NeekoNoNeko/Engineering_Competition/3D/42步进电机连接部件/微信图片_20241001151234.jpg

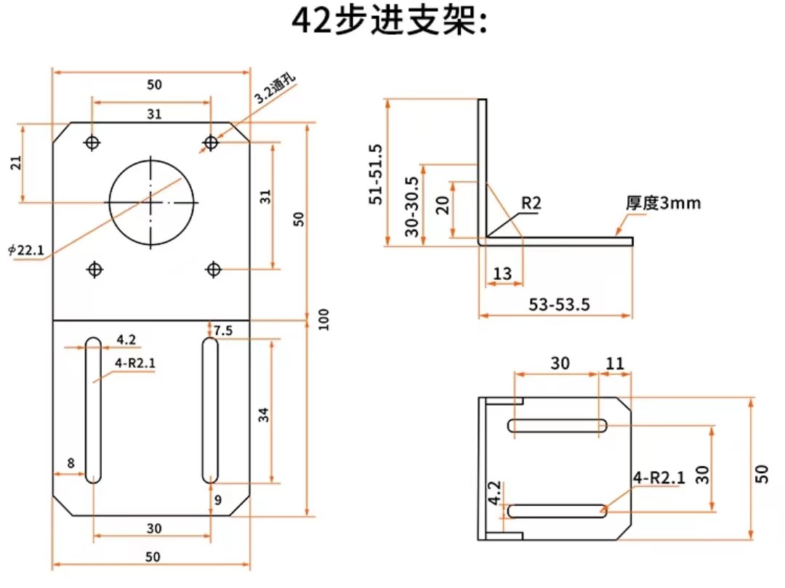
3D/42步进电机连接部件/微信图片_20241001151234.jpg
