NeekoNoNeko/Engineering_Competition/3D/SolidWorks/备份/42.jpg

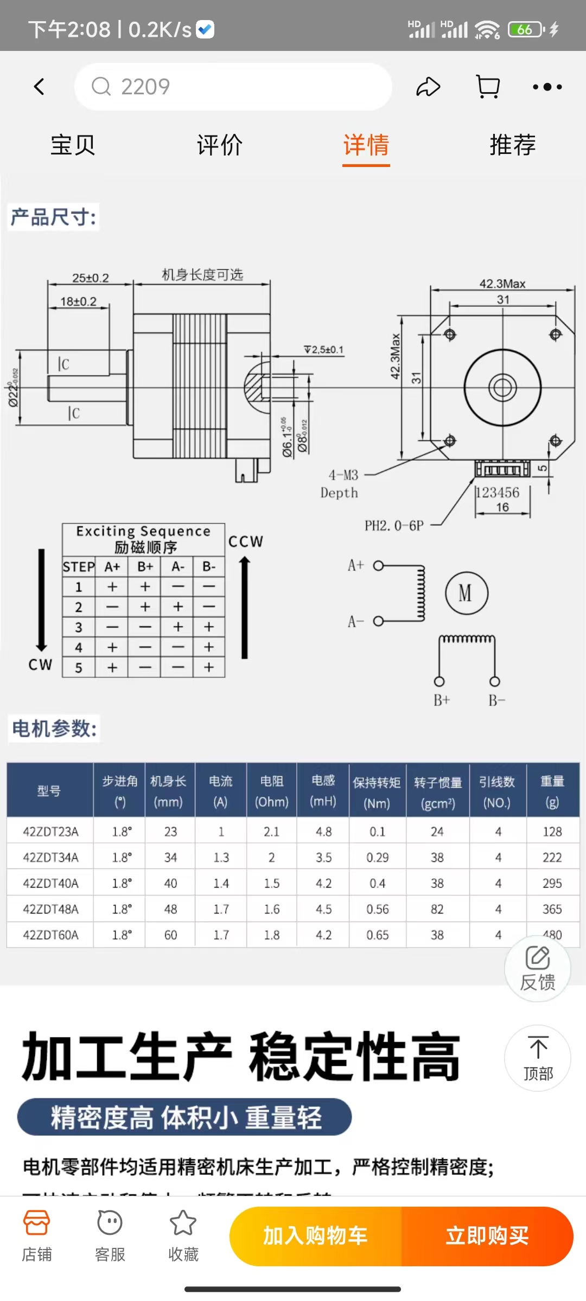
3D/SolidWorks/备份/42.jpg
