NeekoNoNeko/Engineering_Competition/3D/SolidWorks/备份/93cb4cf8e45870571cec4679b83ad59.jpg

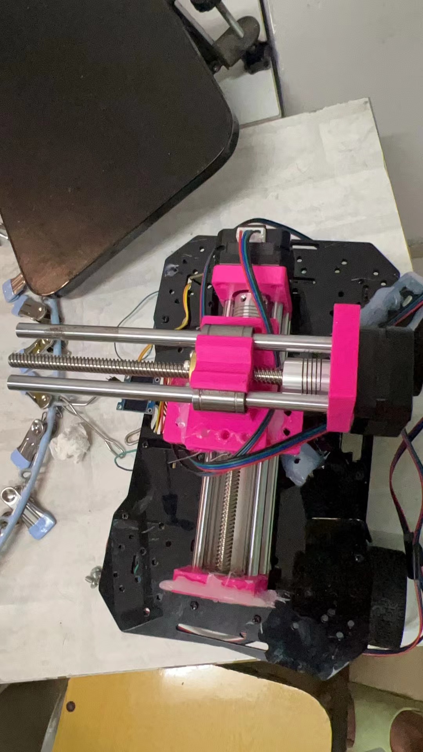
3D/SolidWorks/备份/93cb4cf8e45870571cec4679b83ad59.jpg
