NeekoNoNeko/Engineering_Competition/3D/SolidWorks/备份/KFL08丝杆座.jpg

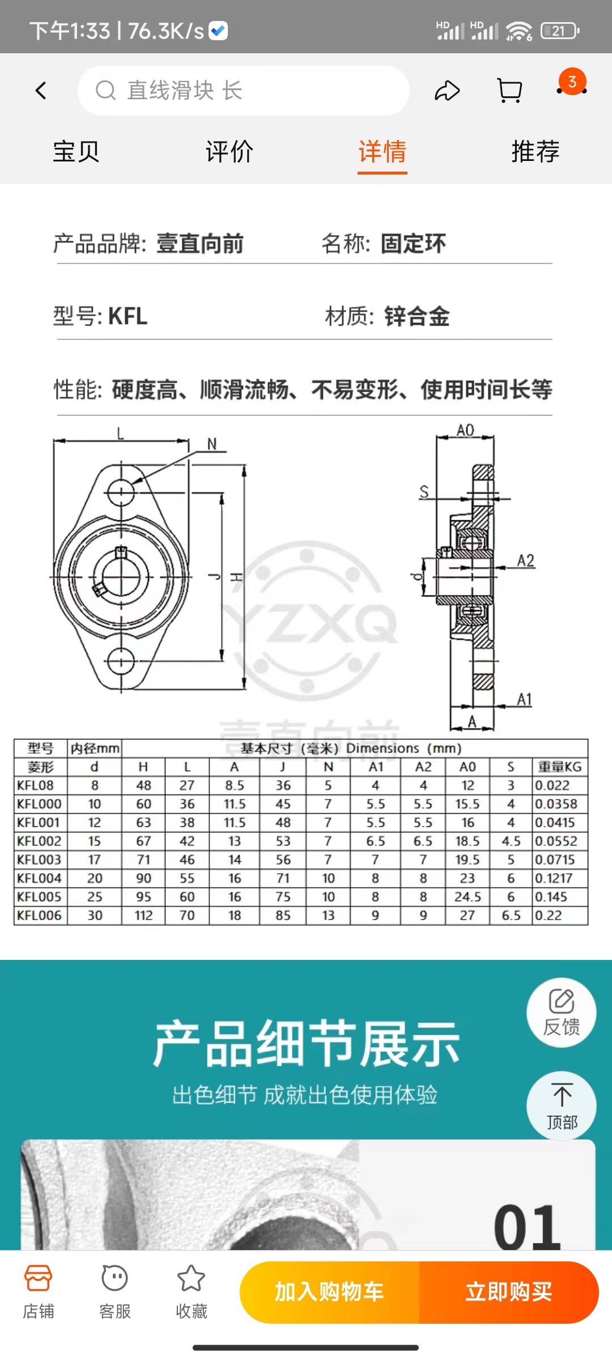
3D/SolidWorks/备份/KFL08丝杆座.jpg
