NeekoNoNeko/Engineering_Competition/3D/SolidWorks/备份/openmv/apriltag/tag36h11_9.png

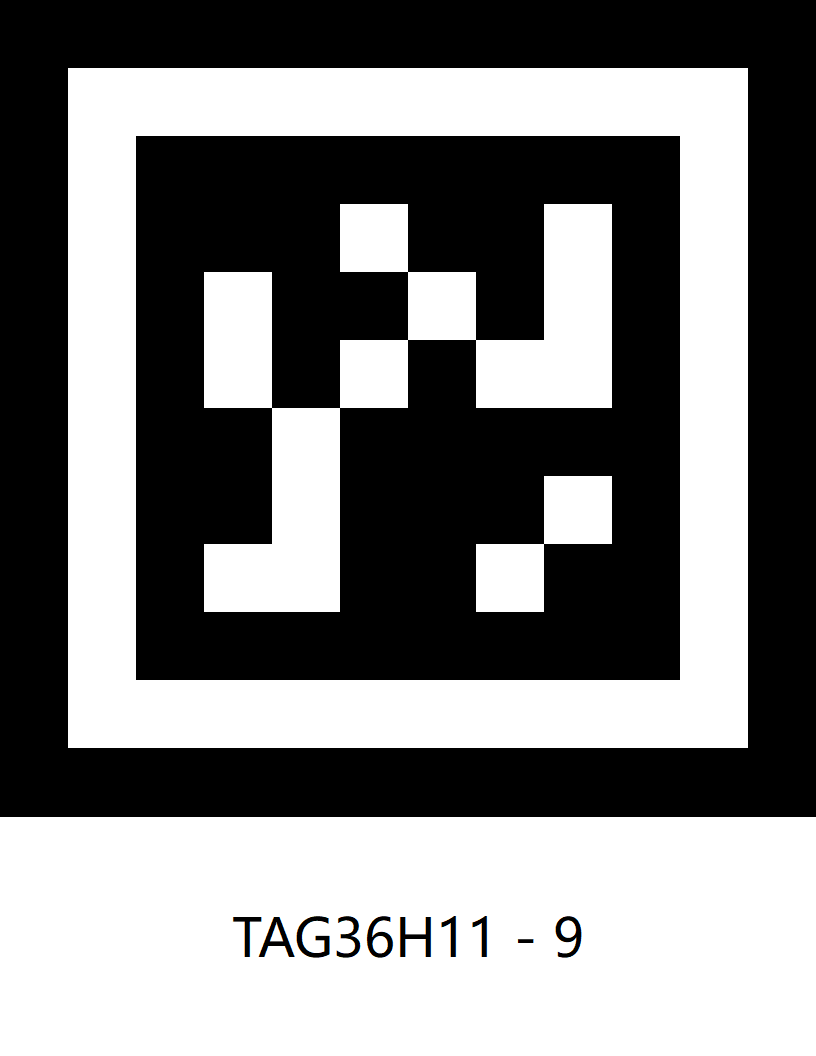
3D/SolidWorks/备份/openmv/apriltag/tag36h11_9.png
