NeekoNoNeko/Engineering_Competition/3D/SolidWorks/备份/SK8光轴座.png

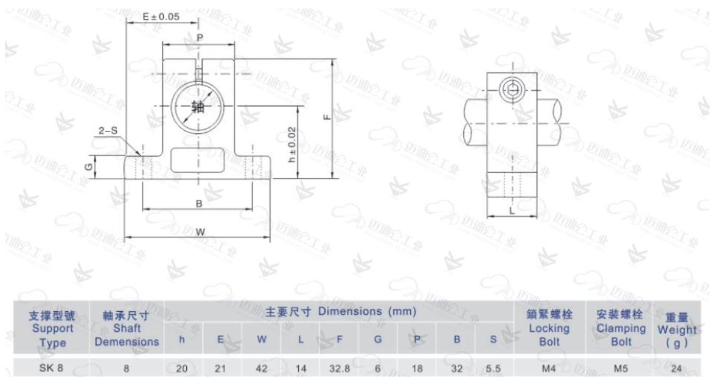
3D/SolidWorks/备份/SK8光轴座.png
