NeekoNoNeko/Engineering_Competition/3D/SolidWorks/备份/try.bmp

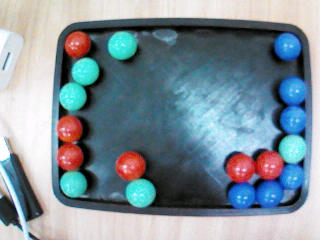
3D/SolidWorks/备份/try.bmp
