NeekoNoNeko/Engineering_Competition/3D/SolidWorks/备份/伺服电机MG996R舵机/temp/reference datasheet/Main reference.jpg

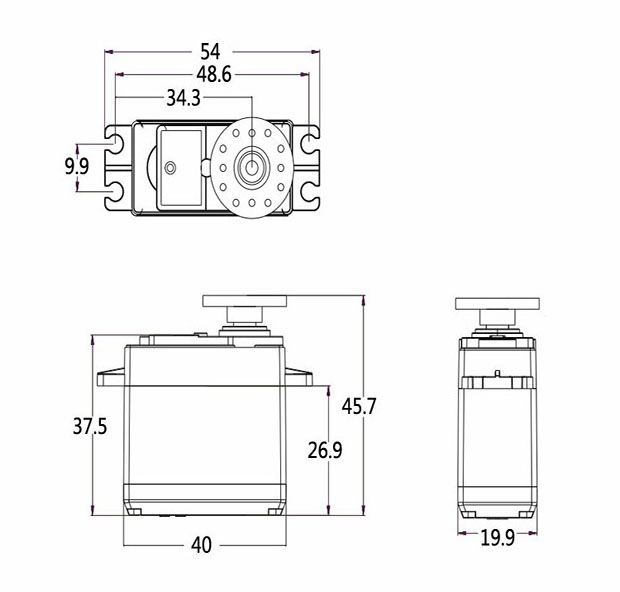
3D/SolidWorks/备份/伺服电机MG996R舵机/temp/reference datasheet/Main reference.jpg
