NeekoNoNeko/Engineering_Competition/3D/SolidWorks/备份/伺服电机MG996R舵机/temp/reference datasheet/others.png

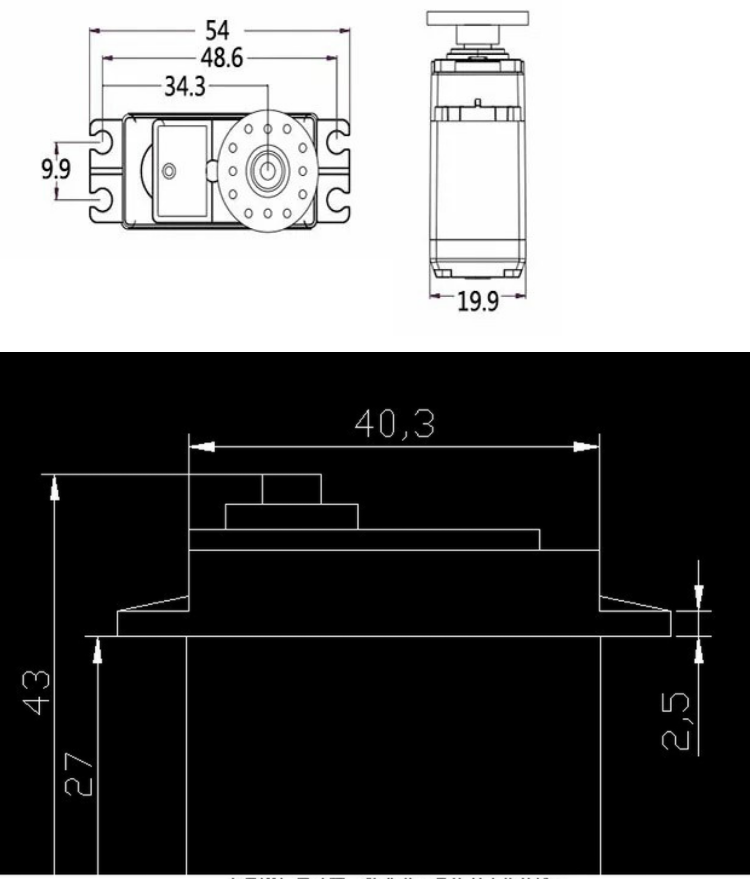
3D/SolidWorks/备份/伺服电机MG996R舵机/temp/reference datasheet/others.png
