NeekoNoNeko/Engineering_Competition/3D/SolidWorks/备份/矢量概念机械臂爪标准伺服/temp/3.JPG

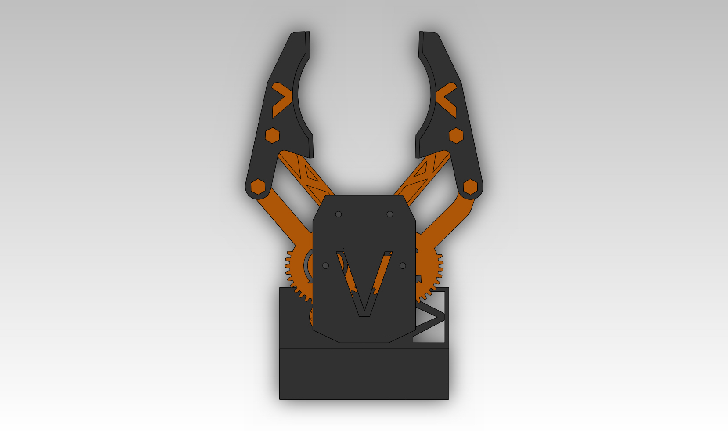
3D/SolidWorks/备份/矢量概念机械臂爪标准伺服/temp/3.JPG
