NeekoNoNeko/Engineering_Competition/file/机器结构图纸/266a45ca8b23765033c3c1784f71e38.png

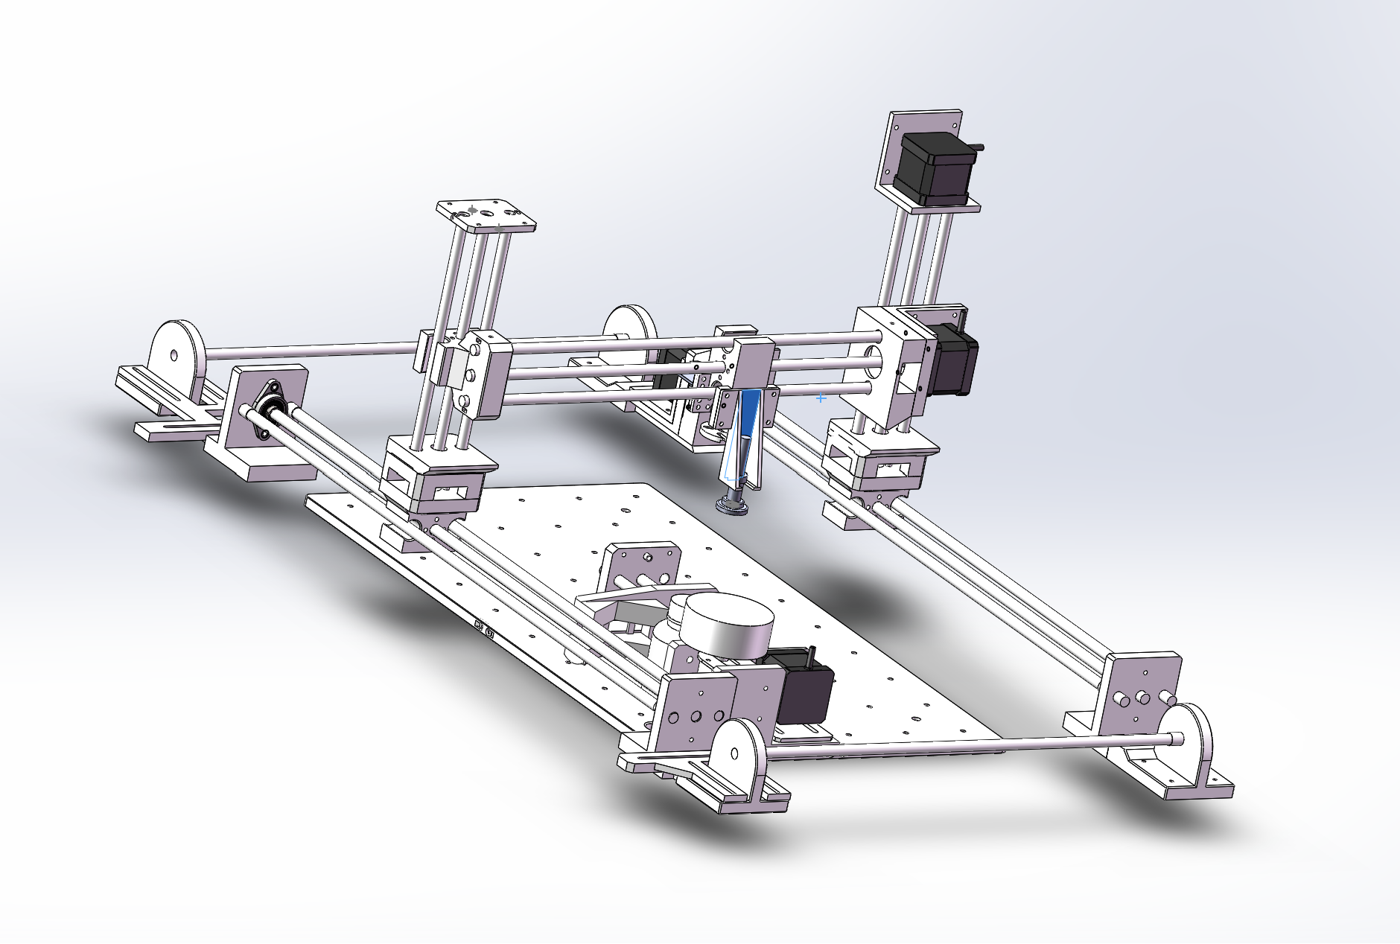
file/机器结构图纸/266a45ca8b23765033c3c1784f71e38.png
