NeekoNoNeko/Engineering_Competition/file/机器结构图纸/OpenMV支架.png

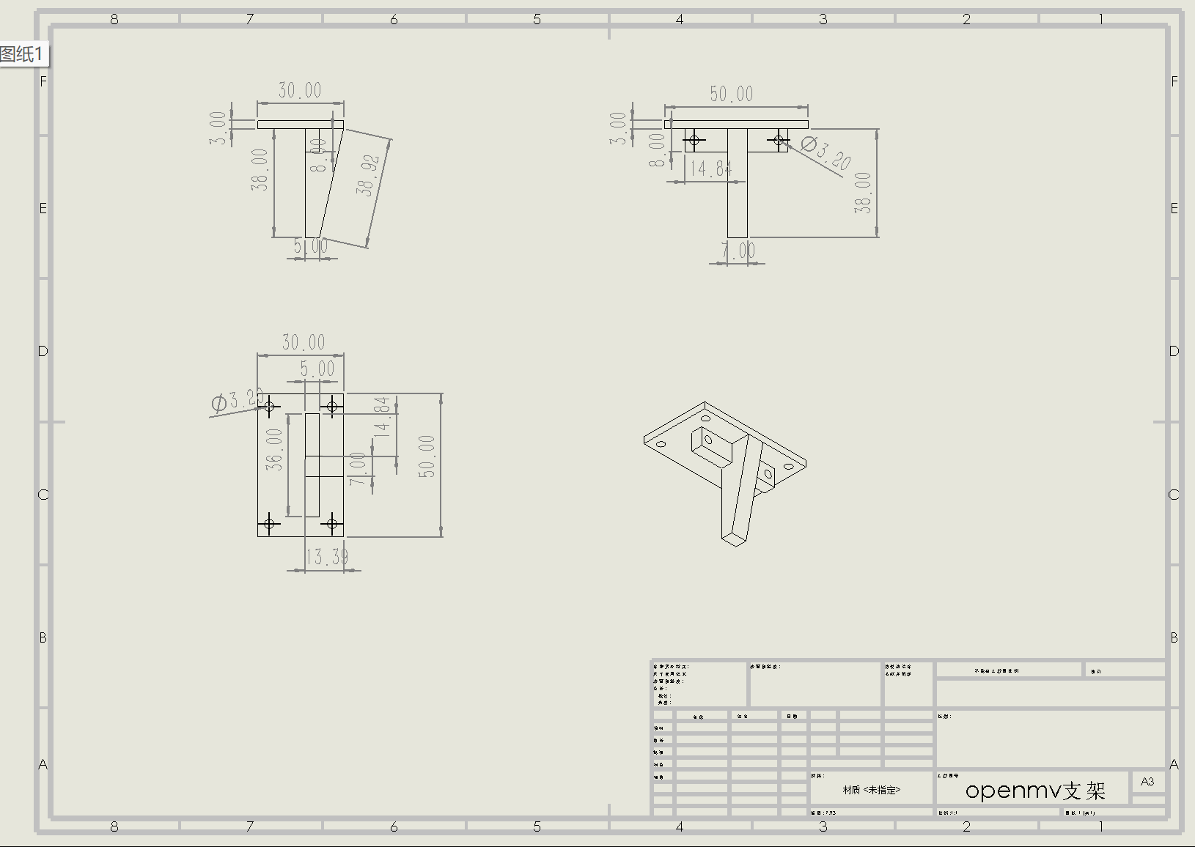
file/机器结构图纸/OpenMV支架.png
