NeekoNoNeko/Engineering_Competition/3D/总装测试/物料表.xlsx

物料名称 | 编号 | 单价 | 数量 | 总计 | 位置
压铸角码套装 |  | 1.14 | 16 | 18.24
M5套装(L10) |  |  | 28 |  | 丝杆支架
 |  |  | 8 |  | XY轴电机支架
 |  |  | 12 |  | 防撞台
 |  |  | 8 |  | 光轴连接器
 |  |  | 4
平垫圈M3 | EPDA-S1W-K-3 |  | 8 |  | 法兰型导向轴支座 | 垫片多买(垫高度)
 |  |  | 12 |  | (电机支架)
内六角圆柱头螺钉M3-L20 | EDLA-S1-M3-L20 |  | 8
法兰型导向轴支座T形 | BEUP-K-D8 |  | 4
十字槽盘头螺钉M3-L6 | EDLU-S1-M-M3-L6 |  | 12 |  | 电机支架
十字槽沉头螺钉M3-L18 | EDLW-S1-M3-L18 |  | 12
十字槽沉头螺钉M3-L6 | EDLW-S1-M3-L6 |  | 8 |  | 滑台螺丝
十字槽沉头螺钉M3-L8 | EDLW-S1-M3-L8 |  | 6 |  | 滑台连型材螺丝
T型螺母M3 | TPAA-N-6-M3 |  | 20 |  | 滑台连型材螺母
内六角圆柱头螺钉M3-L16 | EDLA-S1-M3-L16 |  | 16 |  | 垫块螺丝
内六角圆柱头螺钉M5-L8 | EDLA-S1-M5-L8 |  | 12 |  | 侧面螺丝
内六角圆柱头螺钉M3-L10 | EDLA-S1-M3-L10 |  | 4 |  | 侧面螺丝
内六角圆柱头螺钉M3-L12 | EDLW-S1-M3-L12 |  | 8 |  | 丝杆螺母螺钉
内六角圆柱头螺钉M5-L12 | EDLA-S1-M5-L12 |  | 16 |  | 侧面支撑
 |  |  | 8 |  | 丝杆组合套+T型滑台连型材
平垫圈M5 |  |  | 16 |  | 侧面支撑
 |  |  | 8 |  | 丝杆组合套+T型滑台连型材
T型螺母M5 |  |  | 16 |  | 侧面支撑
十字槽沉头螺钉M3L-20 | EDLW-S1-M3-L20
内六角圆柱头螺钉M3-L8 | EDLA-S1-M3-L8 |  | 8 |  | Z轴滑台
十字槽盘头螺钉M3-L45 |  |  | 8 |  | Z轴滑台
内六角圆柱头螺钉M3-L6 | EDLA-S1-M3-L6 |  | 4 |  | Y轴滑台
