NeekoNoNeko/Engineering_Competition/3D/SolidWorks/备份/KFL08/KFL08.SLDASM

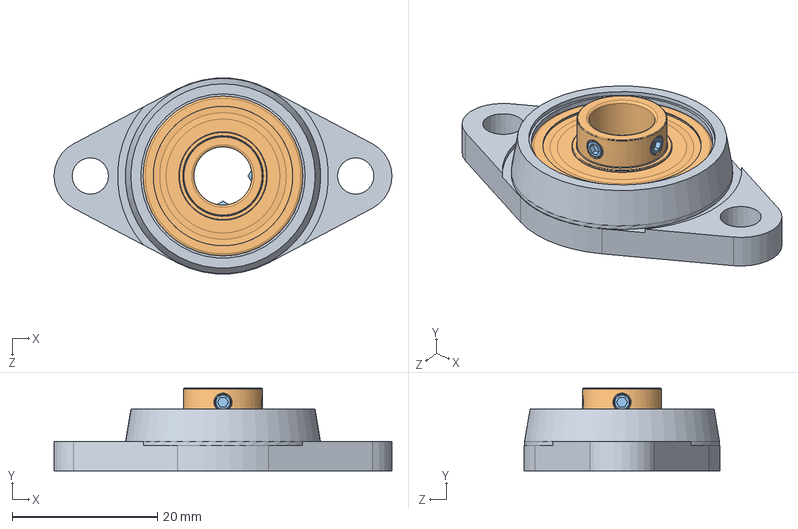
[picture p48: CAD file, 2024-10-24]
3D/SolidWorks/备份/KFL08/KFL08.SLDASM
46.5 x 11.4 x 26.9 mm
FLANGE^KFL08
BEARING^KFL08
socket set screw cone point_am x 2
