NeekoNoNeko/Engineering_Competition/3D/SolidWorks/备份/链接滑台装配体.SLDASM

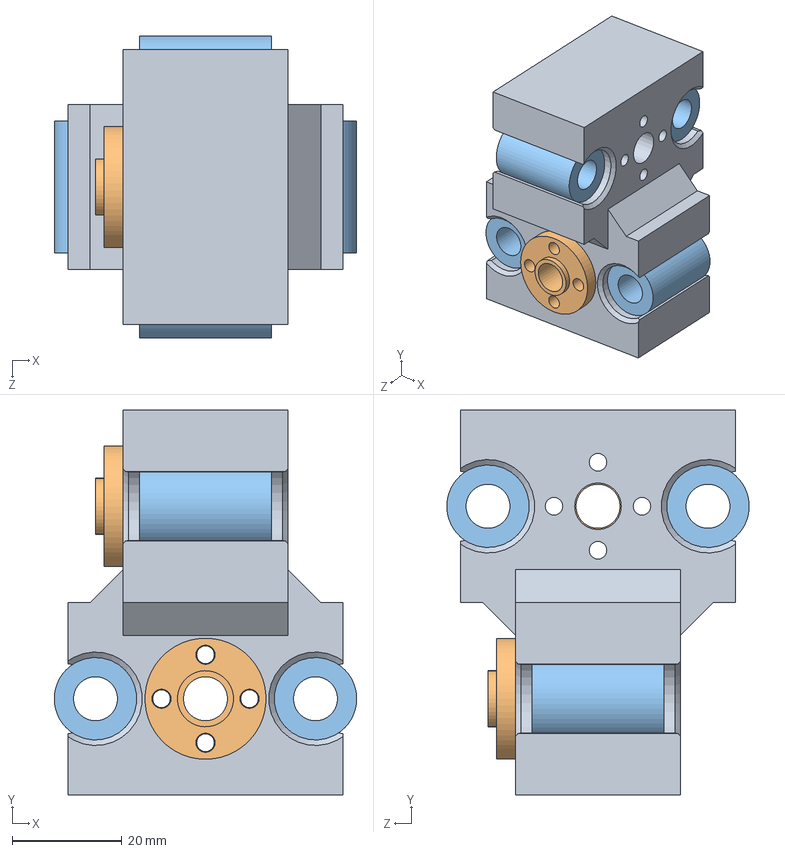
[picture p49: CAD file, 2024-10-24]
3D/SolidWorks/备份/链接滑台装配体.SLDASM
55.0 x 70.0 x 55.0 mm
链接滑台
丝杆螺母 x 2
直线轴承2.0 x 4
