NeekoNoNeko/Engineering_Competition/3D/SolidWorks/备份/底盘.SLDASM

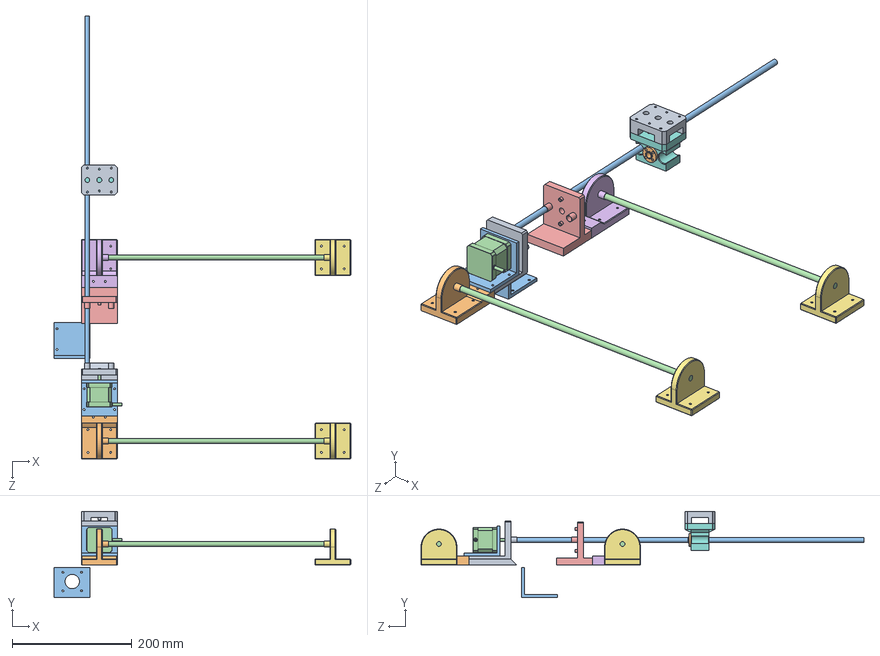
[picture p50: CAD file, 2024-10-24]
3D/SolidWorks/备份/底盘.SLDASM
495.3 x 143.8 x 740.0 mm
近电机端3.0
远电机端3.0右
光轴600
光轴400mm x 2
远电机端4.0
远电机端3.0左
远电机端3.0中 x 2
滑台4.0
远电机端小车.032.0
丝杆螺母
电机支架4.0 x 2
42系列两相混合式步进电机[42HS04A]
