NeekoNoNeko/Engineering_Competition/3D/SolidWorks/备份/钢制KK模组直线滑台TKK100[TKK100-1080]/钢制KK模组直线滑台TKK100[TKK100-1080].sldasm

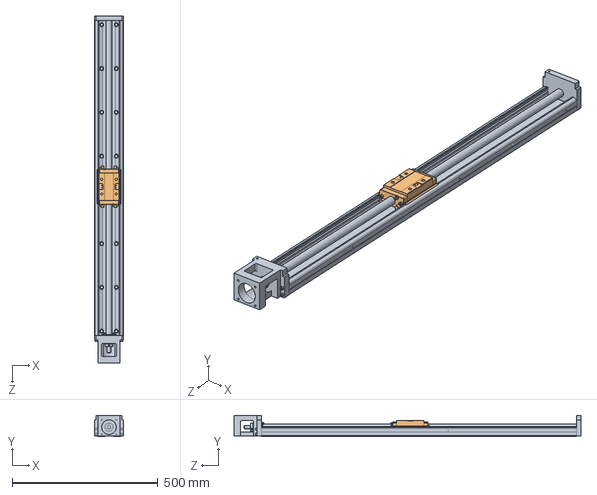
[picture p51: CAD file, 2024-10-24]
3D/SolidWorks/备份/钢制KK模组直线滑台TKK100[TKK100-1080]/钢制KK模组直线滑台TKK100[TKK100-1080].sldasm
100.0 x 72.0 x 1189.0 mm
钢制KK模组直线滑台TKK100[TKK100-1080]_1
钢制KK模组直线滑台TKK100[TKK100-1080]_2
