NeekoNoNeko/Engineering_Competition/3D/SolidWorks/备份/梯形丝杠╱梯形丝杆螺母[TN8X10X2NR╱200×200Cu]/梯形丝杠╱梯形丝杆螺母[TN8X10X2NR╱200×200Cu].sldasm

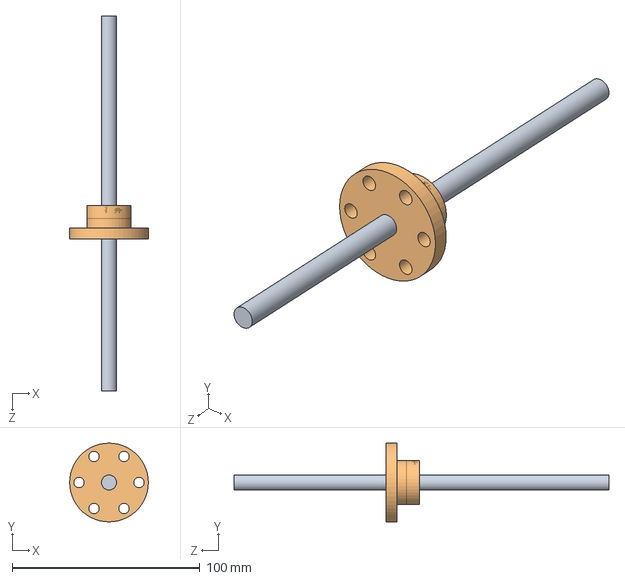
[picture p52: CAD file, 2024-10-24]
3D/SolidWorks/备份/梯形丝杠╱梯形丝杆螺母[TN8X10X2NR╱200×200Cu]/梯形丝杠╱梯形丝杆螺母[TN8X10X2NR╱200×200Cu].sldasm
42.0 x 42.0 x 200.0 mm
梯形丝杠╱梯形丝杆螺母[TN8X10X2NR╱200×200Cu]_丝杠
梯形丝杠╱梯形丝杆螺母[TN8X10X2NR╱200×200Cu]_螺母
