NeekoNoNeko/Engineering_Competition/3D/SolidWorks/备份/滑台装配体.SLDASM

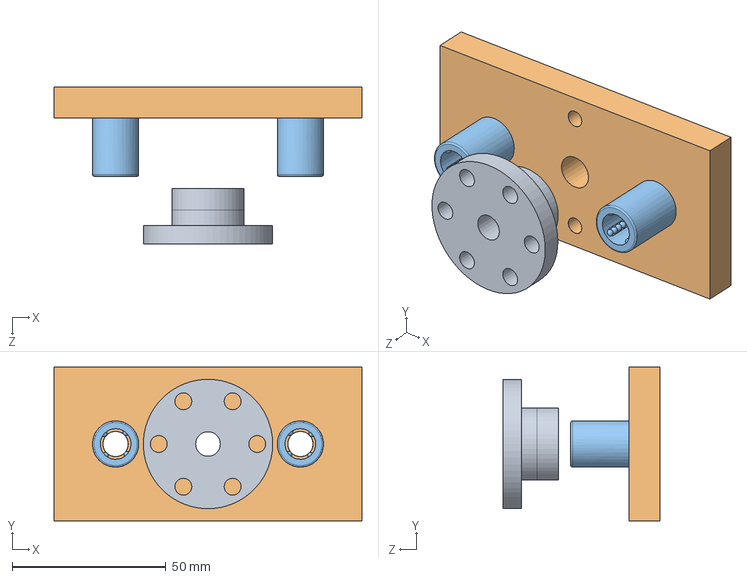
[picture p53: CAD file, 2024-10-24]
3D/SolidWorks/备份/滑台装配体.SLDASM
100.0 x 50.0 x 51.0 mm
螺母
直线轴承LMF-K-H系列[LMF8UU] x 2
