NeekoNoNeko/Engineering_Competition/3D/SolidWorks/XY连接装配体短.SLDASM

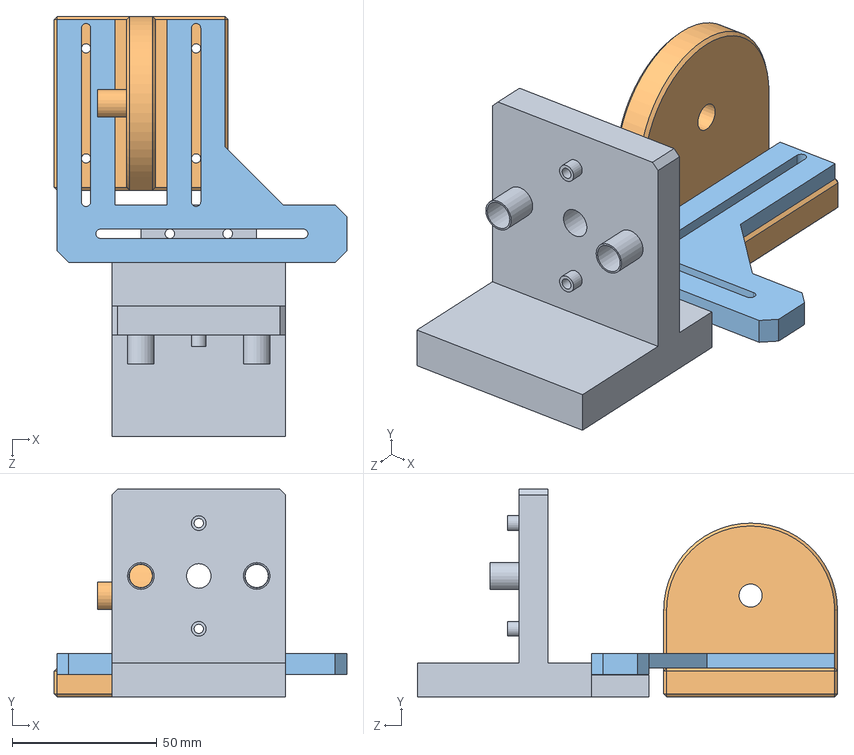
[picture p54: CAD file, 2024-10-24]
3D/SolidWorks/XY连接装配体短.SLDASM
101.0 x 71.8 x 145.0 mm
远电机端4.0
远电机端3.0中
XY连接短
