NeekoNoNeko/Engineering_Competition/3D/SolidWorks/备份/远电机右转向.SLDASM

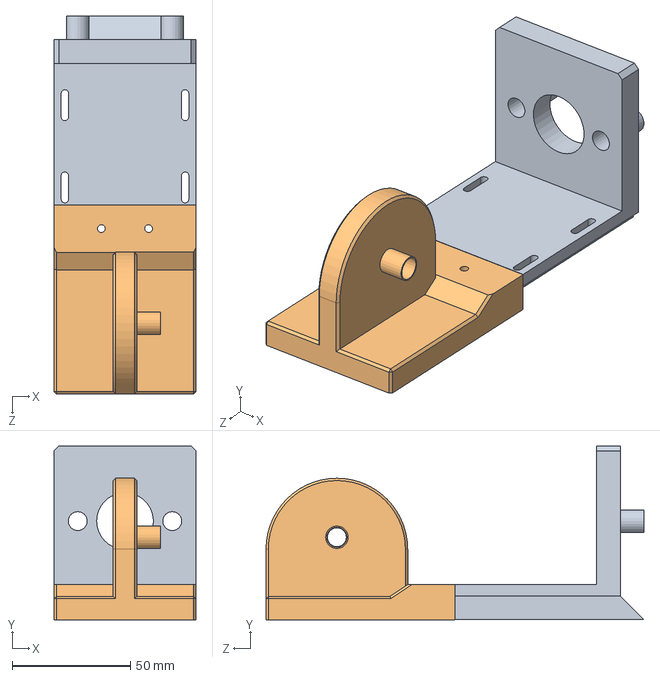
[picture p56: CAD file, 2024-10-24]
3D/SolidWorks/备份/远电机右转向.SLDASM
60.0 x 73.6 x 160.0 mm
近电机端3.0
远电机端3.0
