NeekoNoNeko/Engineering_Competition/3D/SolidWorks/备份/高横杆装配体.SLDASM

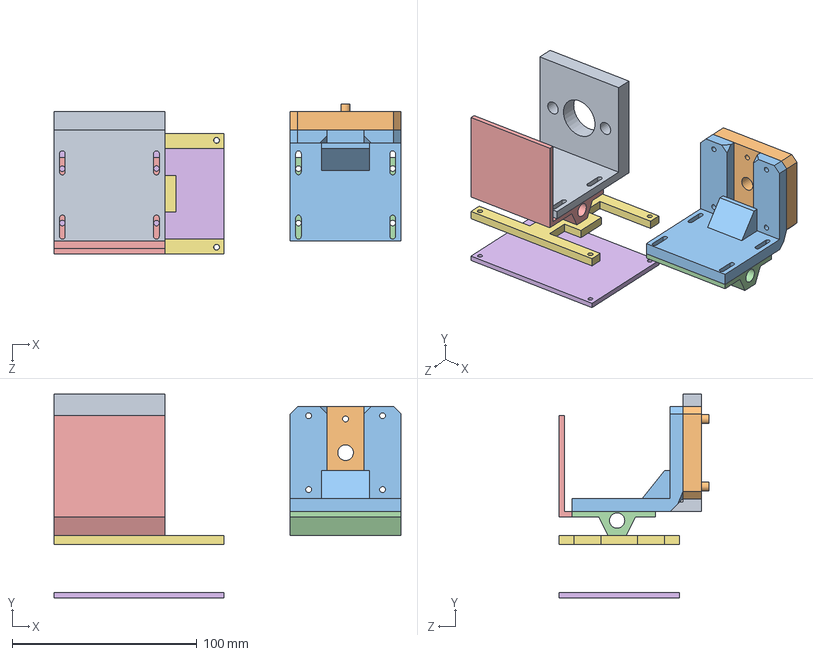
[picture p57: CAD file, 2024-10-24]
3D/SolidWorks/备份/高横杆装配体.SLDASM
187.9 x 110.4 x 81.0 mm
近电机端2.0
远电机端.3.0
高连接横梁右远电机端
高连接横梁右2
高连接横梁左2
主控板
主控板支撑
