NeekoNoNeko/Engineering_Competition/3D/SolidWorks/备份/X轴滑台装配体1.SLDASM

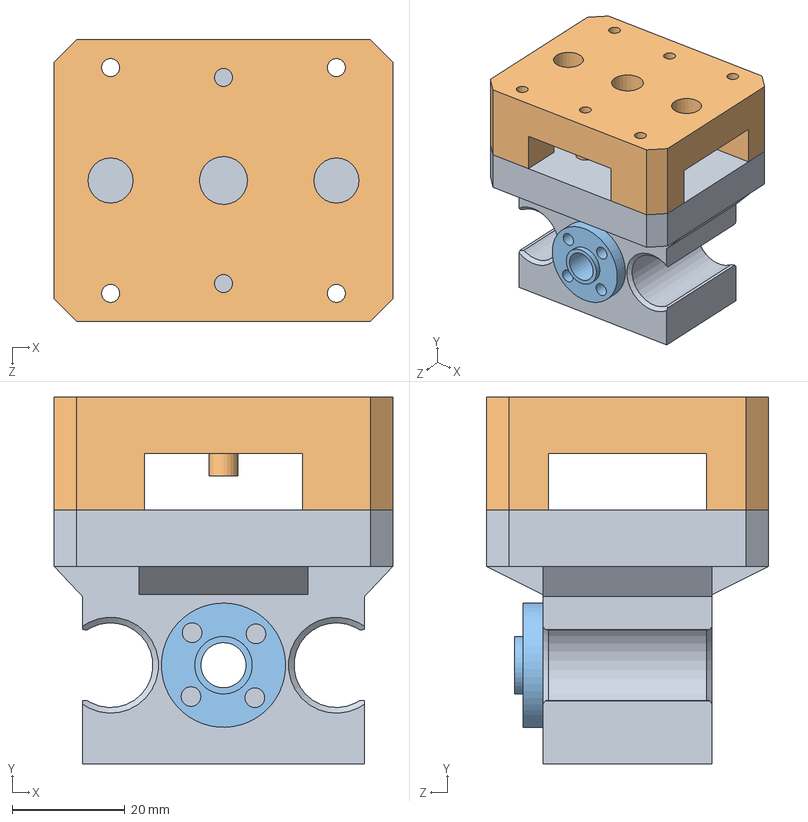
[picture p58: CAD file, 2024-10-24]
3D/SolidWorks/备份/X轴滑台装配体1.SLDASM
60.0 x 65.0 x 50.0 mm
滑台4.0
远电机端小车.032.0
丝杆螺母
