NeekoNoNeko/Engineering_Competition/3D/SolidWorks/备份/连接装配体plusmax.SLDASM

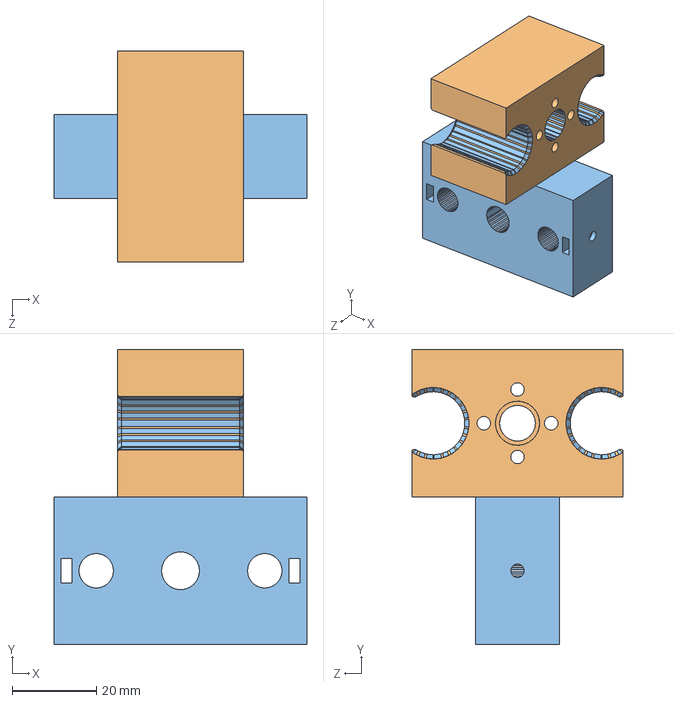
[picture p59: CAD file, 2024-10-24]
3D/SolidWorks/备份/连接装配体plusmax.SLDASM
60.0 x 70.0 x 50.0 mm
