NeekoNoNeko/Engineering_Competition/3D/SolidWorks/备份/仅Y轴.SLDASM

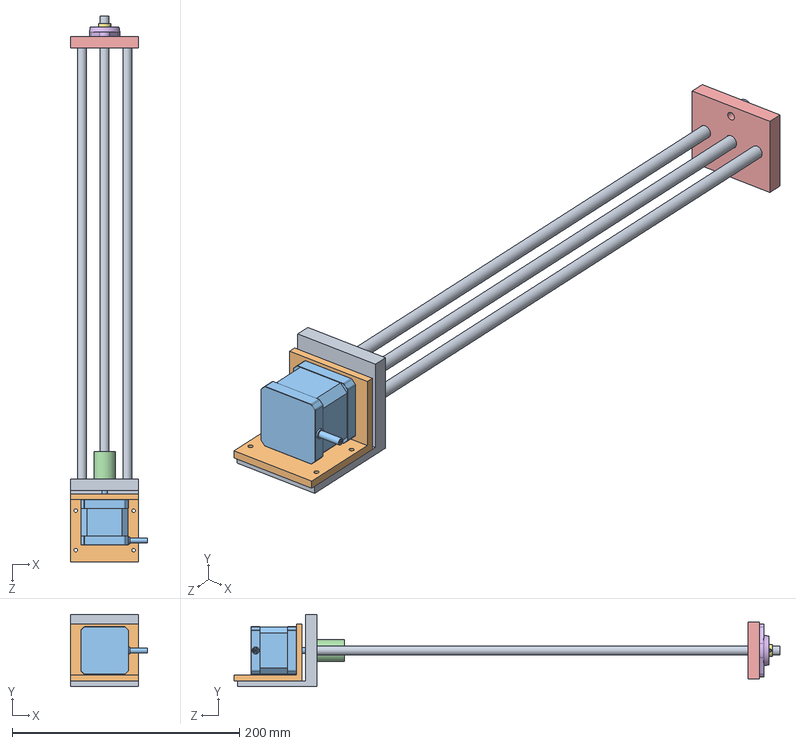
[picture p60: CAD file, 2024-10-24]
3D/SolidWorks/备份/仅Y轴.SLDASM
67.6 x 63.5 x 481.0 mm
近电机端2.0
电机支架4.0
42系列两相混合式步进电机[42HS04A]
弹性联轴器
远电机端2.0
FLANGE^KFL08
BEARING^KFL08
socket set screw cone point_am x 2
光轴400mm x 3
