NeekoNoNeko/Engineering_Competition/3D/SolidWorks/备份/夹子装配体.SLDASM

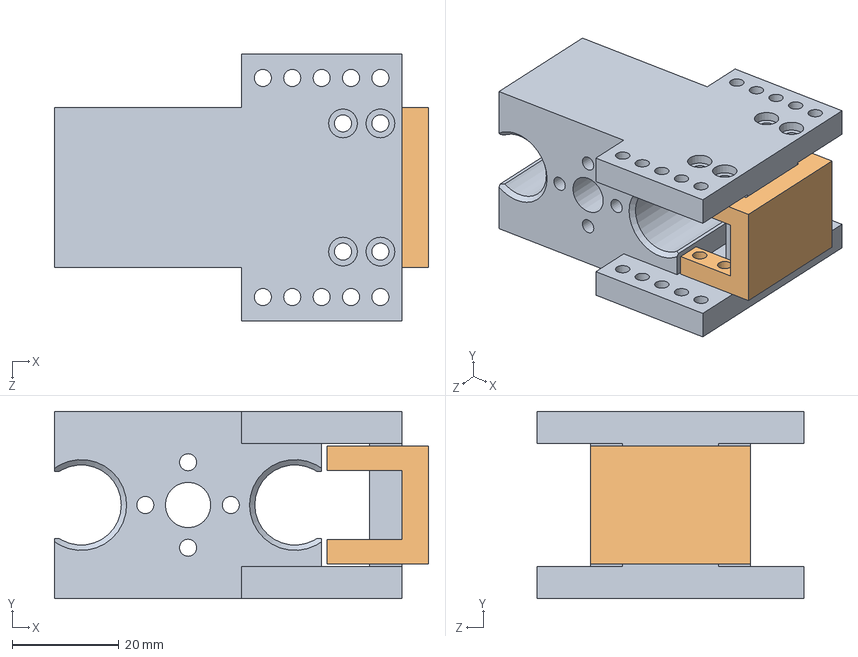
[picture p61: CAD file, 2024-10-24]
3D/SolidWorks/备份/夹子装配体.SLDASM
70.0 x 35.0 x 50.0 mm
滑台支架
夹子
