NeekoNoNeko/Engineering_Competition/3D/SolidWorks/备份/电机支架装配体2.0.SLDASM

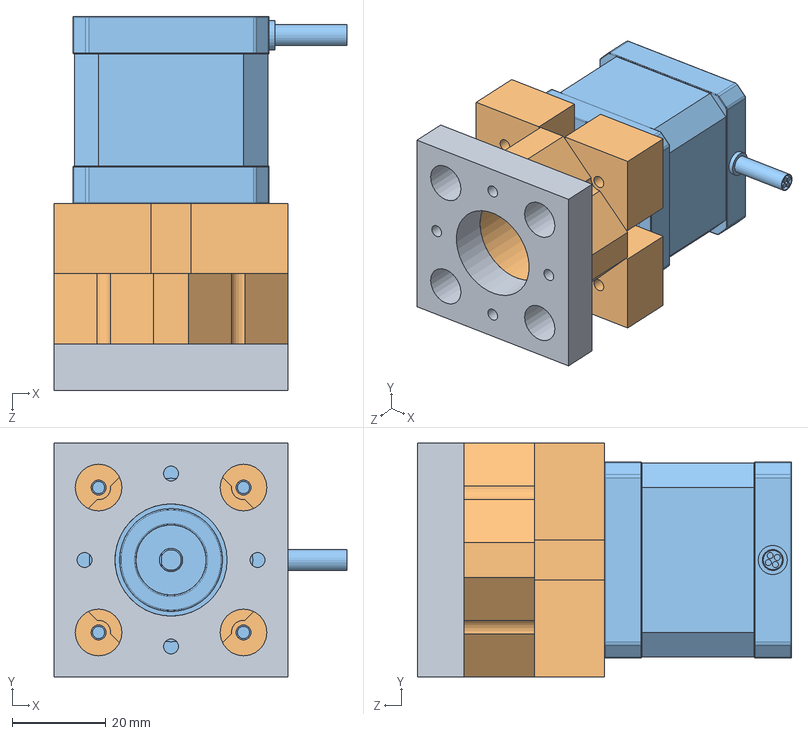
[picture p62: CAD file, 2024-10-24]
3D/SolidWorks/备份/电机支架装配体2.0.SLDASM
62.6 x 50.0 x 80.0 mm
近电机端
电机支架3.0
