NeekoNoNeko/Engineering_Competition/3D/SolidWorks/直流减速电机支架装配体.SLDASM

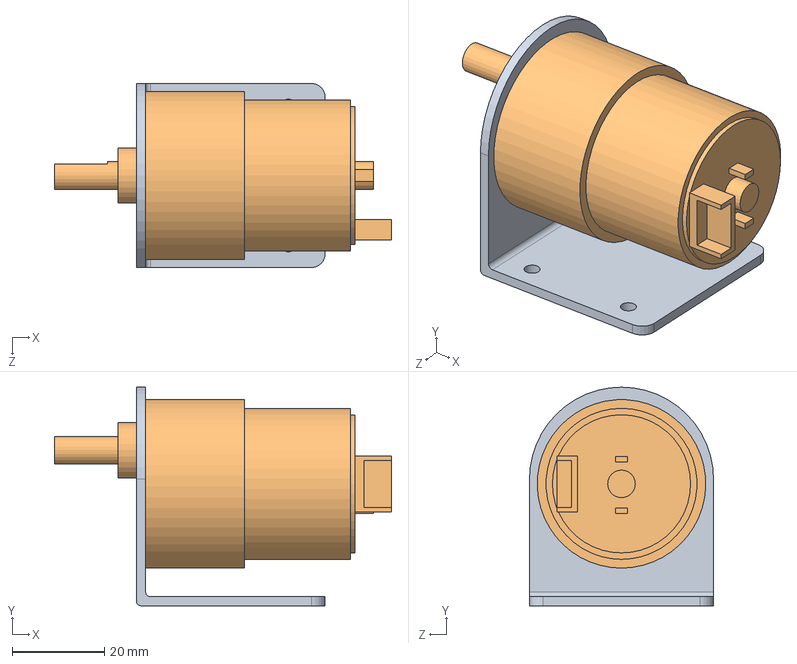
[picture p63: CAD file, 2024-10-24]
3D/SolidWorks/直流减速电机支架装配体.SLDASM
73.2 x 47.5 x 40.0 mm
直流减速电机支架
MG513直流减速电机
