NeekoNoNeko/Engineering_Competition/3D/SolidWorks/挡板.SLDASM

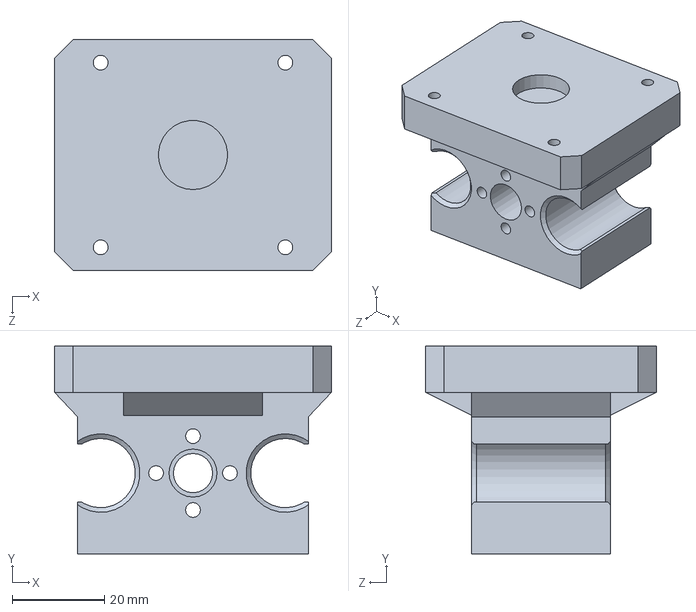
[picture p64: CAD file, 2024-10-24]
3D/SolidWorks/挡板.SLDASM
60.0 x 45.0 x 50.0 mm
