NeekoNoNeko/Engineering_Competition/3D/SolidWorks/备份/滑台装配体3.0.SLDASM

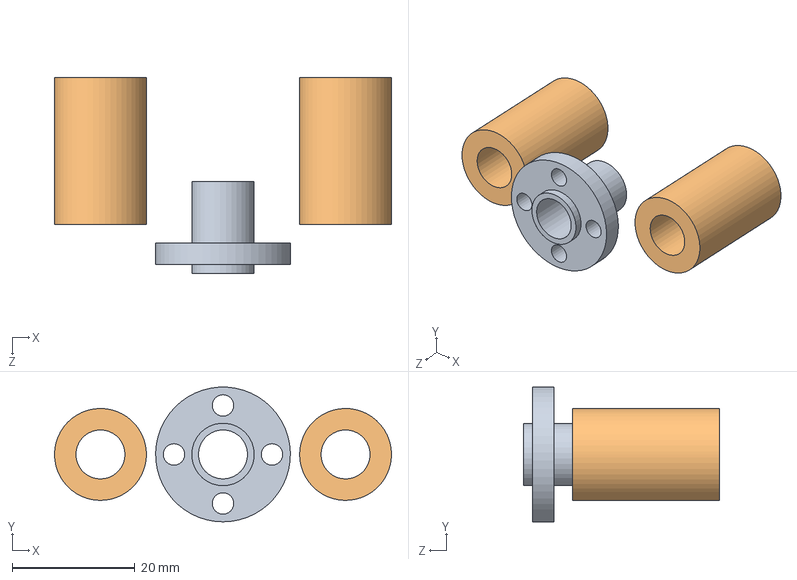
[picture p65: CAD file, 2024-10-24]
3D/SolidWorks/备份/滑台装配体3.0.SLDASM
55.0 x 22.0 x 32.0 mm
丝杆螺母
直线轴承2.0 x 2
