NeekoNoNeko/Engineering_Competition/3D/SolidWorks/连接装配体.SLDASM

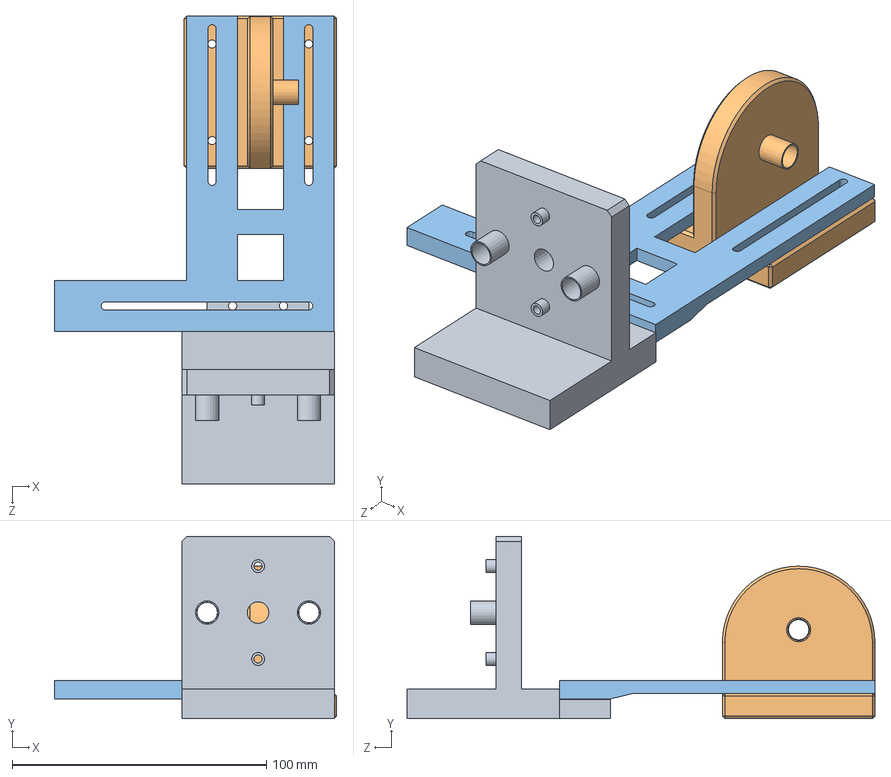
[picture p66: CAD file, 2024-10-24]
3D/SolidWorks/连接装配体.SLDASM
111.0 x 71.8 x 184.0 mm
远电机端4.0
远电机端3.0中
XY连接
