NeekoNoNeko/Engineering_Competition/3D/SolidWorks/备份/远电机端小车装配体.SLDASM

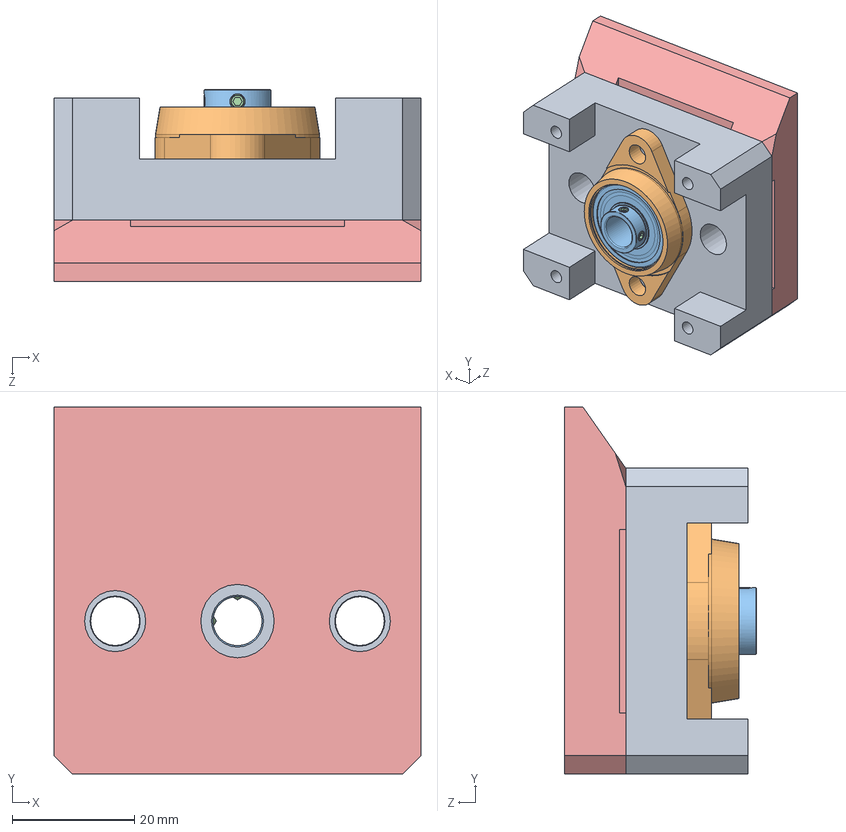
[picture p67: CAD file, 2024-10-24]
3D/SolidWorks/备份/远电机端小车装配体.SLDASM
60.0 x 60.0 x 31.4 mm
远电机端小车2.0
FLANGE^KFL08
BEARING^KFL08
socket set screw cone point_am x 2
Z轴挡板
