NeekoNoNeko/Engineering_Competition/3D/SolidWorks/备份/远电机端装配体.SLDASM

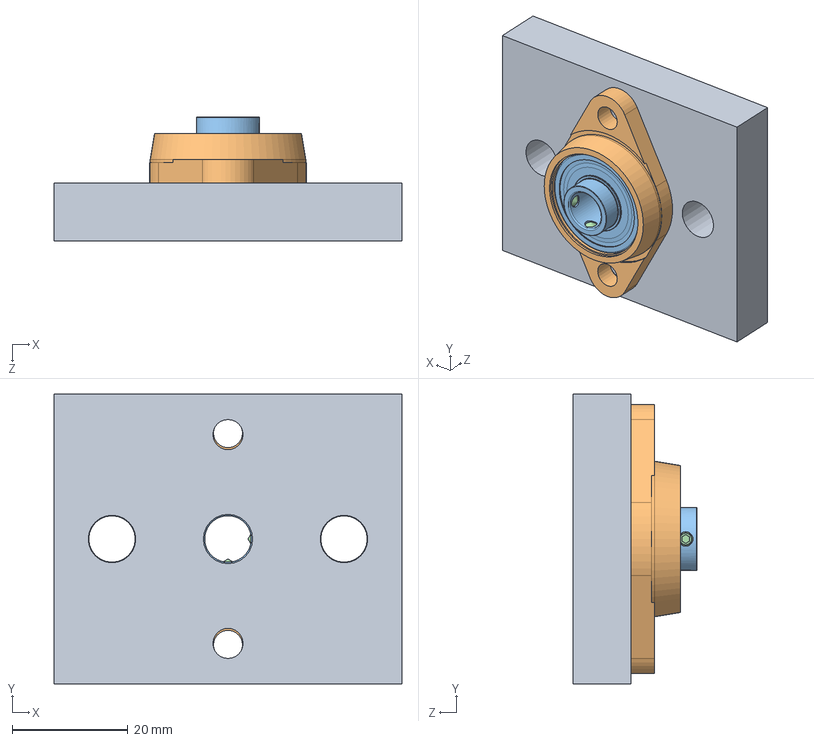
[picture p68: CAD file, 2024-10-24]
3D/SolidWorks/备份/远电机端装配体.SLDASM
60.0 x 50.0 x 21.4 mm
远电机端2.0
FLANGE^KFL08
BEARING^KFL08
socket set screw cone point_am x 2
