NeekoNoNeko/Engineering_Competition/3D/SolidWorks/备份/远电机装配体左.SLDASM

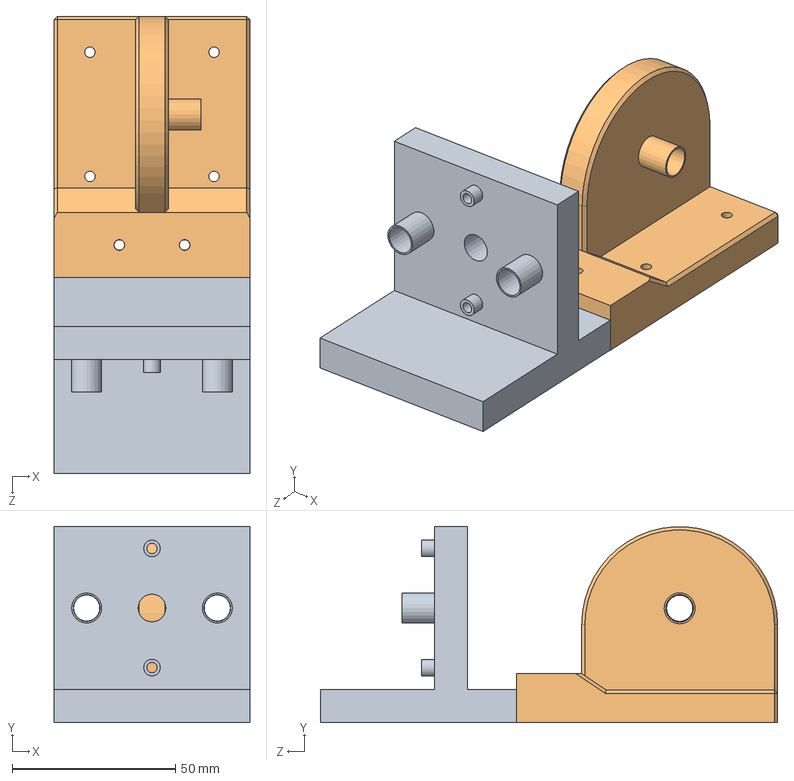
[picture p70: CAD file, 2024-10-24]
3D/SolidWorks/备份/远电机装配体左.SLDASM
60.0 x 60.1 x 140.0 mm
远电机端4.0
远电机端3.0左
