NeekoNoNeko/Engineering_Competition/3D/SolidWorks/备份/电机支架装配体3.0.SLDASM

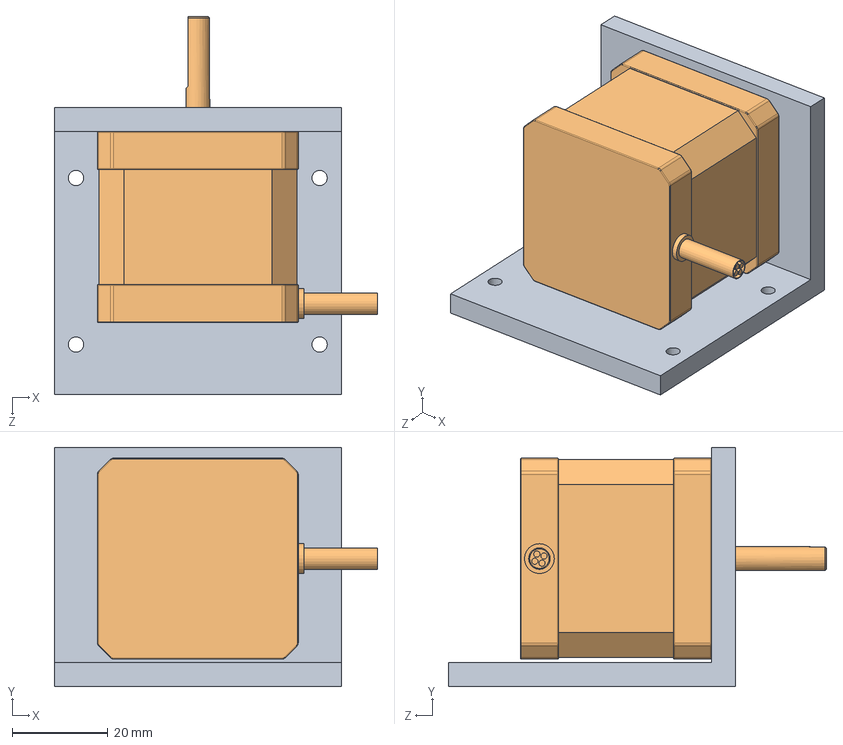
[picture p71: CAD file, 2024-10-24]
3D/SolidWorks/备份/电机支架装配体3.0.SLDASM
67.6 x 50.0 x 79.0 mm
电机支架4.0
42系列两相混合式步进电机[42HS04A]
