NeekoNoNeko/Engineering_Competition/3D/SolidWorks/备份/Z轴.SLDASM

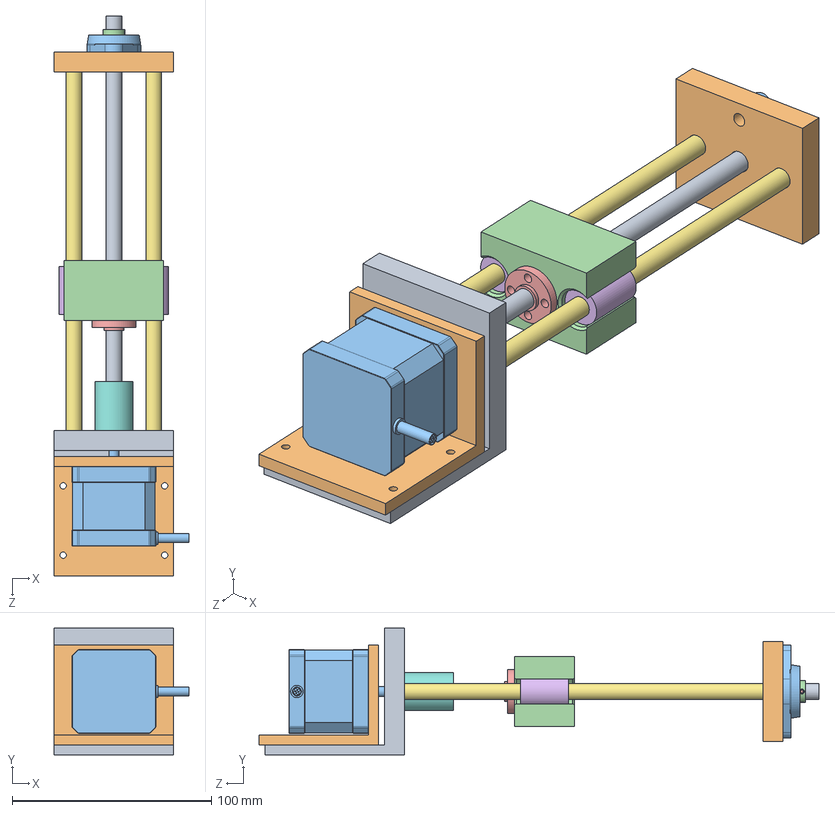
[picture p72: CAD file, 2024-10-24]
3D/SolidWorks/备份/Z轴.SLDASM
67.6 x 63.5 x 281.0 mm
近电机端2.0
电机支架4.0
42系列两相混合式步进电机[42HS04A]
滑台3.0
丝杆螺母
直线轴承2.0 x 2
200mm光轴 x 2
弹性联轴器
丝杠
远电机端2.0
FLANGE^KFL08
BEARING^KFL08
socket set screw cone point_am x 2
