NeekoNoNeko/Engineering_Competition/3D/SolidWorks/备份/电机支架装配体.SLDASM

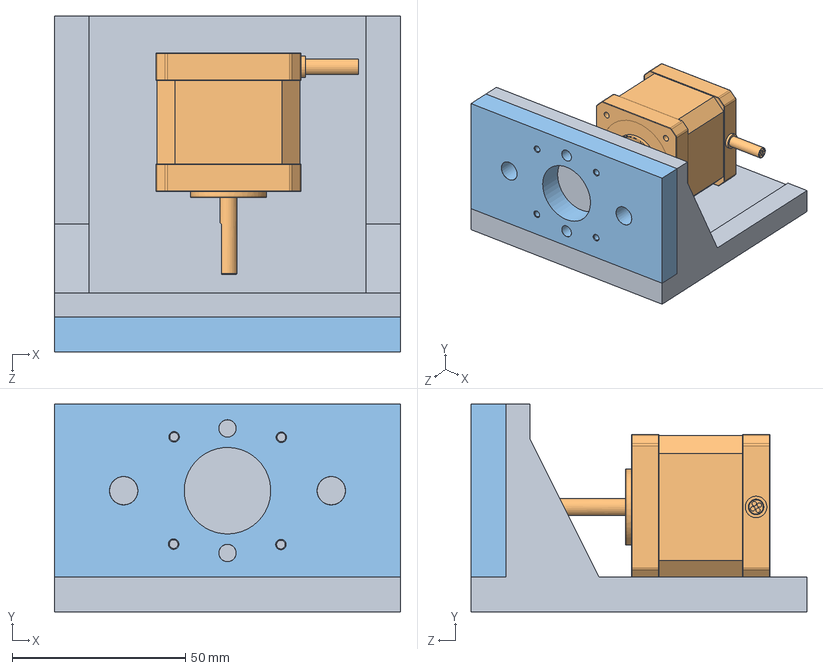
[picture p73: CAD file, 2024-10-24]
3D/SolidWorks/备份/电机支架装配体.SLDASM
100.0 x 60.0 x 97.0 mm
电机支架
42系列两相混合式步进电机[42HS04A]
远电机端
