NeekoNoNeko/Engineering_Competition/3D/SolidWorks/备份/电机装配体1.SLDASM

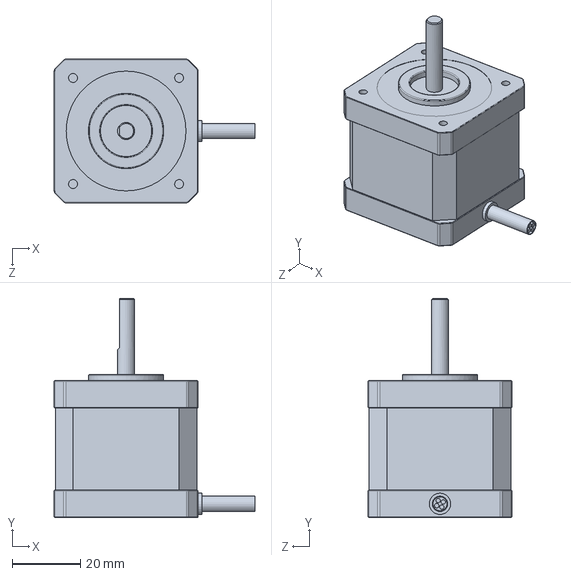
[picture p74: CAD file, 2024-10-24]
3D/SolidWorks/备份/电机装配体1.SLDASM
58.6 x 64.0 x 42.0 mm
