NeekoNoNeko/Engineering_Competition/3D/SolidWorks/备份/滑台装配体2.0.SLDASM

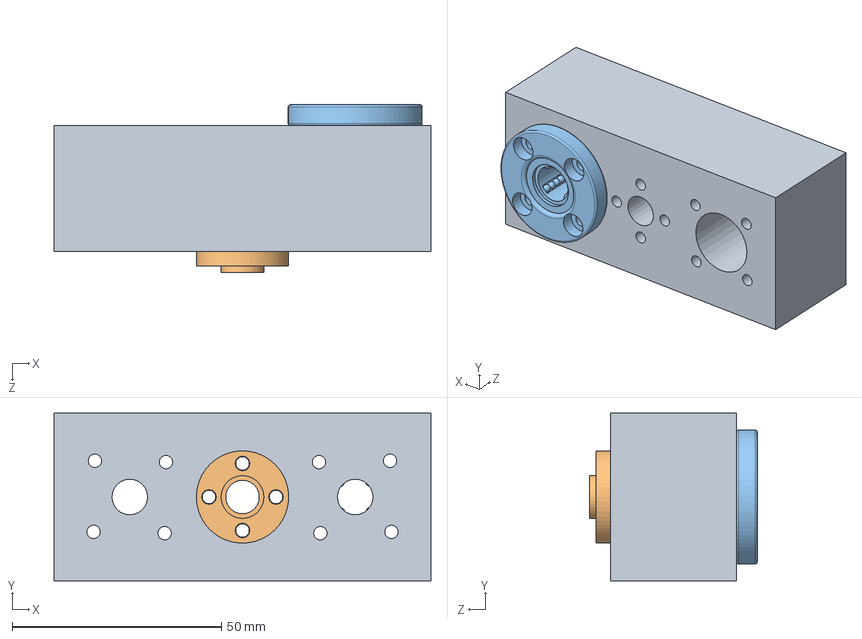
[picture p75: CAD file, 2024-10-24]
3D/SolidWorks/备份/滑台装配体2.0.SLDASM
90.0 x 40.0 x 40.0 mm
滑台2.0
丝杆螺母
