NeekoNoNeko/Engineering_Competition/3D/SolidWorks/备份/支架滑台装配体.SLDASM

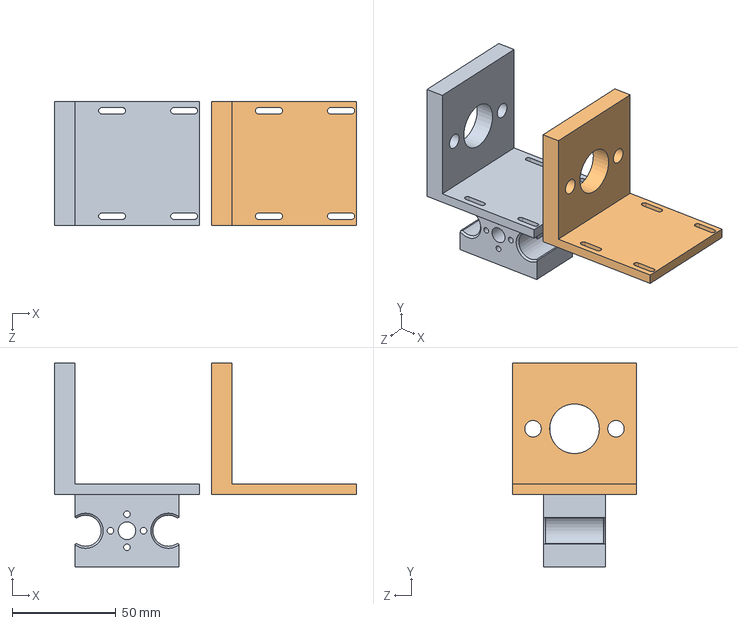
[picture p76: CAD file, 2024-10-24]
3D/SolidWorks/备份/支架滑台装配体.SLDASM
145.8 x 98.5 x 60.0 mm
支架滑台
近电机端2.0
