NeekoNoNeko/Engineering_Competition/3D/SolidWorks/备份/底座.SLDASM

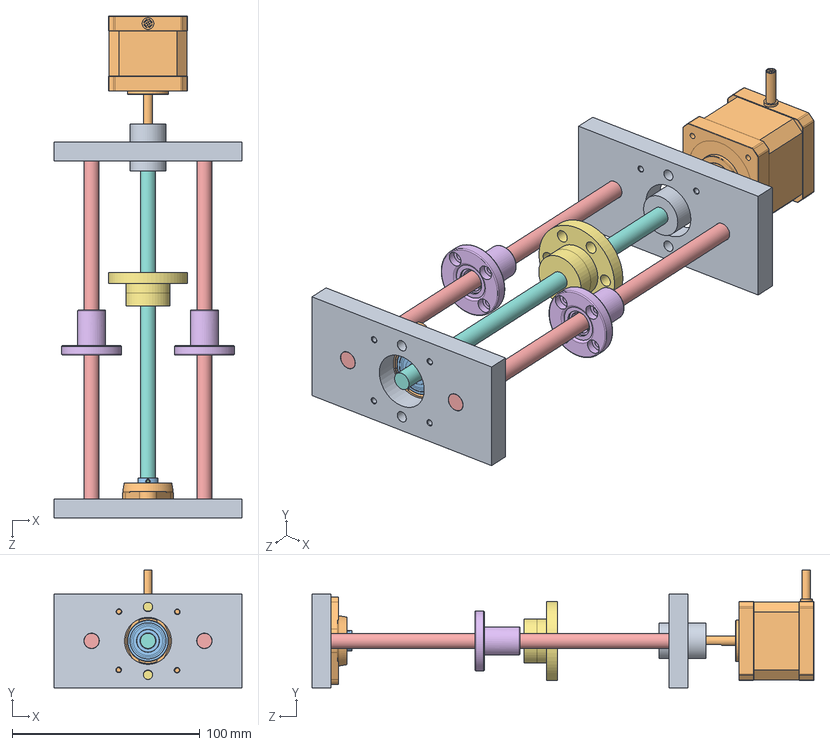
[picture p78: CAD file, 2024-10-24]
3D/SolidWorks/备份/底座.SLDASM
100.0 x 62.6 x 267.0 mm
远电机端 x 2
FLANGE^KFL08
socket set screw cone point_am x 2
200mm光轴 x 2
直线轴承LMF-K-H系列[LMF8UU] x 2
螺母
丝杠
弹性联轴器
42系列两相混合式步进电机[42HS04A]
