NeekoNoNeko/Engineering_Competition/3D/SolidWorks/备份/气泵.SLDASM

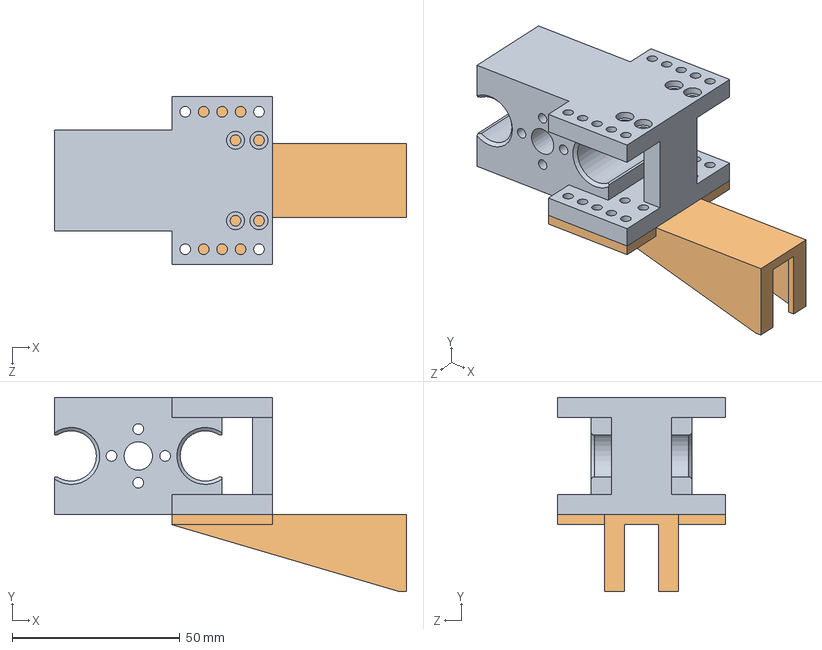
[picture p79: CAD file, 2024-10-24]
3D/SolidWorks/备份/气泵.SLDASM
105.0 x 58.0 x 50.0 mm
滑台支架
气泵零件
