NeekoNoNeko/Engineering_Competition/3D/SolidWorks/备份/XYZ轴装配体.SLDASM

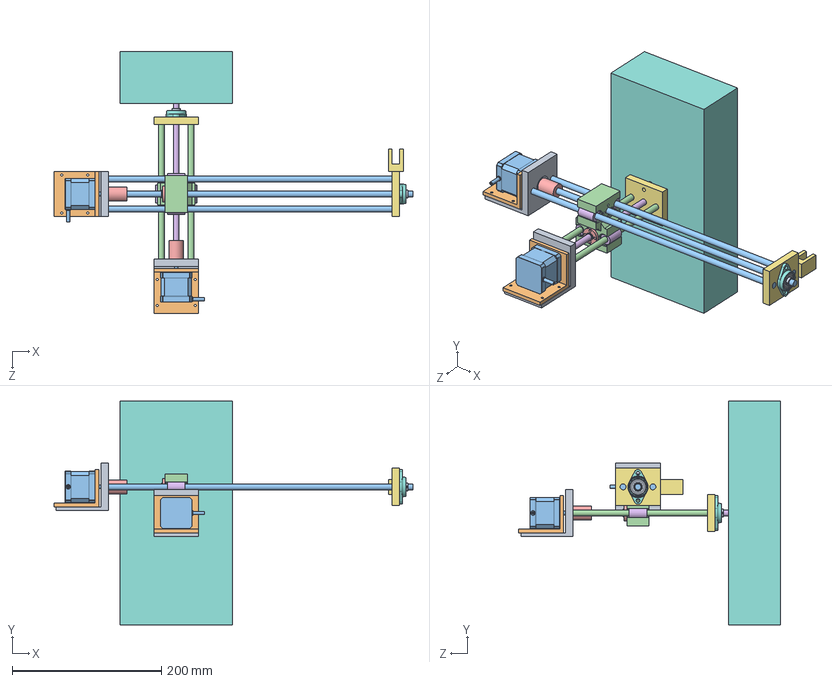
[picture p80: CAD file, 2024-10-24]
3D/SolidWorks/备份/XYZ轴装配体.SLDASM
481.0 x 300.0 x 350.5 mm
近电机端2.0 x 2
电机支架4.0 x 2
42系列两相混合式步进电机[42HS04A] x 2
200mm光轴 x 2
弹性联轴器 x 2
丝杠
远电机端2.0 x 2
FLANGE^KFL08 x 2
BEARING^KFL08 x 2
socket set screw cone point_am x 4
光轴400mm x 3
链接滑台
丝杆螺母 x 2
直线轴承2.0 x 4
夹具
小车
