NeekoNoNeko/Engineering_Competition/3D/SolidWorks/备份/连接装配体2.0.0.0.SLDASM

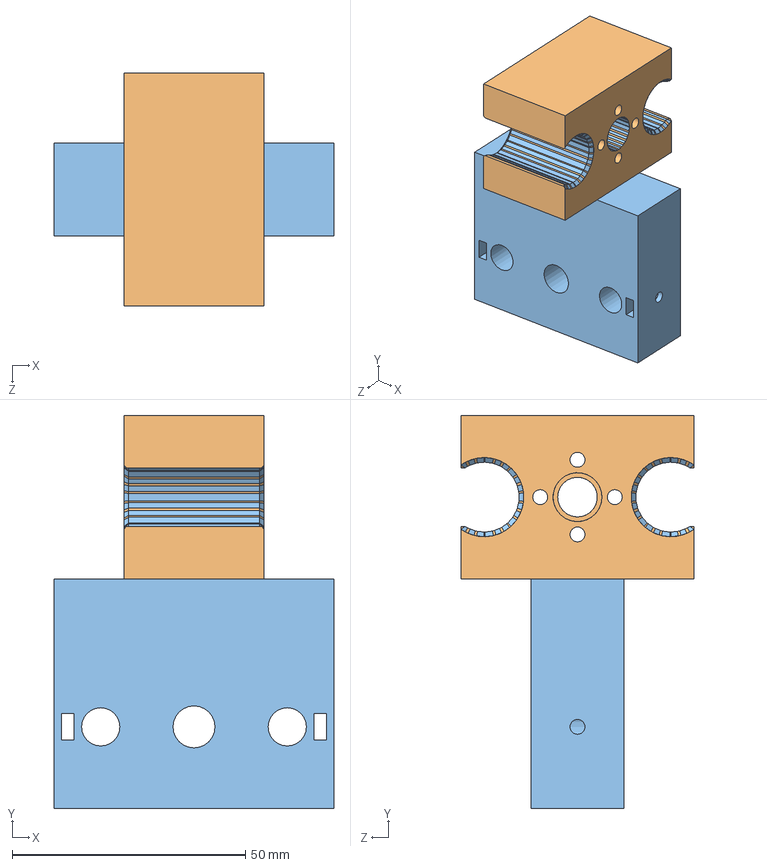
[picture p81: CAD file, 2024-10-24]
3D/SolidWorks/备份/连接装配体2.0.0.0.SLDASM
60.0 x 84.2 x 50.0 mm
