NeekoNoNeko/Engineering_Competition/3D/SolidWorks/备份/装配体2.SLDASM

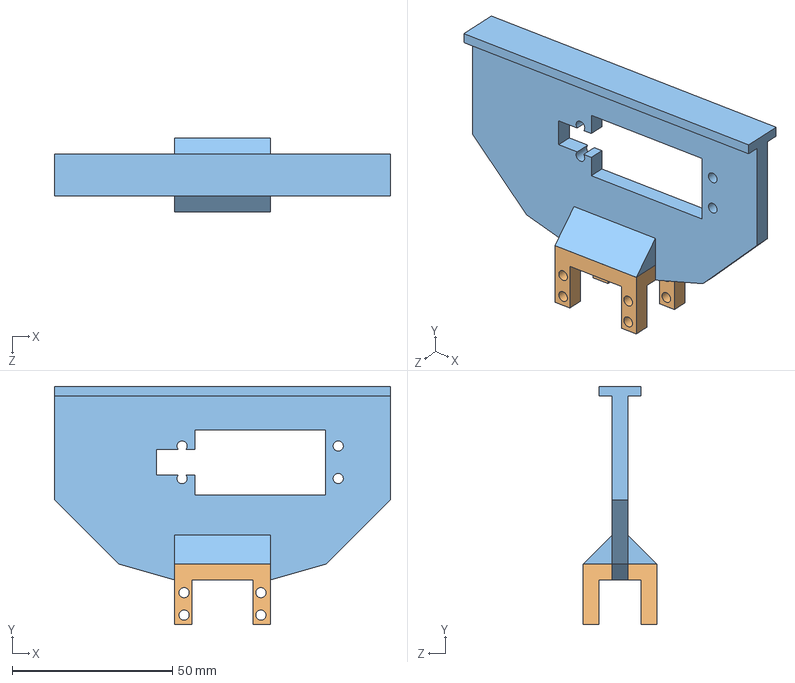
[picture p82: CAD file, 2024-10-24]
3D/SolidWorks/备份/装配体2.SLDASM
105.0 x 74.5 x 23.0 mm
