NeekoNoNeko/Engineering_Competition/3D/SolidWorks/备份/操作盘装配体.SLDASM

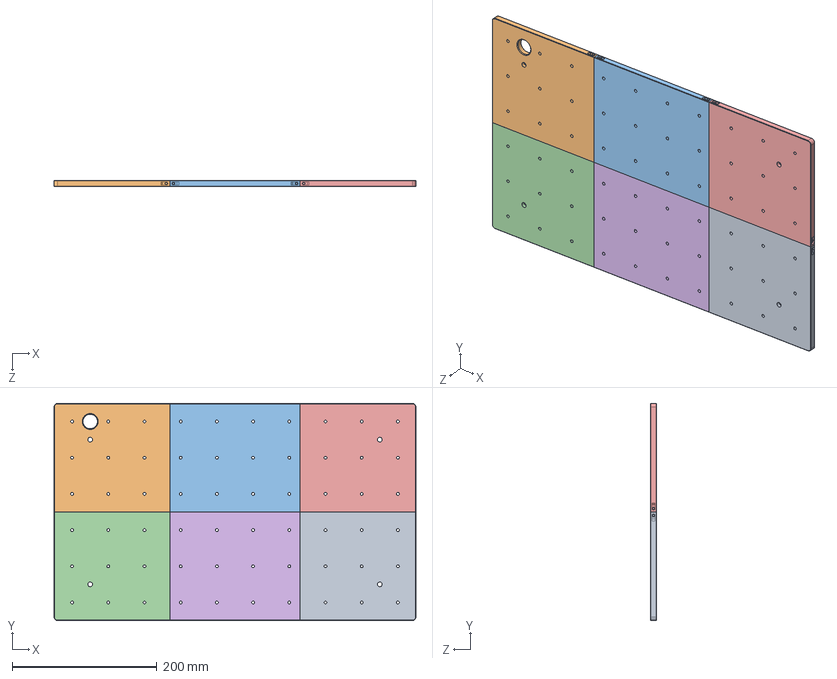
[picture p83: CAD file, 2024-10-24]
3D/SolidWorks/备份/操作盘装配体.SLDASM
500.0 x 300.0 x 8.00 mm
