NeekoNoNeko/Engineering_Competition/3D/SolidWorks/备份/X轴挡板装配体.SLDASM

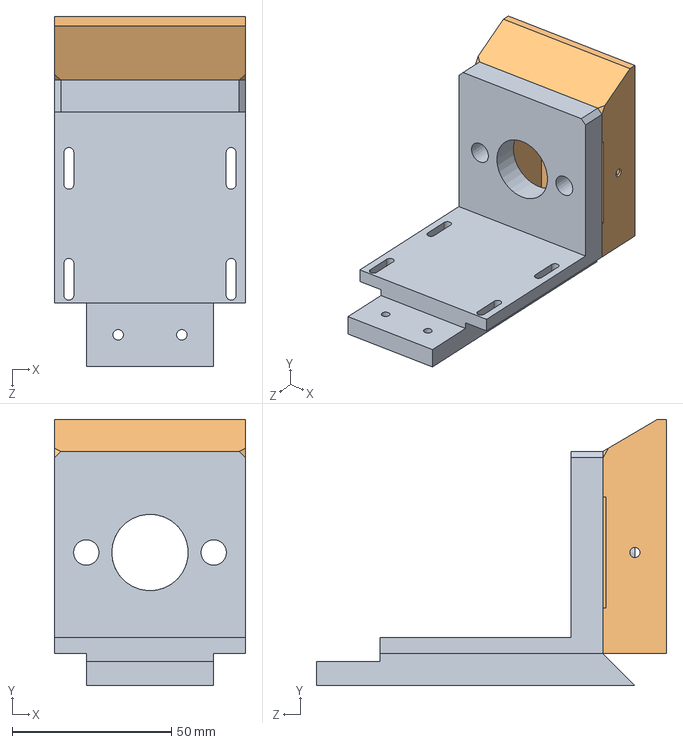
[picture p84: CAD file, 2024-10-24]
3D/SolidWorks/备份/X轴挡板装配体.SLDASM
60.0 x 83.5 x 110.0 mm
近电机端3.0
X轴挡板
