NeekoNoNeko/Engineering_Competition/3D/SolidWorks/备份/Y轴挡板.SLDASM

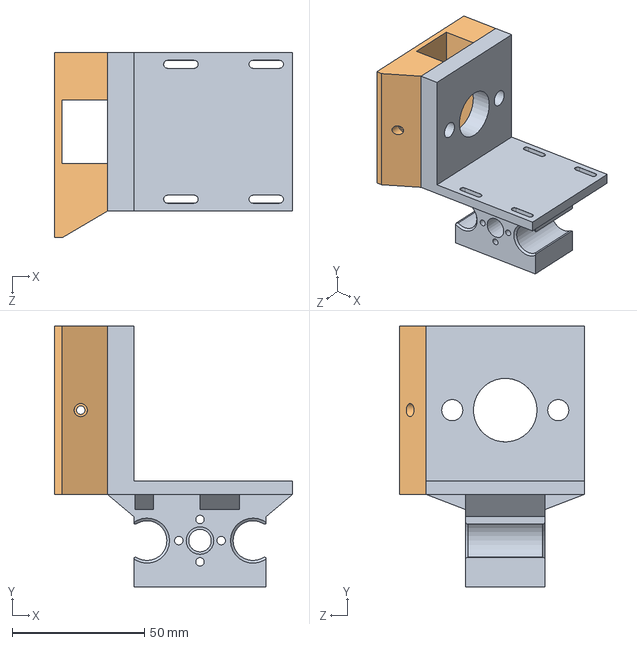
[picture p85: CAD file, 2024-10-24]
3D/SolidWorks/备份/Y轴挡板.SLDASM
90.0 x 98.5 x 70.0 mm
支架滑台2.0
Y轴挡板1.0
