NeekoNoNeko/Engineering_Competition/3D/42步进电机连接部件/20系列T型螺母M4.SLDPRT

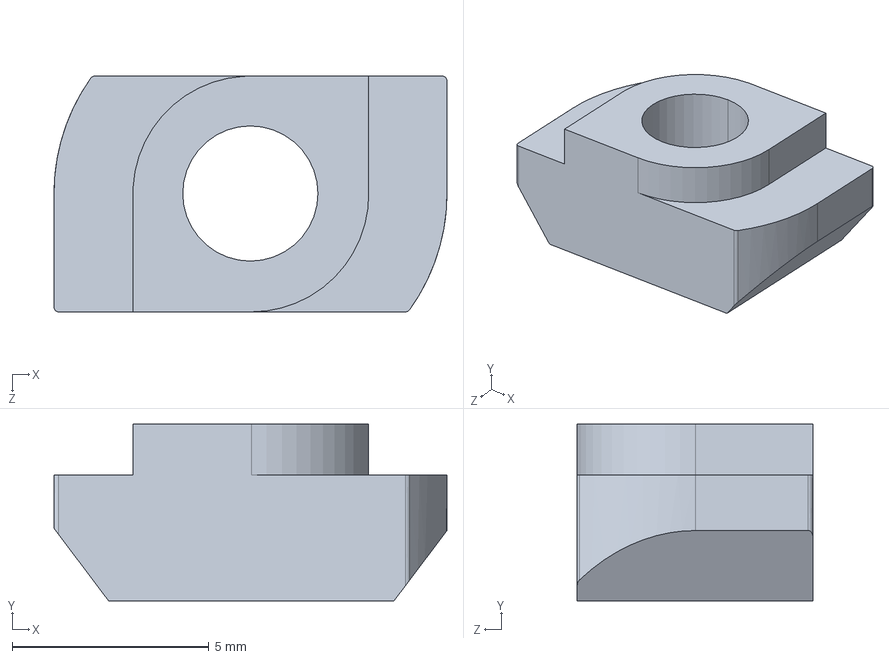
[picture p86: CAD file, 2024-10-24]
3D/42步进电机连接部件/20系列T型螺母M4.SLDPRT
10.0 x 4.50 x 6.00 mm
