NeekoNoNeko/Engineering_Competition/3D/SolidWorks/备份/fpobaod9/output/Servo Motor MG996R _米字摇臂.sldprt

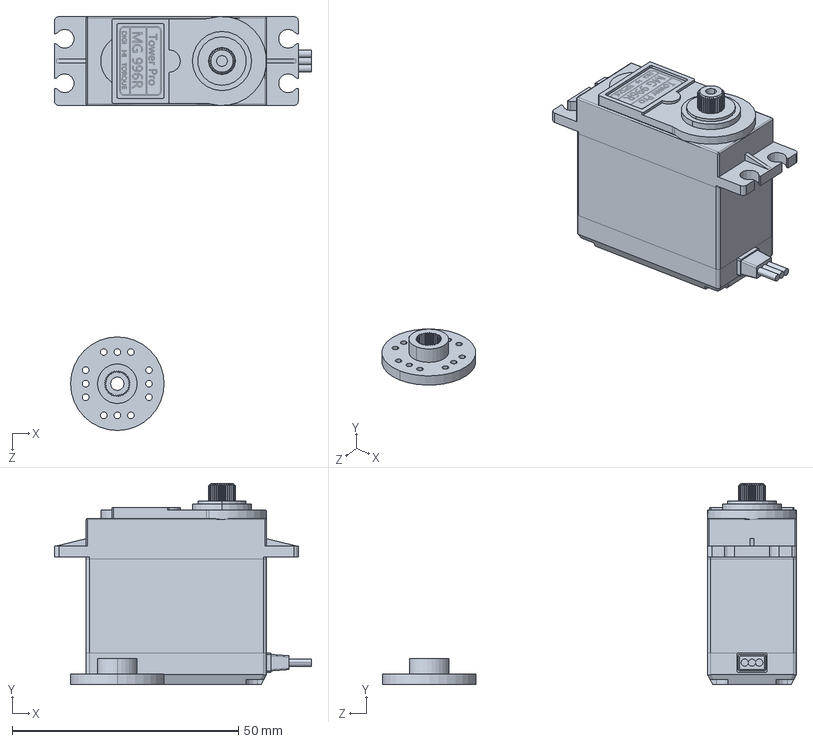
[picture p87: CAD file, 2024-10-24]
3D/SolidWorks/备份/fpobaod9/output/Servo Motor MG996R _米字摇臂.sldprt
57.0 x 44.5 x 91.6 mm
