NeekoNoNeko/Engineering_Competition/3D/SolidWorks/备份/KFL08/KFL08_Seperate/KFL08_608-RS.sldprt

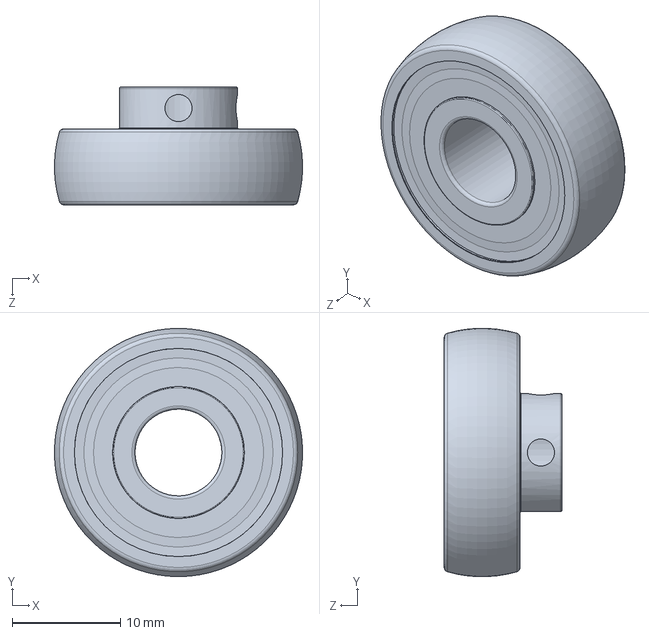
[picture p88: CAD file, 2024-10-24]
3D/SolidWorks/备份/KFL08/KFL08_Seperate/KFL08_608-RS.sldprt
22.9 x 22.9 x 10.9 mm
