NeekoNoNeko/Engineering_Competition/3D/SolidWorks/备份/伺服电机MG996R舵机/temp/Servo Motor MG996R_ 一字摇臂.step

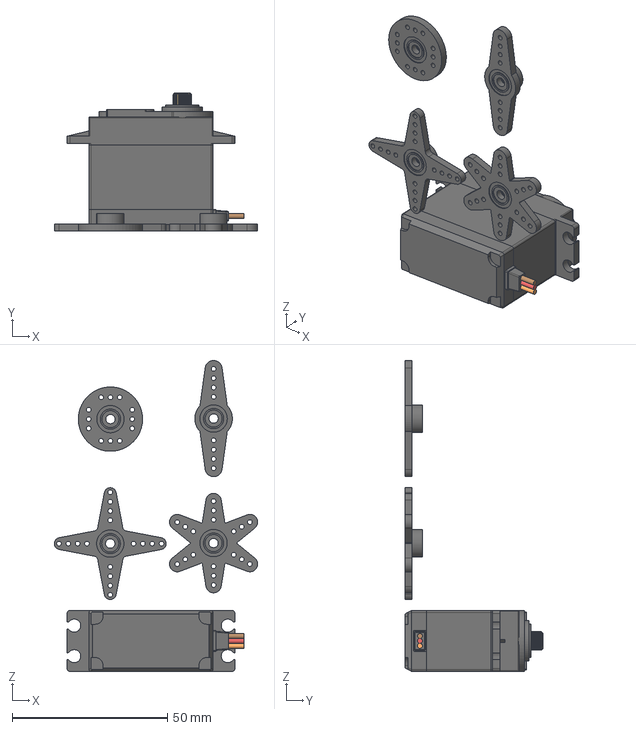
[picture p89: CAD file, 2024-10-24]
3D/SolidWorks/备份/伺服电机MG996R舵机/temp/Servo Motor MG996R_ 一字摇臂.step
65.4 x 44.5 x 100.1 mm
