NeekoNoNeko/Engineering_Competition/3D/SolidWorks/备份/梯形丝杠╱梯形丝杆螺母[TN8X10X2NR╱200×200Cu]/梯形丝杠╱梯形丝杆螺母[TN8X10X2NR╱200×200Cu]_丝杠.SLDPRT

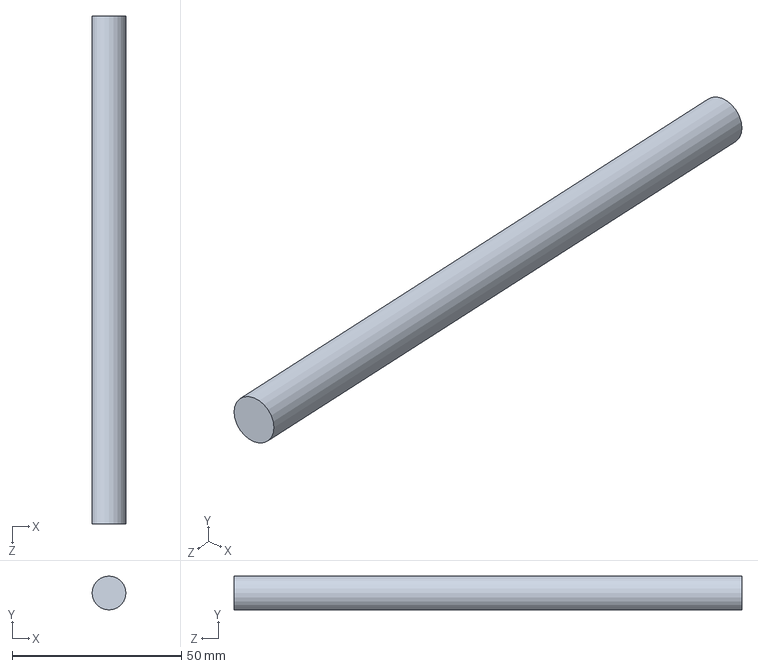
[picture p90: CAD file, 2024-10-24]
3D/SolidWorks/备份/梯形丝杠╱梯形丝杆螺母[TN8X10X2NR╱200×200Cu]/梯形丝杠╱梯形丝杆螺母[TN8X10X2NR╱200×200Cu]_丝杠.SLDPRT
10.0 x 10.0 x 150.0 mm
