NeekoNoNeko/Engineering_Competition/3D/SolidWorks/备份/爪子/舵机.SLDPRT

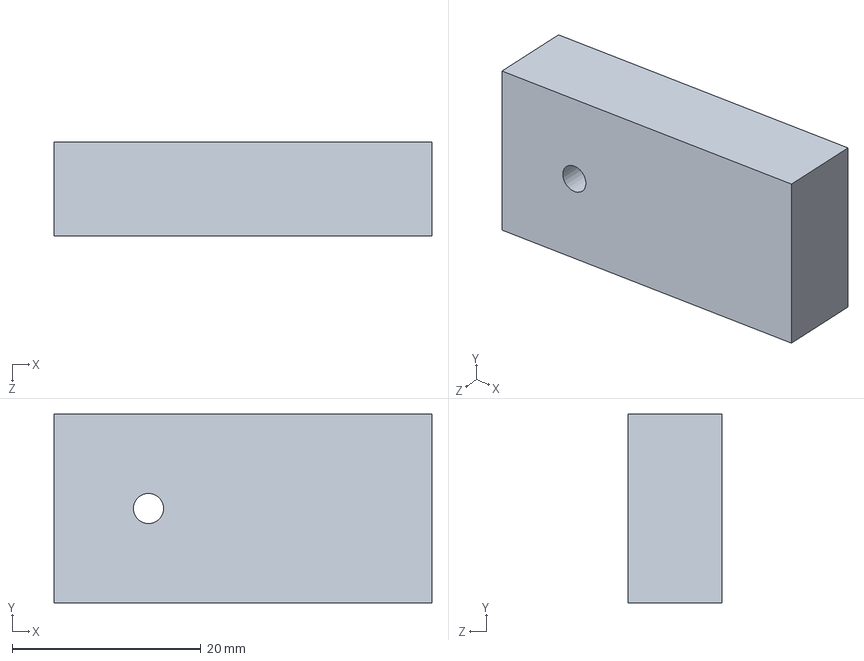
[picture p91: CAD file, 2024-10-24]
3D/SolidWorks/备份/爪子/舵机.SLDPRT
40.0 x 20.0 x 10.0 mm
