NeekoNoNeko/Engineering_Competition/3D/SolidWorks/备份/矢量概念机械臂爪标准伺服/temp/servo-gear.STL

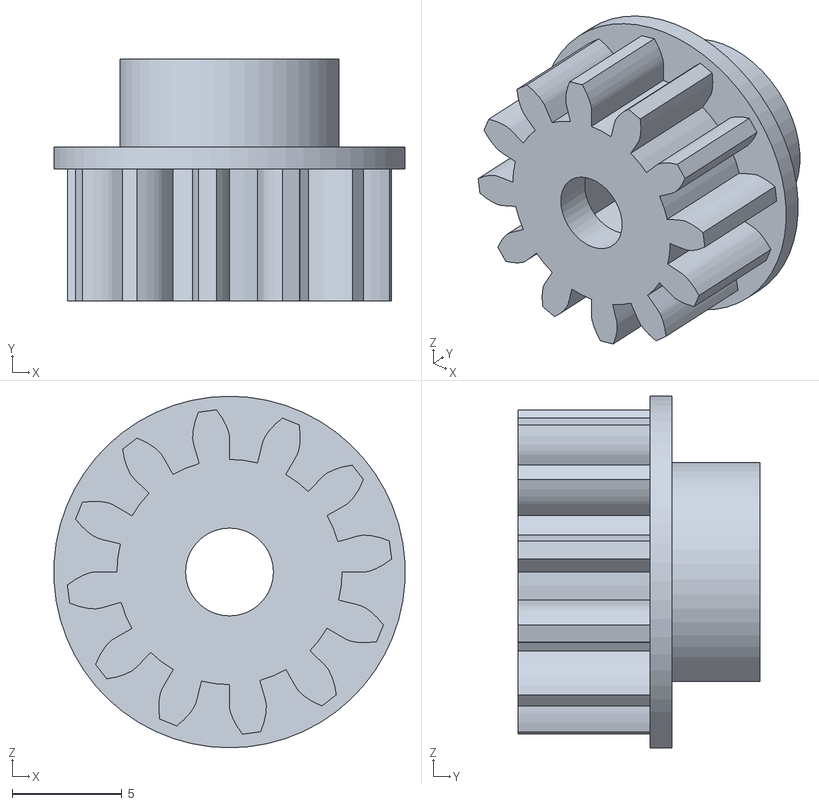
[picture p92: CAD file, 2024-10-24]
3D/SolidWorks/备份/矢量概念机械臂爪标准伺服/temp/servo-gear.STL
16.0 x 11.0 x 16.0
