NeekoNoNeko/Engineering_Competition/3D/SolidWorks/备份/钢制KK模组直线滑台TKK100[TKK100-1080]/钢制KK模组直线滑台TKK100[TKK100-1080]_2.SLDPRT

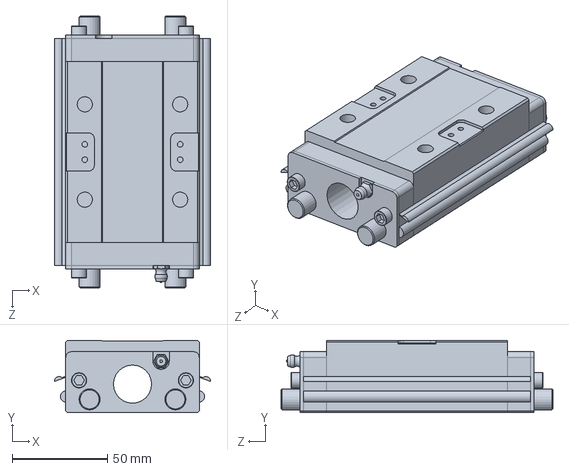
[picture p93: CAD file, 2024-10-24]
3D/SolidWorks/备份/钢制KK模组直线滑台TKK100[TKK100-1080]/钢制KK模组直线滑台TKK100[TKK100-1080]_2.SLDPRT
82.0 x 38.0 x 142.6 mm
