NeekoNoNeko/Engineering_Competition/3D/总装测试/STL/T型滑台连型材Y.STL

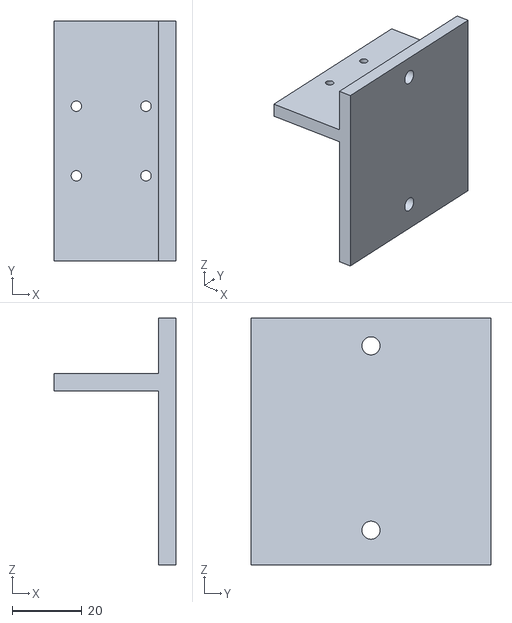
[picture p94: CAD file, 2024-10-24]
3D/总装测试/STL/T型滑台连型材Y.STL
35.0 x 69.0 x 71.0
