NeekoNoNeko/Engineering_Competition/3D/总装测试/X轴/A2604BCC9914416AB2DF775E60B1E2CC.SLDPRT(1).SLDPRT

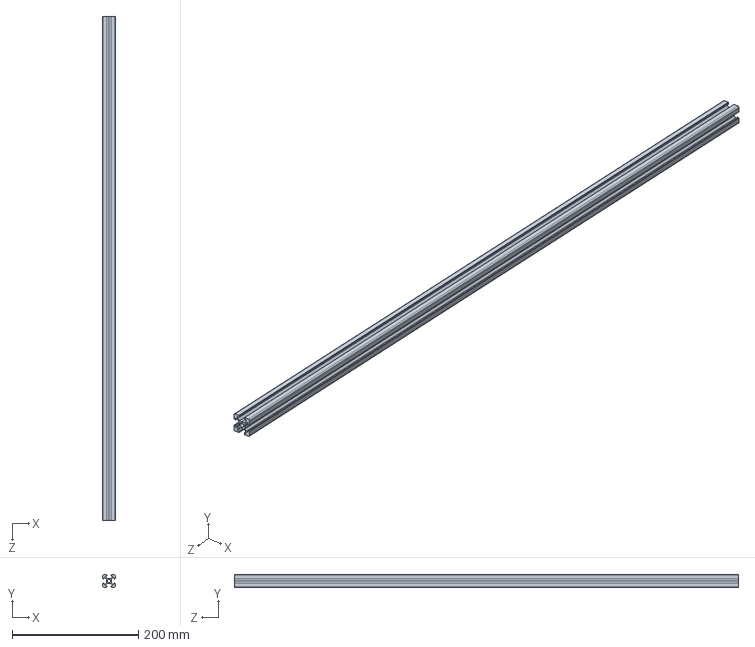
[picture p95: CAD file, 2024-10-24]
3D/总装测试/X轴/A2604BCC9914416AB2DF775E60B1E2CC.SLDPRT(1).SLDPRT
20.0 x 20.0 x 800.0 mm
