NeekoNoNeko/Engineering_Competition/3D/总装测试/Y轴/42电机支架(塑料).SLDPRT

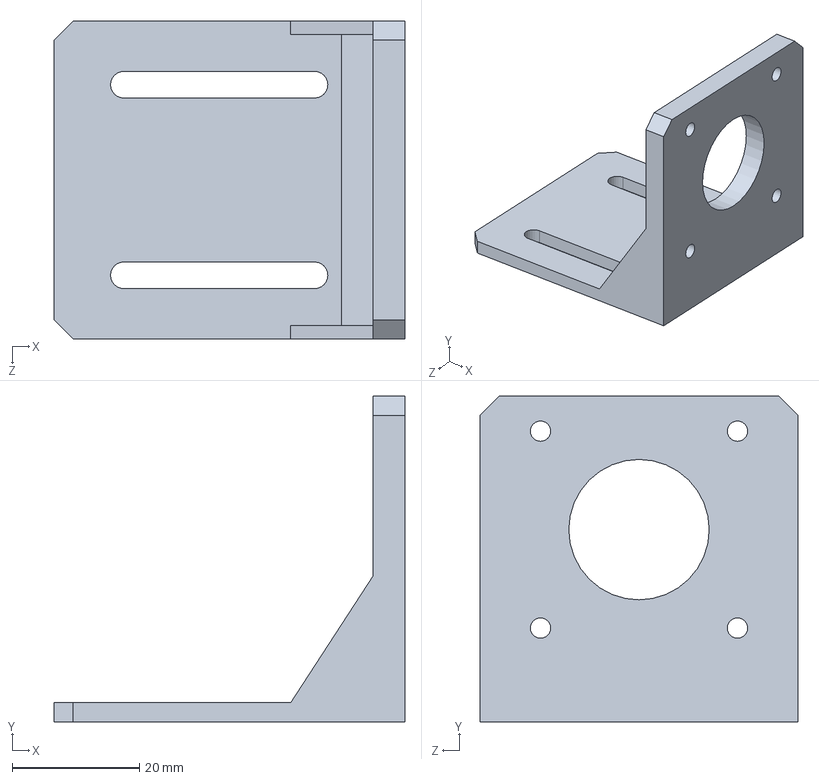
[picture p96: CAD file, 2024-10-24]
3D/总装测试/Y轴/42电机支架(塑料).SLDPRT
55.2 x 51.2 x 50.0 mm
