NeekoNoNeko/Engineering_Competition/3D/总装测试/Z轴/线轨-L245.SLDPRT

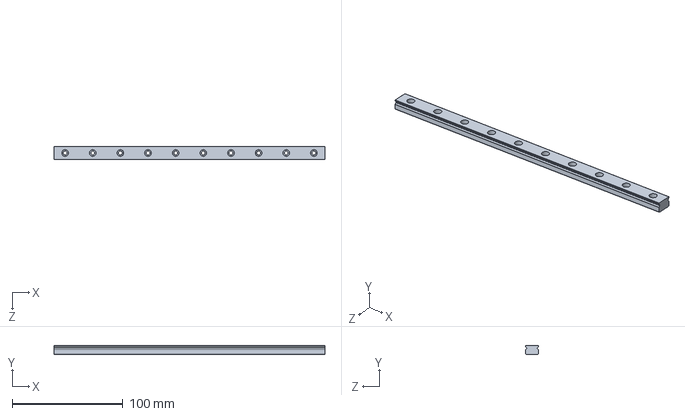
[picture p97: CAD file, 2024-10-24]
3D/总装测试/Z轴/线轨-L245.SLDPRT
245.0 x 8.00 x 12.0 mm
