NeekoNoNeko/Engineering_Competition/3D/总装测试/拧瓶盖/电机座.SLDPRT

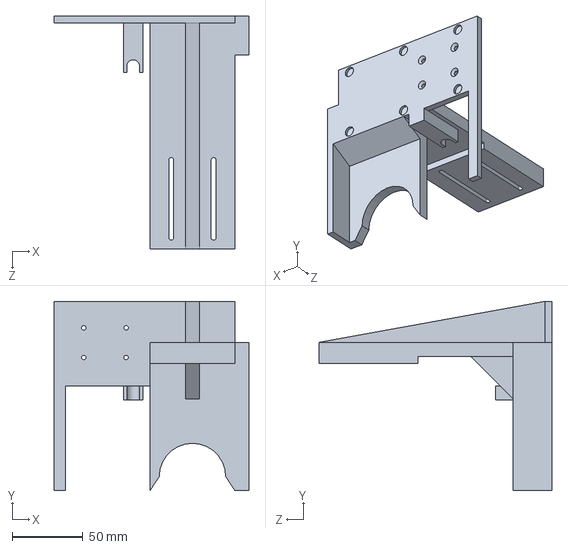
[picture p98: CAD file, 2024-10-24]
3D/总装测试/拧瓶盖/电机座.SLDPRT
138.0 x 134.0 x 165.0 mm
