NeekoNoNeko/Engineering_Competition/3D/总装测试/紧固件/M3/十字槽沉头螺钉M3-L10.SLDPRT

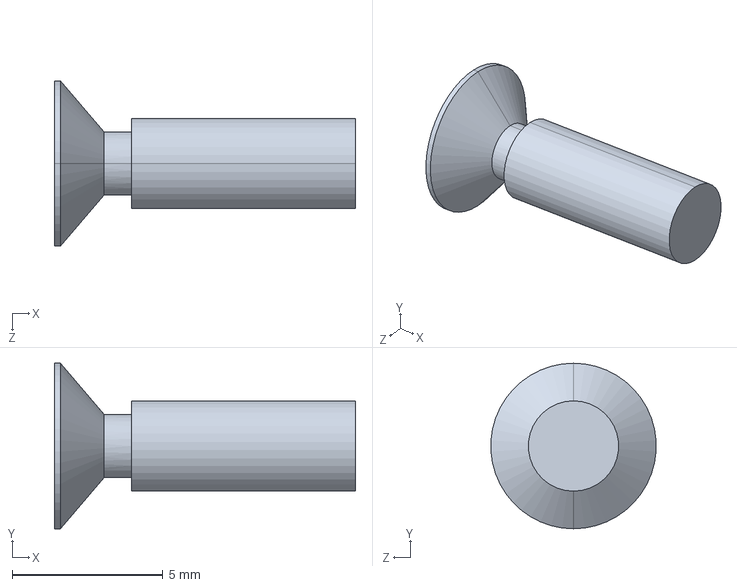
[picture p99: CAD file, 2024-10-24]
3D/总装测试/紧固件/M3/十字槽沉头螺钉M3-L10.SLDPRT
10.0 x 5.50 x 5.49 mm
