NeekoNoNeko/Engineering_Competition/3D/总装测试/紧固件/压铸角码/平垫圈A级M4.SLDPRT

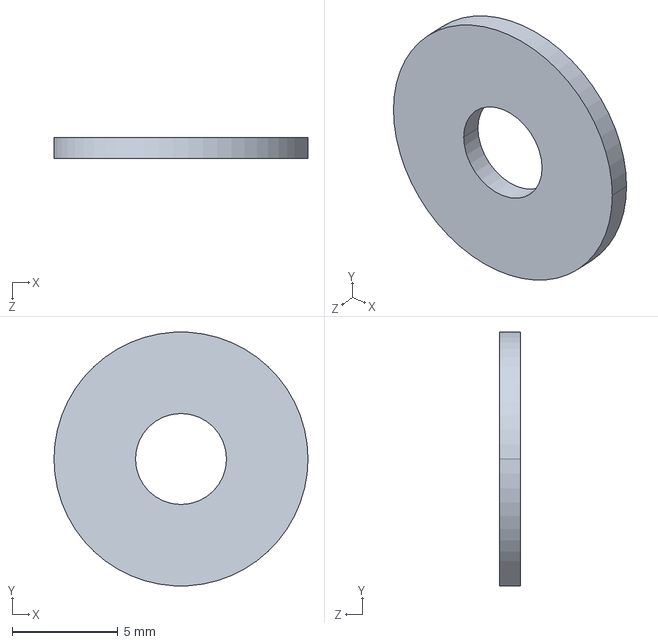
[picture p100: CAD file, 2024-10-24]
3D/总装测试/紧固件/压铸角码/平垫圈A级M4.SLDPRT
12.0 x 12.0 x 1.00 mm
