NeekoNoNeko/Engineering_Competition/3D/标准型滑台.SLDPRT

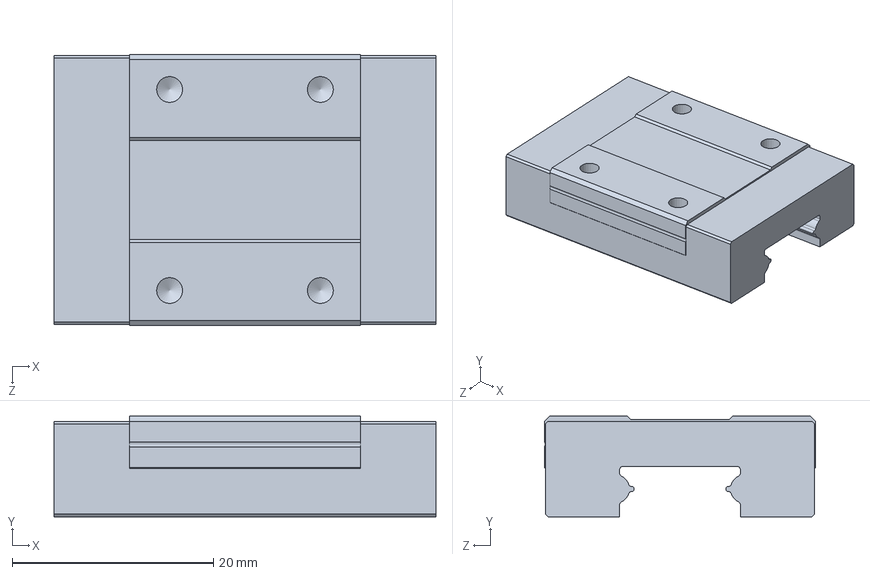
[picture p101: CAD file, 2024-10-24]
3D/标准型滑台.SLDPRT
38.0 x 10.0 x 27.0 mm
