NeekoNoNeko/Engineering_Competition/3D/42步进电机连接部件/150mm2020.SLDPRT

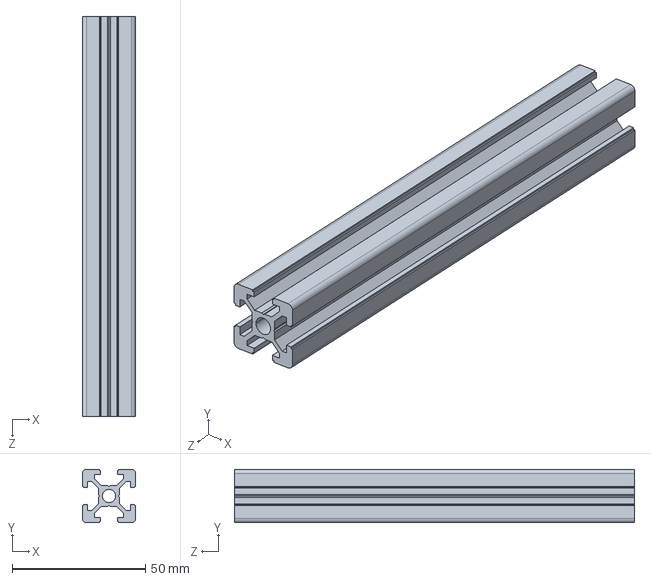
[picture p102: CAD file, 2024-10-24]
3D/42步进电机连接部件/150mm2020.SLDPRT
20.0 x 20.0 x 150.0 mm
