NeekoNoNeko/Engineering_Competition/3D/600mm滑台.SLDPRT

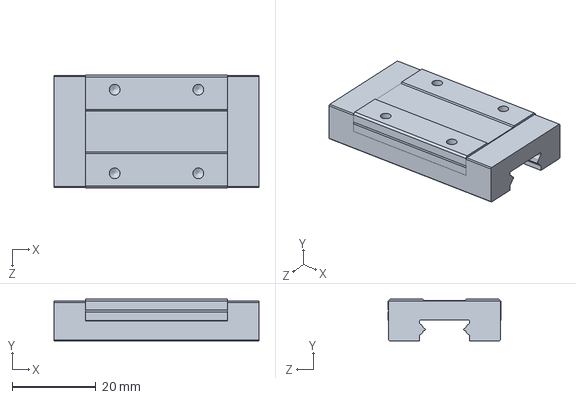
[picture p103: CAD file, 2024-10-24]
3D/600mm滑台.SLDPRT
49.0 x 10.0 x 27.0 mm
