NeekoNoNeko/Engineering_Competition/3D/SolidWorks/备份/爪子/圆柱.SLDPRT

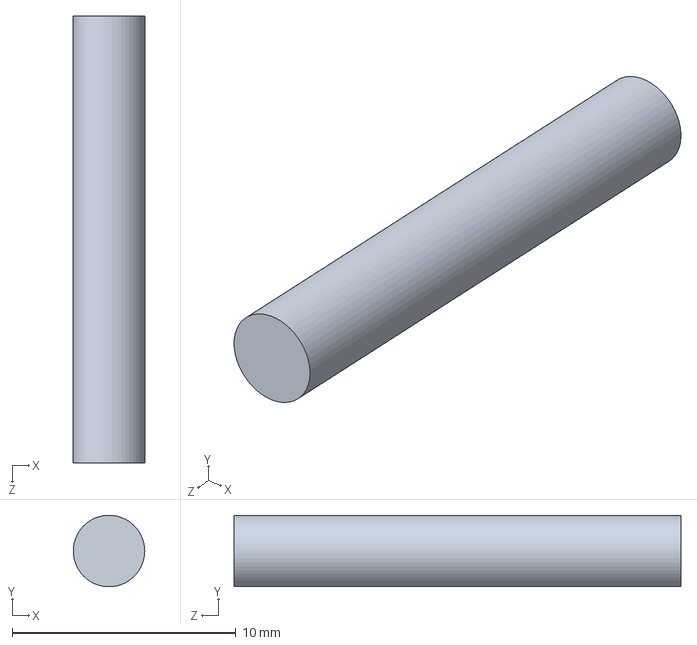
[picture p104: CAD file, 2024-10-24]
3D/SolidWorks/备份/爪子/圆柱.SLDPRT
3.20 x 3.20 x 20.0 mm
