NeekoNoNeko/Engineering_Competition/3D/SolidWorks/备份/矢量概念机械臂爪标准伺服/temp/gear-link-2.STL

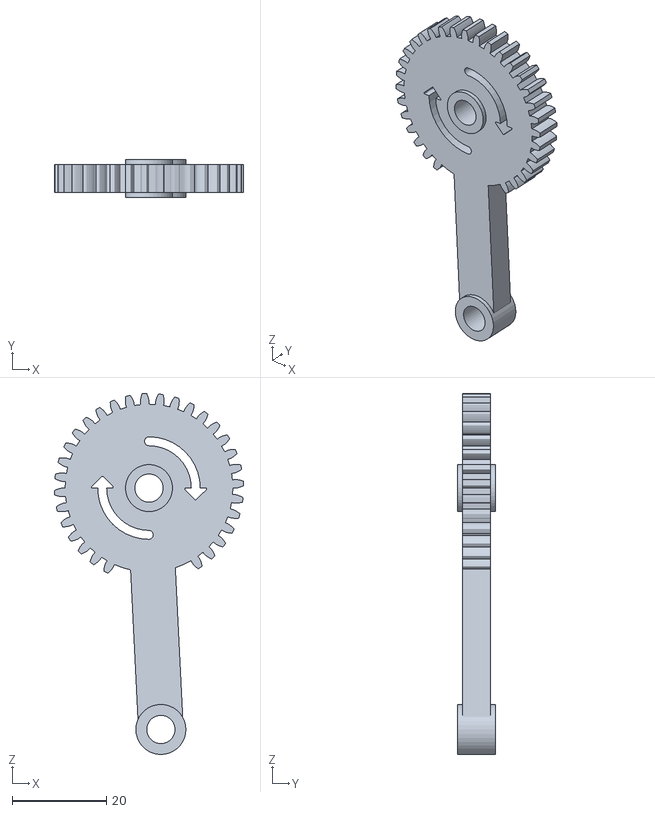
[picture p105: CAD file, 2024-10-24]
3D/SolidWorks/备份/矢量概念机械臂爪标准伺服/temp/gear-link-2.STL
40.2 x 8.00 x 76.7
