NeekoNoNeko/Engineering_Competition/3D/SolidWorks/链接滑台.SLDPRT

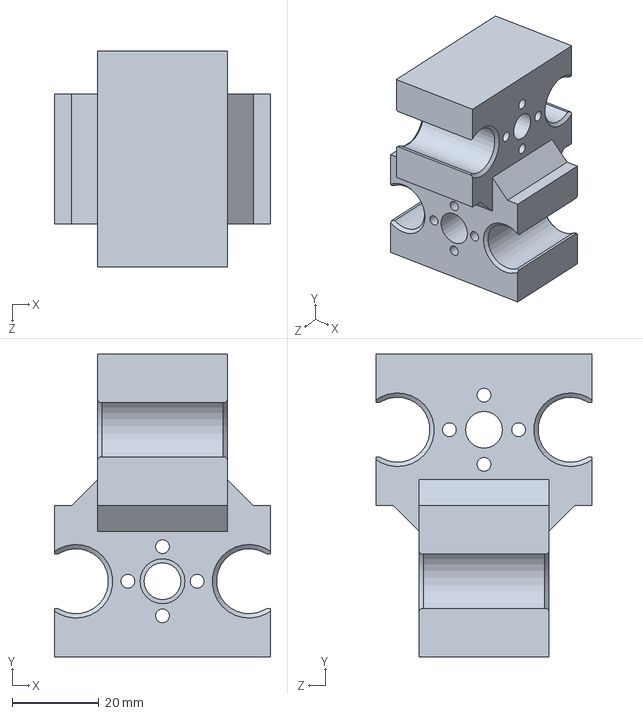
[picture p106: CAD file, 2024-10-24]
3D/SolidWorks/链接滑台.SLDPRT
50.0 x 70.0 x 50.0 mm
