NeekoNoNeko/Engineering_Competition/3D/总装测试/STL/药板2.SLDPRT

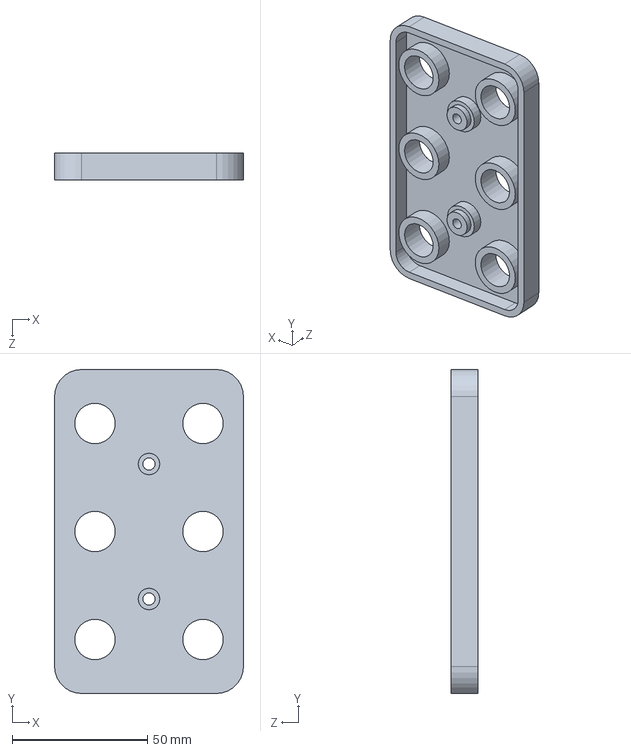
[picture p107: CAD file, 2024-10-24]
3D/总装测试/STL/药板2.SLDPRT
70.0 x 120.0 x 10.0 mm
