NeekoNoNeko/Engineering_Competition/3D/总装测试/X轴/56D543CC4C8C3B7D306B6E81EAA63EB0.SLDPRT(1).SLDPRT

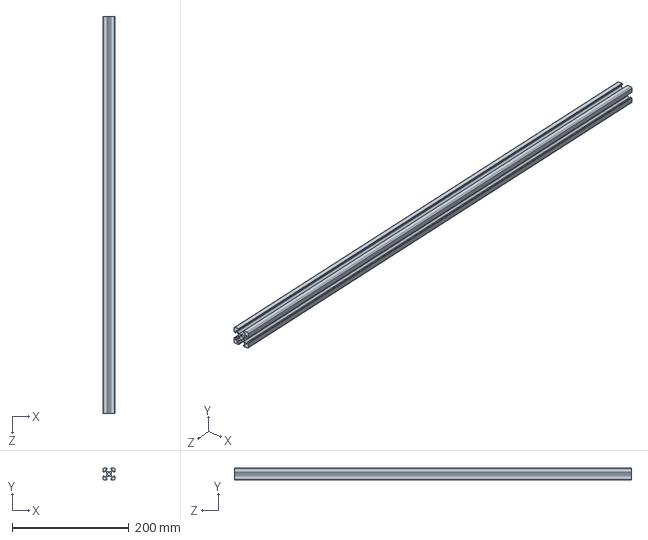
[picture p108: CAD file, 2024-10-24]
3D/总装测试/X轴/56D543CC4C8C3B7D306B6E81EAA63EB0.SLDPRT(1).SLDPRT
20.0 x 20.0 x 680.0 mm
