NeekoNoNeko/Engineering_Competition/3D/总装测试/X轴/测试/857E8B7BF053B63E952D7E42D748C869.SLDPRT(1).SLDPRT

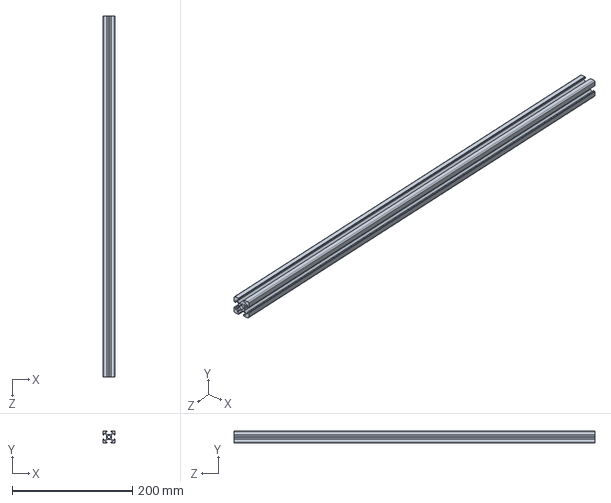
[picture p109: CAD file, 2024-10-24]
3D/总装测试/X轴/测试/857E8B7BF053B63E952D7E42D748C869.SLDPRT(1).SLDPRT
20.0 x 20.0 x 600.0 mm
