NeekoNoNeko/Engineering_Competition/3D/总装测试/Y轴/1930FA8D96BECBA3D9C62A6CC0265C7E.SLDPRT(1).SLDPRT

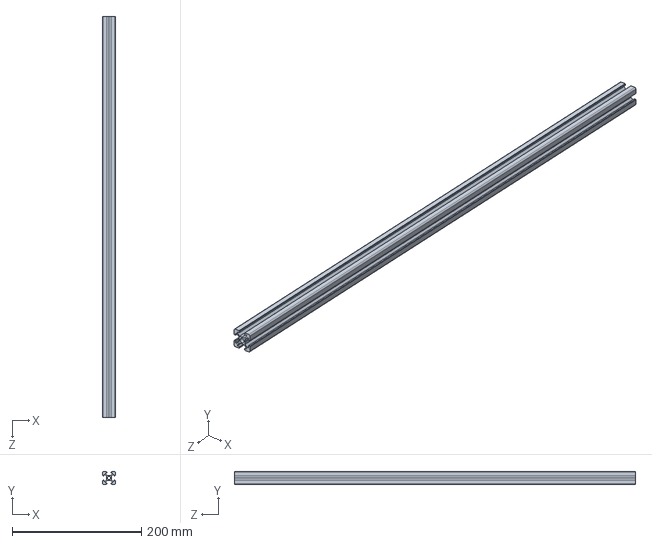
[picture p110: CAD file, 2024-10-24]
3D/总装测试/Y轴/1930FA8D96BECBA3D9C62A6CC0265C7E.SLDPRT(1).SLDPRT
20.0 x 20.0 x 620.0 mm
