NeekoNoNeko/Engineering_Competition/3D/总装测试/Z轴/线轨L345.SLDPRT

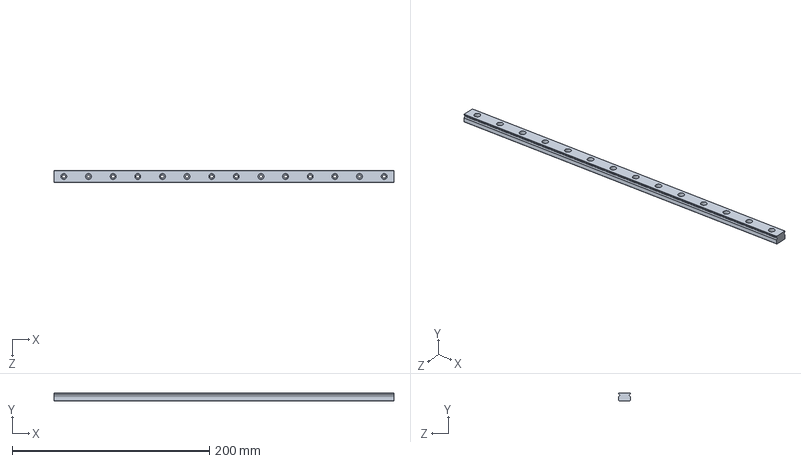
[picture p111: CAD file, 2024-10-24]
3D/总装测试/Z轴/线轨L345.SLDPRT
345.0 x 8.00 x 12.0 mm
