NeekoNoNeko/Engineering_Competition/3D/总装测试/共用配件/600mm丝杆and光轴.SLDPRT

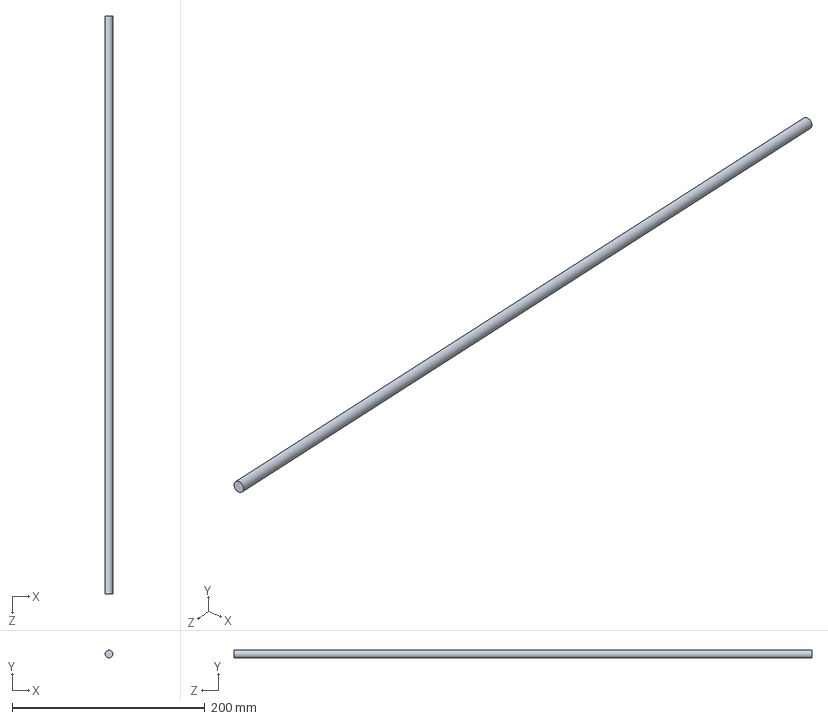
[picture p112: CAD file, 2024-10-24]
3D/总装测试/共用配件/600mm丝杆and光轴.SLDPRT
8.00 x 8.00 x 600.0 mm
