NeekoNoNeko/Engineering_Competition/3D/总装测试/外框/线轨L361.SLDPRT

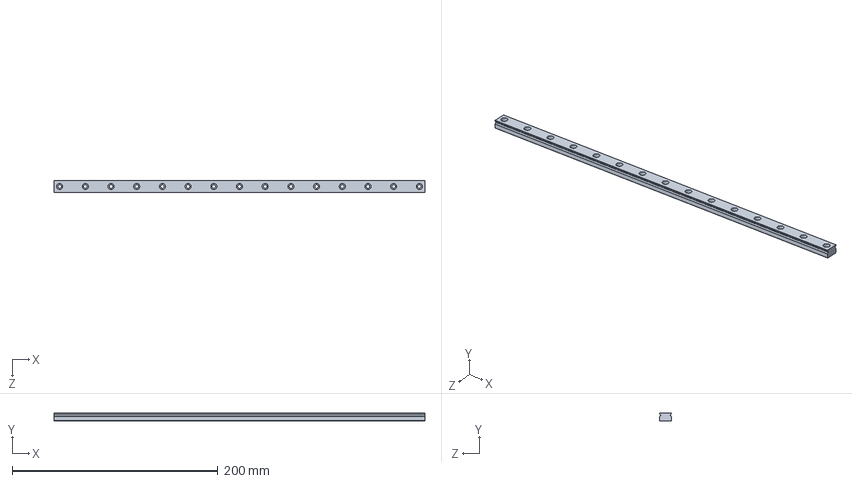
[picture p113: CAD file, 2024-10-24]
3D/总装测试/外框/线轨L361.SLDPRT
361.0 x 8.00 x 12.0 mm
