NeekoNoNeko/Engineering_Competition/3D/总装测试/紧固件/M5套装/平垫圈A级M5.SLDPRT

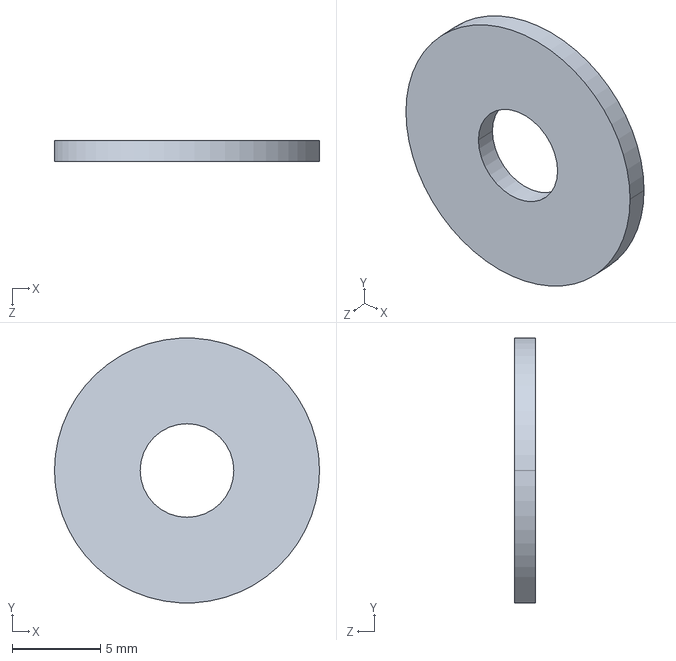
[picture p114: CAD file, 2024-10-24]
3D/总装测试/紧固件/M5套装/平垫圈A级M5.SLDPRT
15.0 x 15.0 x 1.20 mm
