NeekoNoNeko/Engineering_Competition/3D/总装测试/紧固件/压铸角码/压铸角码.SLDPRT

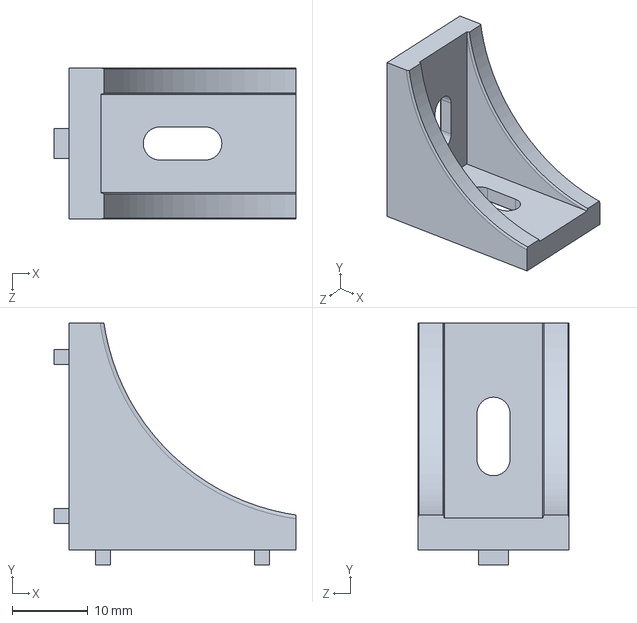
[picture p115: CAD file, 2024-10-24]
3D/总装测试/紧固件/压铸角码/压铸角码.SLDPRT
32.0 x 32.0 x 20.0 mm
