NeekoNoNeko/Engineering_Competition/3D/滑台连型材/内六角紧定螺钉-M5-L6.SLDPRT

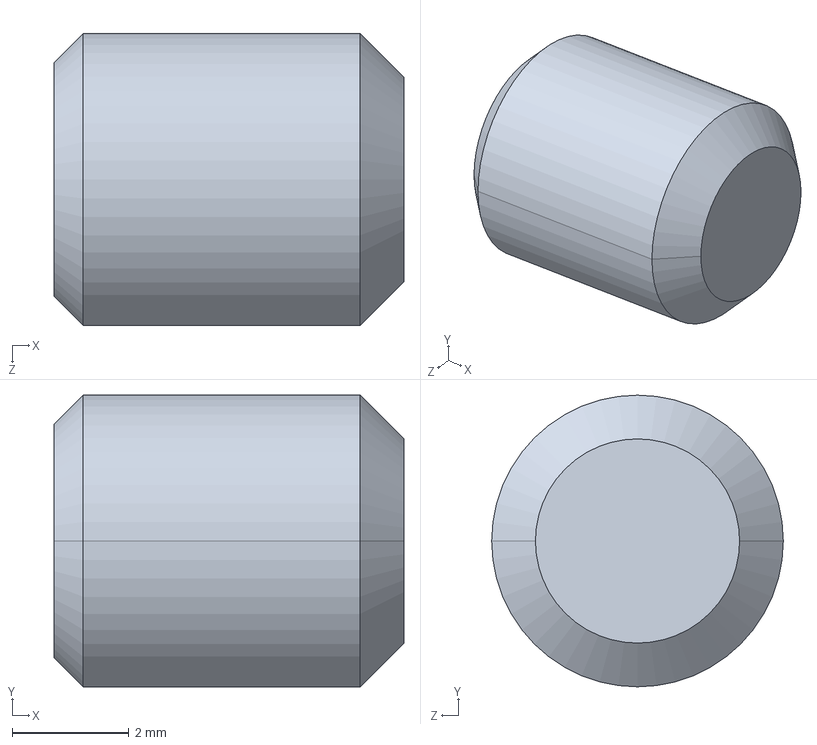
[picture p116: CAD file, 2024-10-24]
3D/滑台连型材/内六角紧定螺钉-M5-L6.SLDPRT
6.00 x 5.00 x 5.00 mm
