NeekoNoNeko/Engineering_Competition/3D/42步进电机连接部件/内六角圆柱头螺钉M4L14.SLDPRT

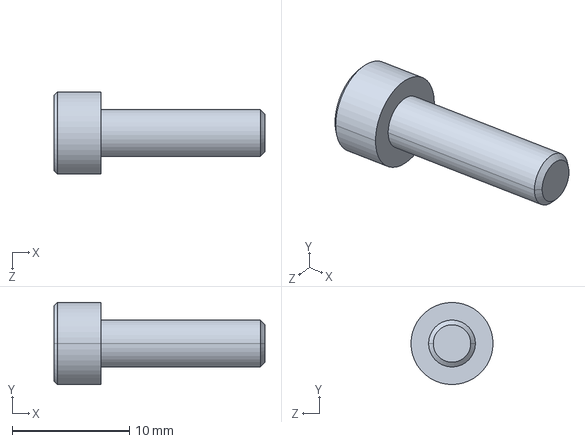
[picture p117: CAD file, 2024-10-24]
3D/42步进电机连接部件/内六角圆柱头螺钉M4L14.SLDPRT
18.0 x 7.00 x 7.00 mm
