NeekoNoNeko/Engineering_Competition/3D/SolidWorks/备份/KFL08/KFL08_Seperate/KFL08_Flange.sldprt

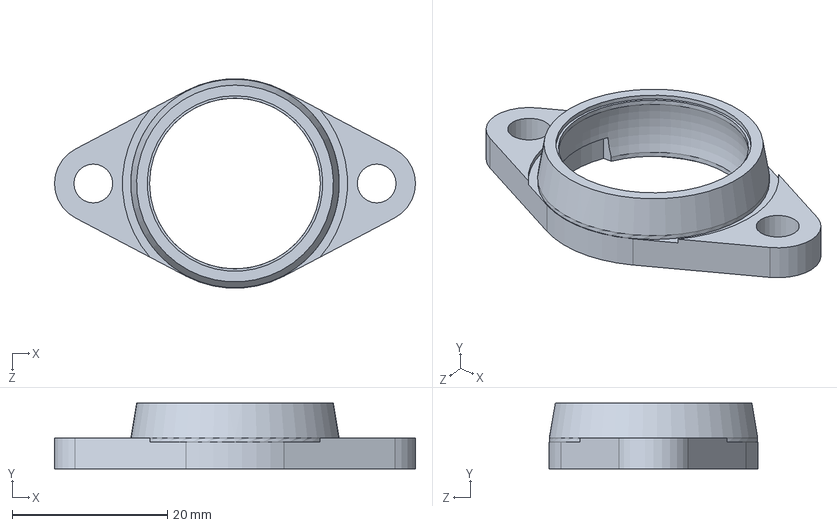
[picture p118: CAD file, 2024-10-24]
3D/SolidWorks/备份/KFL08/KFL08_Seperate/KFL08_Flange.sldprt
46.5 x 8.50 x 26.9 mm
