NeekoNoNeko/Engineering_Competition/3D/SolidWorks/备份/爪子/旋转.SLDPRT

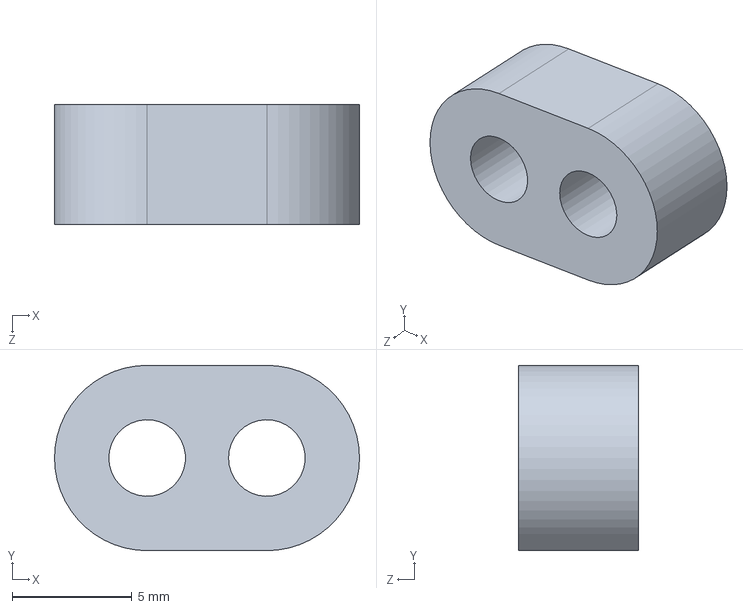
[picture p119: CAD file, 2024-10-24]
3D/SolidWorks/备份/爪子/旋转.SLDPRT
12.7 x 7.74 x 5.00 mm
