NeekoNoNeko/Engineering_Competition/3D/SolidWorks/备份/电机支架.SLDPRT

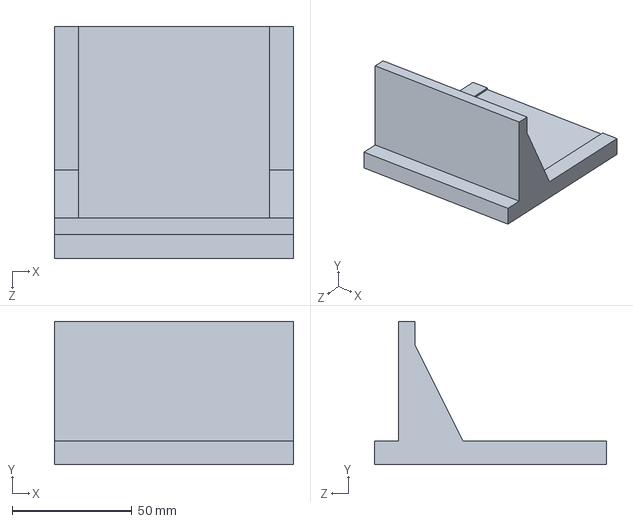
[picture p120: CAD file, 2024-10-24]
3D/SolidWorks/备份/电机支架.SLDPRT
100.0 x 60.0 x 97.0 mm
