NeekoNoNeko/Engineering_Competition/3D/SolidWorks/备份/矢量概念机械臂爪标准伺服/temp/finger.STL

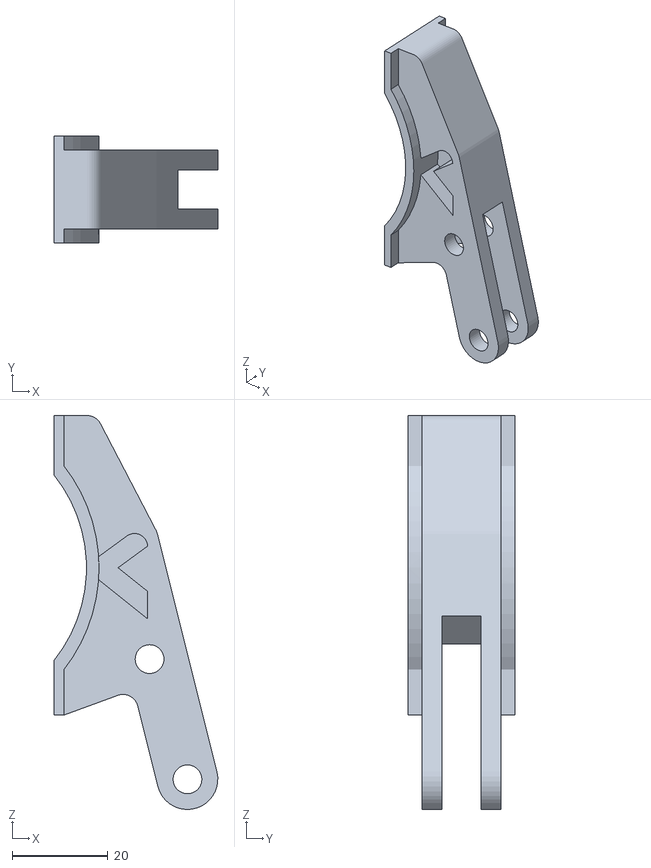
[picture p121: CAD file, 2024-10-24]
3D/SolidWorks/备份/矢量概念机械臂爪标准伺服/temp/finger.STL
34.1 x 22.4 x 82.2
