NeekoNoNeko/Engineering_Competition/3D/SolidWorks/备份/钢制KK模组直线滑台TKK100[TKK100-1080]/1.SLDPRT

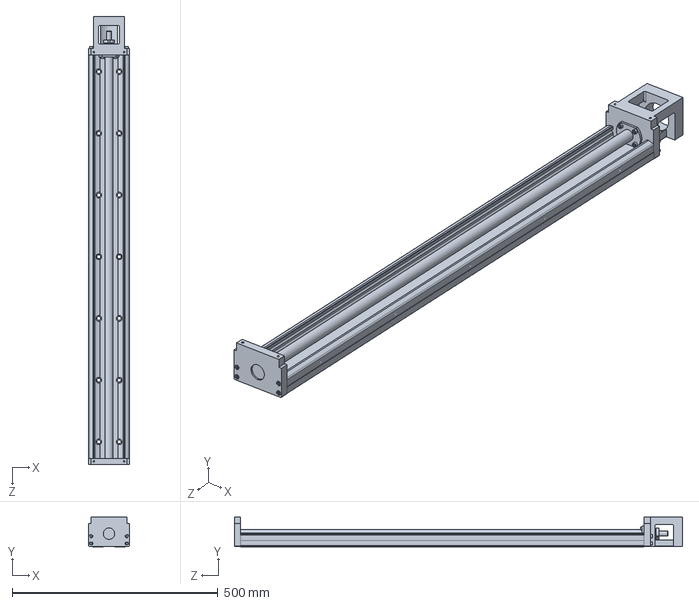
[picture p122: CAD file, 2024-10-24]
3D/SolidWorks/备份/钢制KK模组直线滑台TKK100[TKK100-1080]/1.SLDPRT
100.0 x 72.0 x 1089.0 mm
