NeekoNoNeko/Engineering_Competition/3D/总装测试/STL/侧面支撑.STL

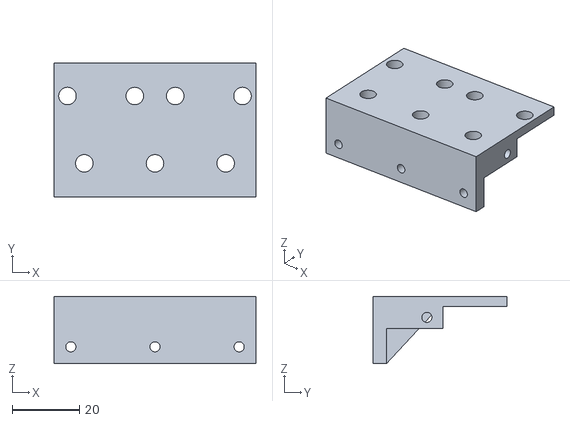
[picture p123: CAD file, 2024-10-24]
3D/总装测试/STL/侧面支撑.STL
60.0 x 39.8 x 20.0
