NeekoNoNeko/Engineering_Competition/3D/总装测试/X轴/单独配件/丝杆轴承固定件加长.SLDPRT

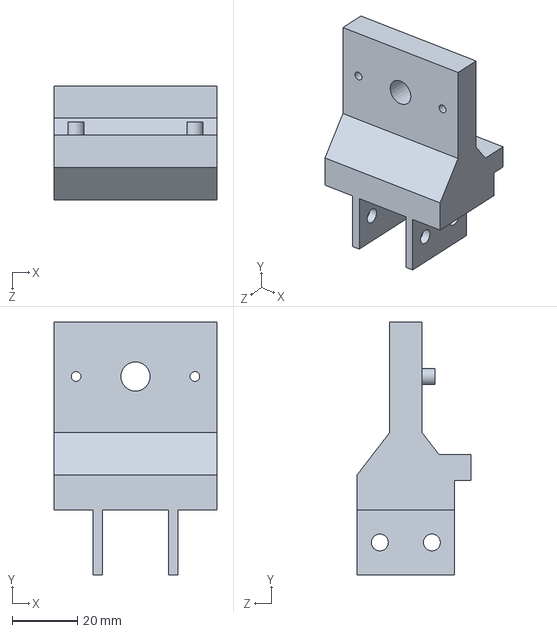
[picture p124: CAD file, 2024-10-24]
3D/总装测试/X轴/单独配件/丝杆轴承固定件加长.SLDPRT
50.0 x 77.8 x 35.0 mm
