NeekoNoNeko/Engineering_Competition/3D/总装测试/Y轴/Y轴滑台连丝杆.SLDPRT

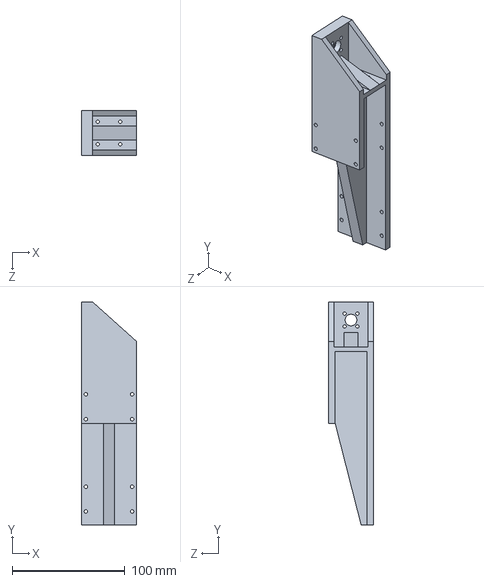
[picture p125: CAD file, 2024-10-24]
3D/总装测试/Y轴/Y轴滑台连丝杆.SLDPRT
49.0 x 198.0 x 40.0 mm
