NeekoNoNeko/Engineering_Competition/3D/总装测试/共用配件/法兰型导向轴支座.SLDPRT

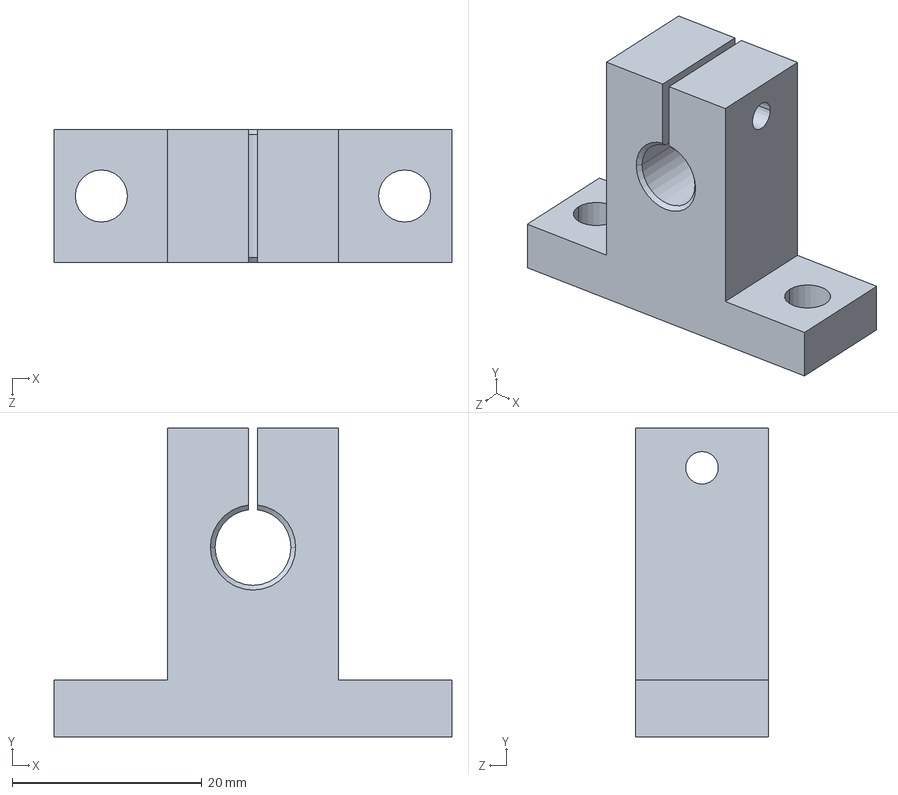
[picture p126: CAD file, 2024-10-24]
3D/总装测试/共用配件/法兰型导向轴支座.SLDPRT
42.0 x 32.6 x 14.0 mm
