NeekoNoNeko/Engineering_Competition/3D/总装测试/外框/2020-L521.SLDPRT

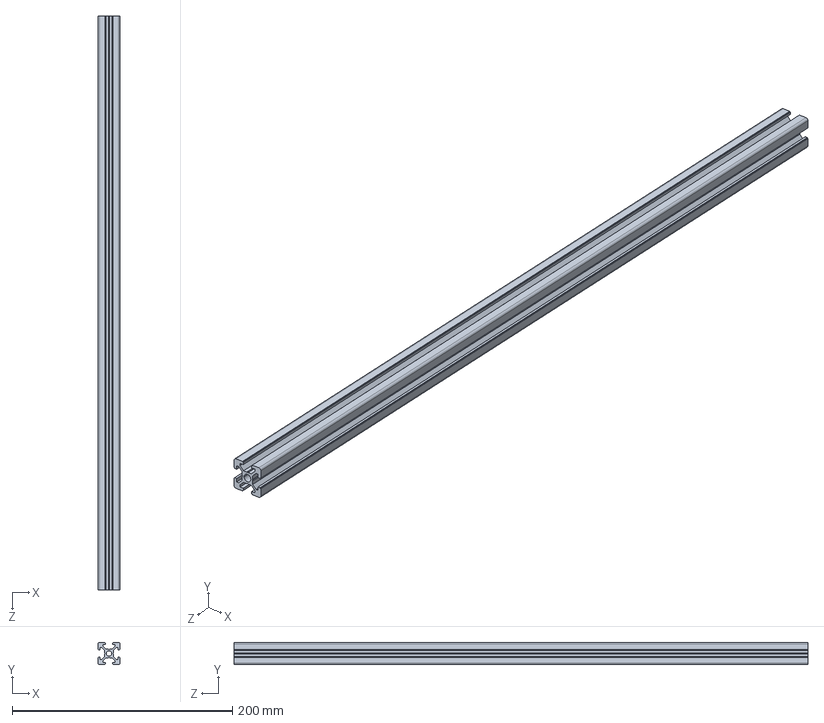
[picture p127: CAD file, 2024-10-24]
3D/总装测试/外框/2020-L521.SLDPRT
20.0 x 20.0 x 521.0 mm
