NeekoNoNeko/Engineering_Competition/3D/总装测试/紧固件/M3/内六角圆柱头螺钉M3-L6.SLDPRT

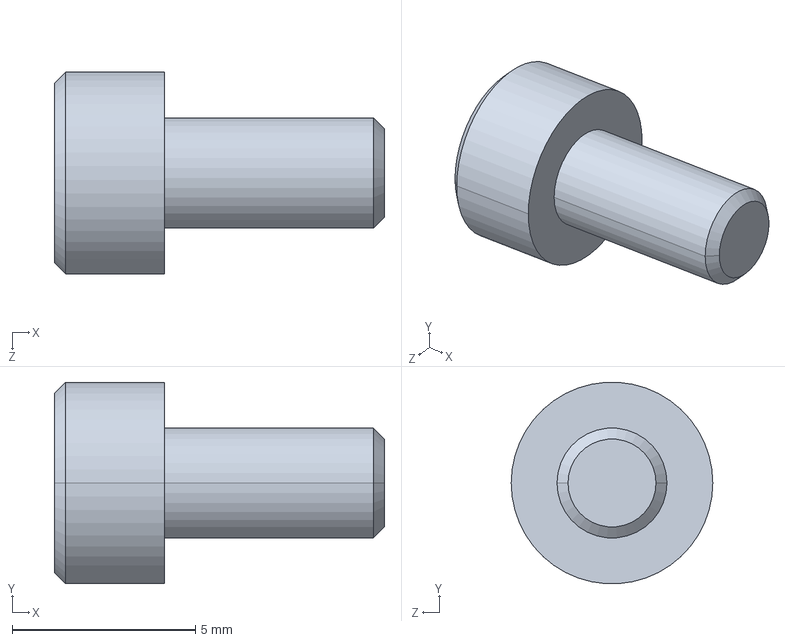
[picture p128: CAD file, 2024-10-24]
3D/总装测试/紧固件/M3/内六角圆柱头螺钉M3-L6.SLDPRT
9.00 x 5.49 x 5.50 mm
