NeekoNoNeko/Engineering_Competition/3D/42步进电机连接部件/42电机支架(金属).SLDPRT

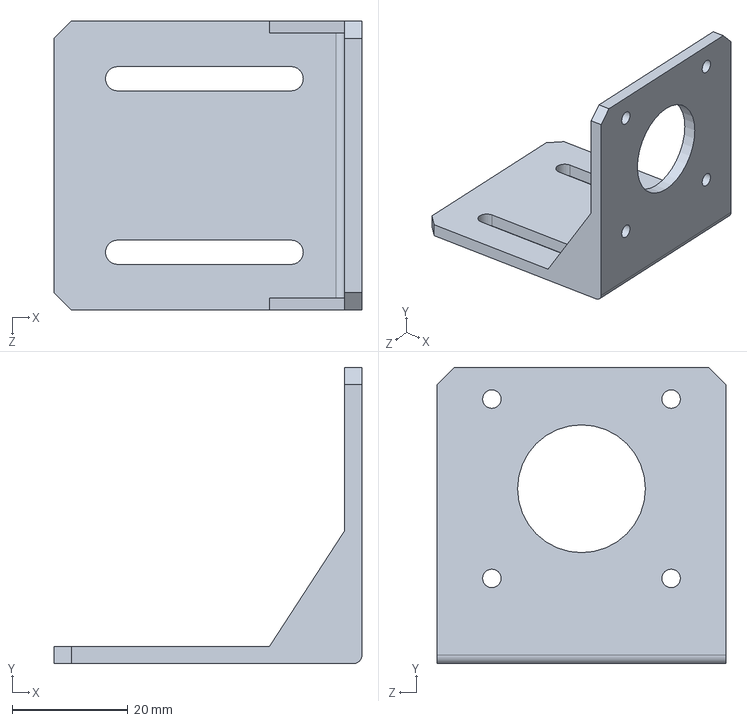
[picture p129: CAD file, 2024-10-24]
3D/42步进电机连接部件/42电机支架(金属).SLDPRT
53.2 x 51.2 x 50.0 mm
