NeekoNoNeko/Engineering_Competition/3D/600mm滑轨.SLDPRT

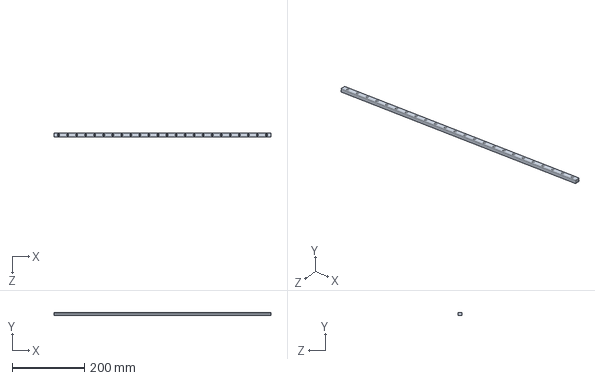
[picture p130: CAD file, 2024-10-24]
3D/600mm滑轨.SLDPRT
600.0 x 8.00 x 12.0 mm
