NeekoNoNeko/Engineering_Competition/3D/SolidWorks/备份/梯形丝杠╱梯形丝杆螺母[TN8X10X2NR╱200×200Cu]/螺母.SLDPRT

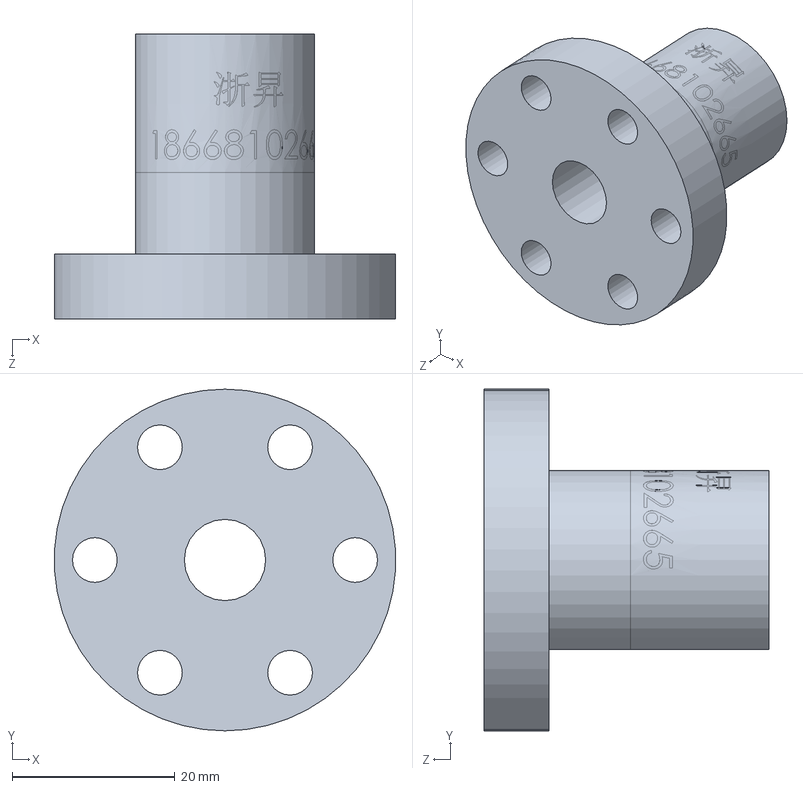
[picture p131: CAD file, 2024-10-24]
3D/SolidWorks/备份/梯形丝杠╱梯形丝杆螺母[TN8X10X2NR╱200×200Cu]/螺母.SLDPRT
41.9 x 42.0 x 35.0 mm
