NeekoNoNeko/Engineering_Competition/3D/SolidWorks/备份/爪子/槽.SLDPRT

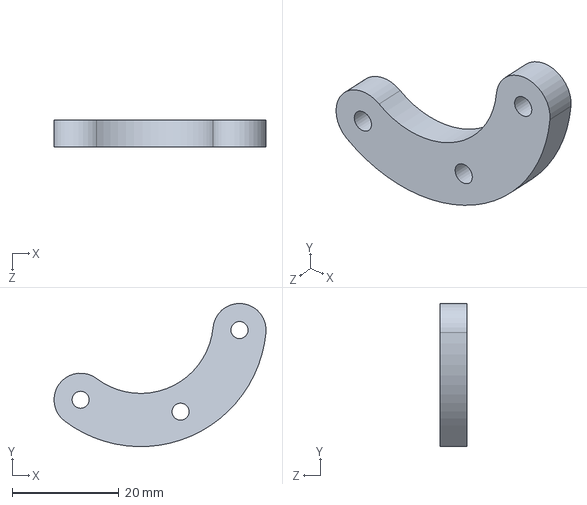
[picture p132: CAD file, 2024-10-24]
3D/SolidWorks/备份/爪子/槽.SLDPRT
39.7 x 26.8 x 5.00 mm
