NeekoNoNeko/Engineering_Competition/3D/SolidWorks/备份/直线轴承LMF-K-H系列[LMF8UU].sldprt

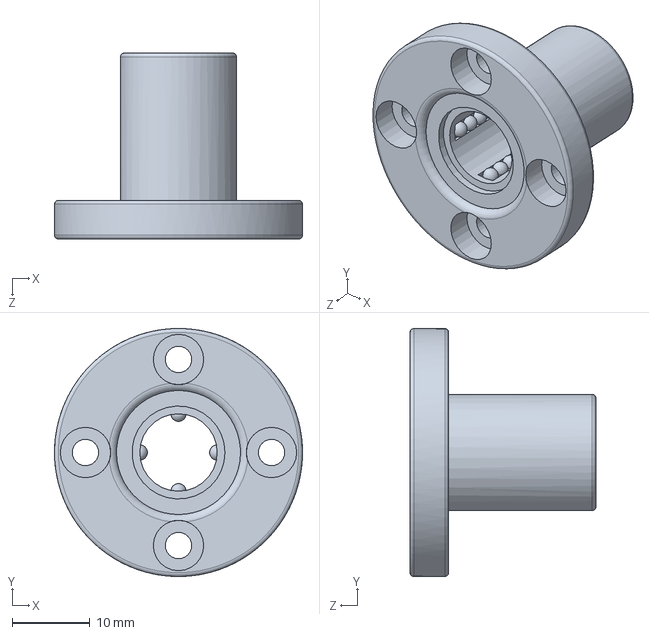
[picture p133: CAD file, 2024-10-24]
3D/SolidWorks/备份/直线轴承LMF-K-H系列[LMF8UU].sldprt
32.0 x 32.0 x 24.0 mm
