NeekoNoNeko/Engineering_Competition/3D/SolidWorks/备份/矢量概念机械臂爪标准伺服/temp/arm-bottom-plate.STL

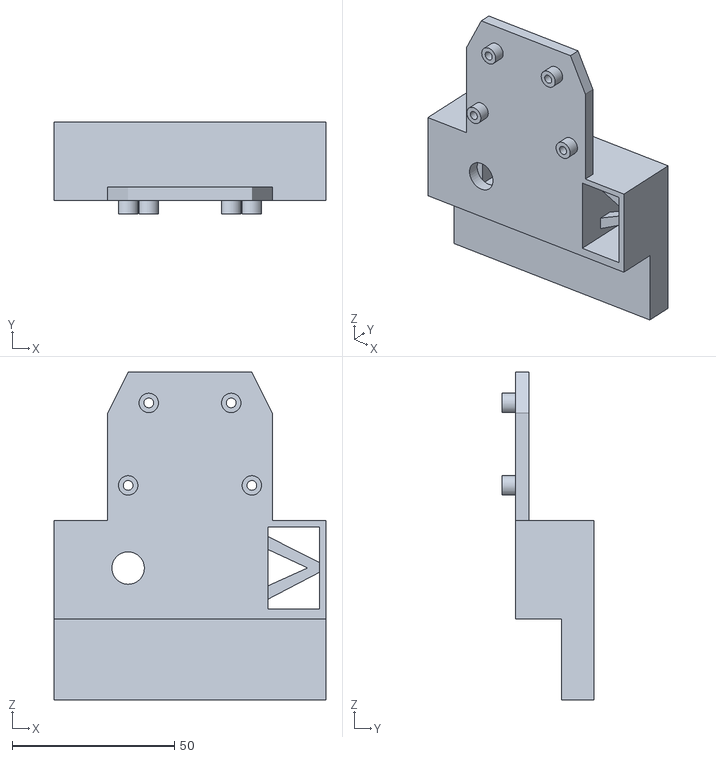
[picture p134: CAD file, 2024-10-24]
3D/SolidWorks/备份/矢量概念机械臂爪标准伺服/temp/arm-bottom-plate.STL
83.7 x 28.2 x 101.0
