NeekoNoNeko/Engineering_Competition/3D/总装测试/STL/药瓶拨片.STL

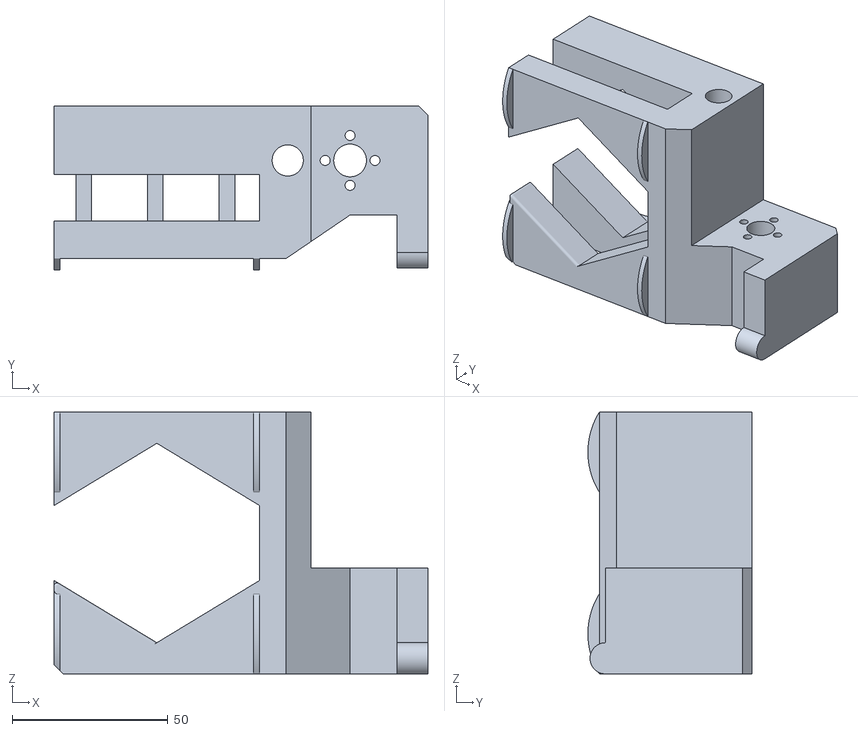
[picture p135: CAD file, 2024-10-24]
3D/总装测试/STL/药瓶拨片.STL
120.0 x 52.7 x 84.0
