NeekoNoNeko/Engineering_Competition/3D/总装测试/Z轴/M3弹珠螺母.SLDPRT

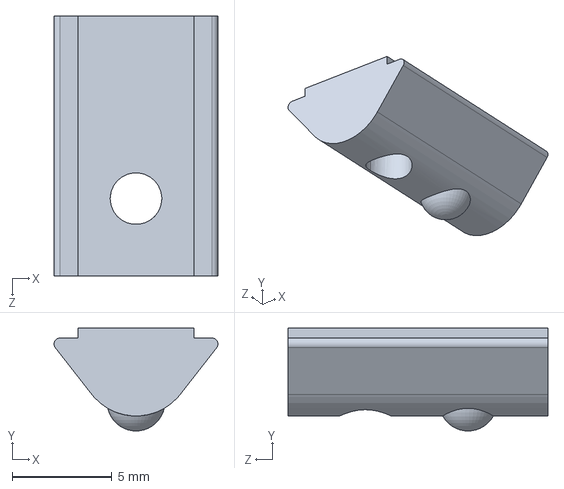
[picture p136: CAD file, 2024-10-24]
3D/总装测试/Z轴/M3弹珠螺母.SLDPRT
8.20 x 5.15 x 13.0 mm
