NeekoNoNeko/Engineering_Competition/3D/总装测试/紧固件/M3/平垫圈M3.SLDPRT

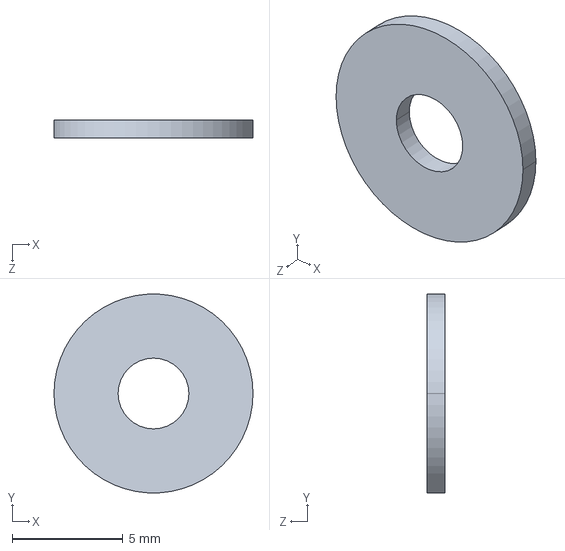
[picture p137: CAD file, 2024-10-24]
3D/总装测试/紧固件/M3/平垫圈M3.SLDPRT
9.00 x 8.98 x 0.8 mm
