NeekoNoNeko/Engineering_Competition/3D/总装测试/紧固件/压铸角码/内六角圆柱头螺钉M4L10.SLDPRT

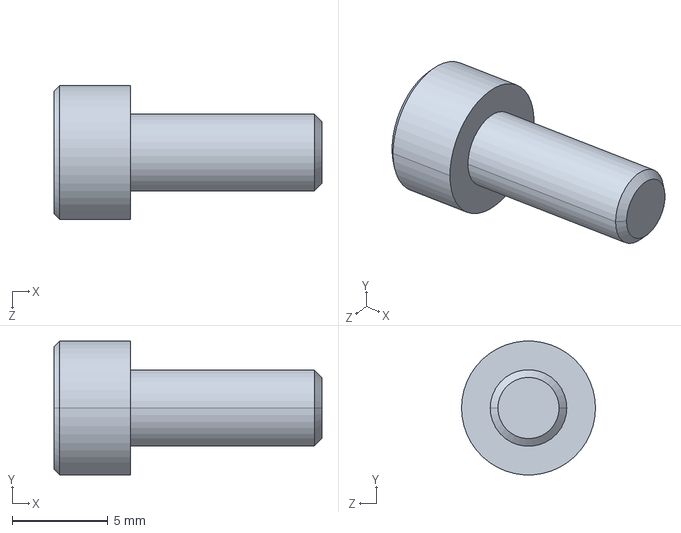
[picture p139: CAD file, 2024-10-24]
3D/总装测试/紧固件/压铸角码/内六角圆柱头螺钉M4L10.SLDPRT
14.0 x 6.98 x 7.00 mm
