NeekoNoNeko/Engineering_Competition/3D/滑台连型材/滑台to型材转换板.SLDPRT

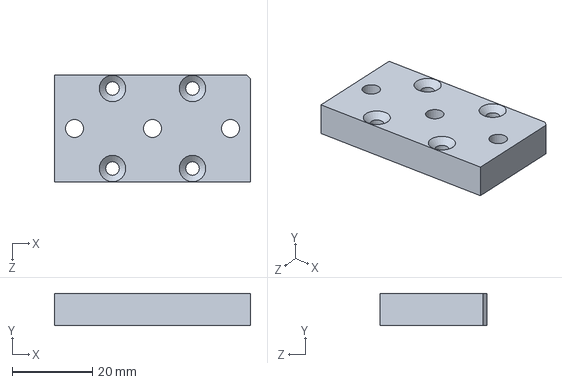
[picture p140: CAD file, 2024-10-24]
3D/滑台连型材/滑台to型材转换板.SLDPRT
49.0 x 8.00 x 26.8 mm
