NeekoNoNeko/Engineering_Competition/3D/SolidWorks/备份/爪子/夹子.SLDPRT

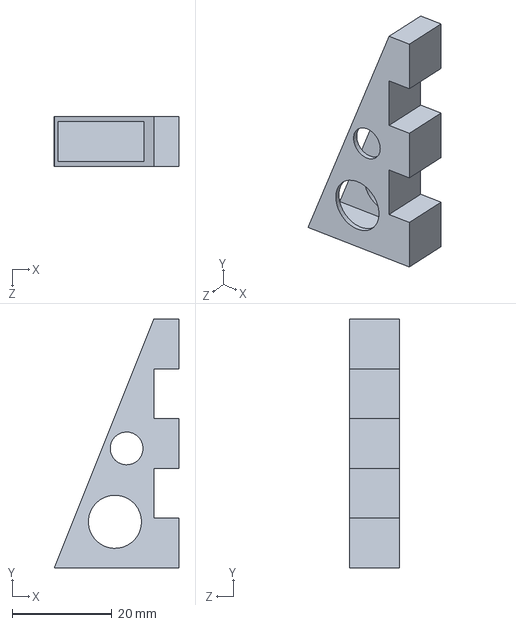
[picture p141: CAD file, 2024-10-24]
3D/SolidWorks/备份/爪子/夹子.SLDPRT
25.0 x 50.0 x 10.0 mm
