NeekoNoNeko/Engineering_Competition/3D/SolidWorks/备份/近电机端.SLDPRT

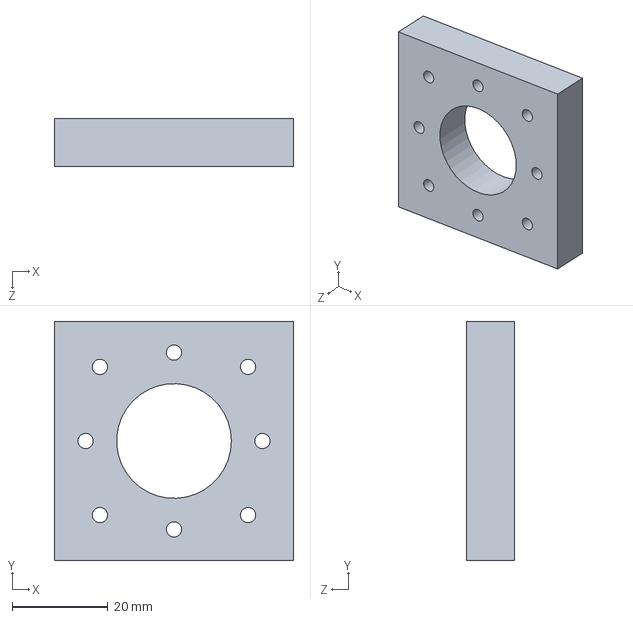
[picture p142: CAD file, 2024-10-24]
3D/SolidWorks/备份/近电机端.SLDPRT
50.0 x 50.0 x 10.0 mm
