NeekoNoNeko/Engineering_Competition/3D/SolidWorks/药瓶夹具支架.SLDPRT

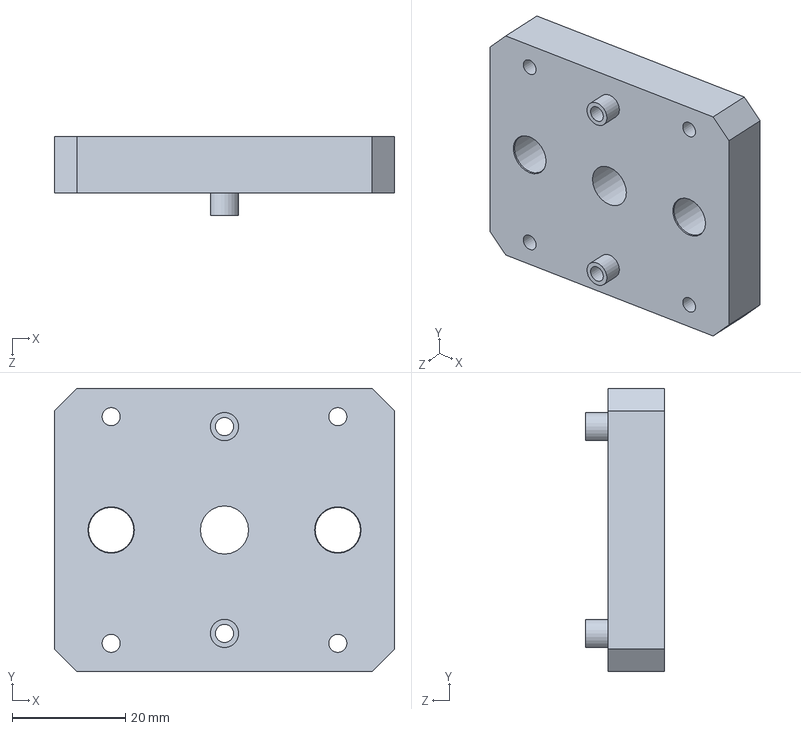
[picture p143: CAD file, 2024-10-24]
3D/SolidWorks/药瓶夹具支架.SLDPRT
60.0 x 50.0 x 14.0 mm
