NeekoNoNeko/Engineering_Competition/3D/总装测试/STL/远电机端.3.0.STL

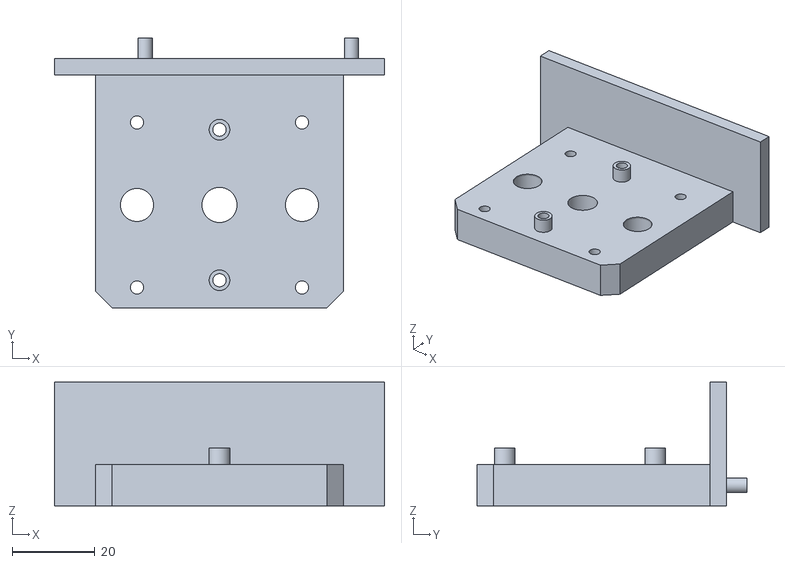
[picture p144: CAD file, 2024-10-24]
3D/总装测试/STL/远电机端.3.0.STL
80.0 x 65.5 x 30.0
