NeekoNoNeko/Engineering_Competition/3D/总装测试/X轴/单独配件/滑台to型材转换板加大加主控.SLDPRT

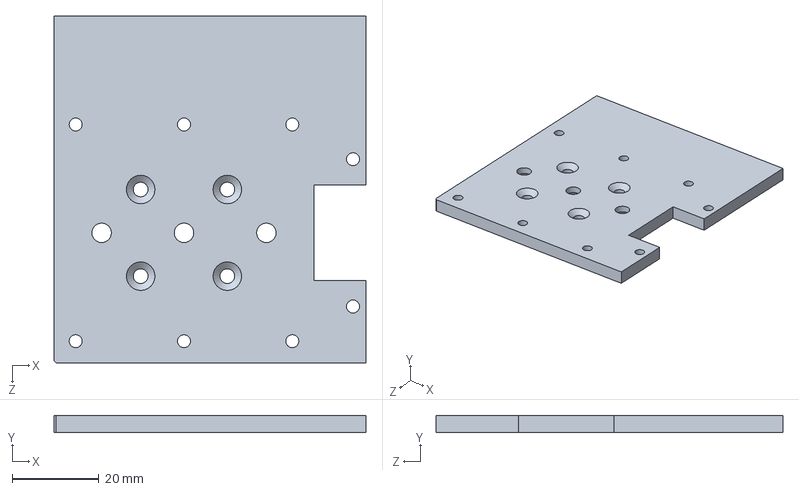
[picture p145: CAD file, 2024-10-24]
3D/总装测试/X轴/单独配件/滑台to型材转换板加大加主控.SLDPRT
72.0 x 4.00 x 80.0 mm
