NeekoNoNeko/Engineering_Competition/3D/总装测试/Y轴/2020-L630.SLDPRT

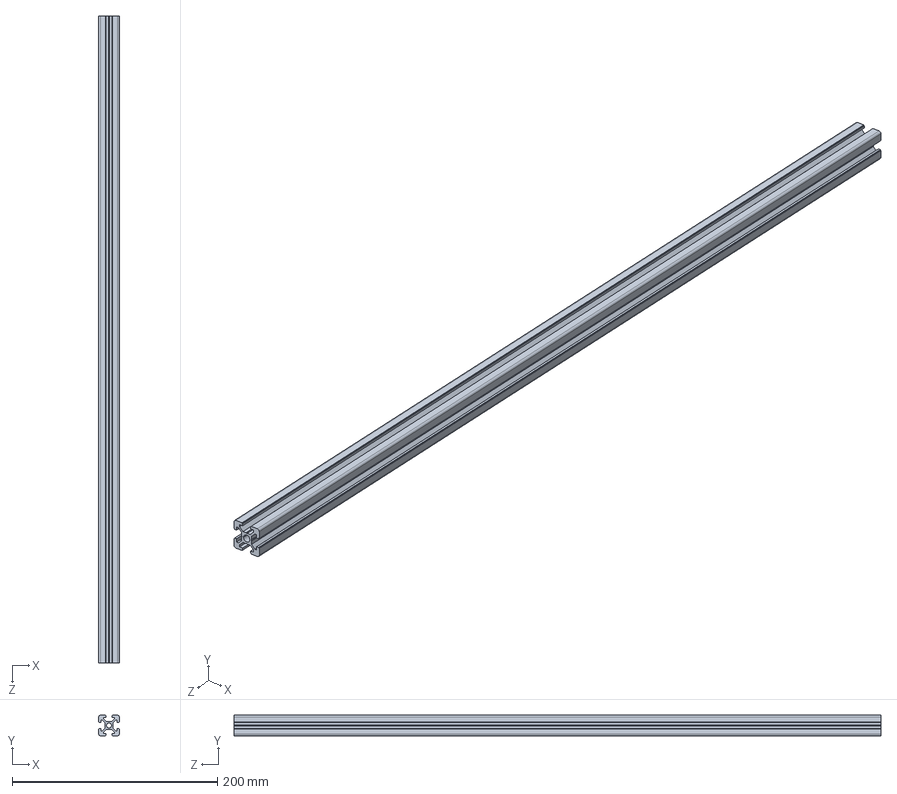
[picture p146: CAD file, 2024-10-24]
3D/总装测试/Y轴/2020-L630.SLDPRT
20.0 x 20.0 x 630.0 mm
