NeekoNoNeko/Engineering_Competition/3D/总装测试/共用配件/丝杆AND光轴400mm.SLDPRT

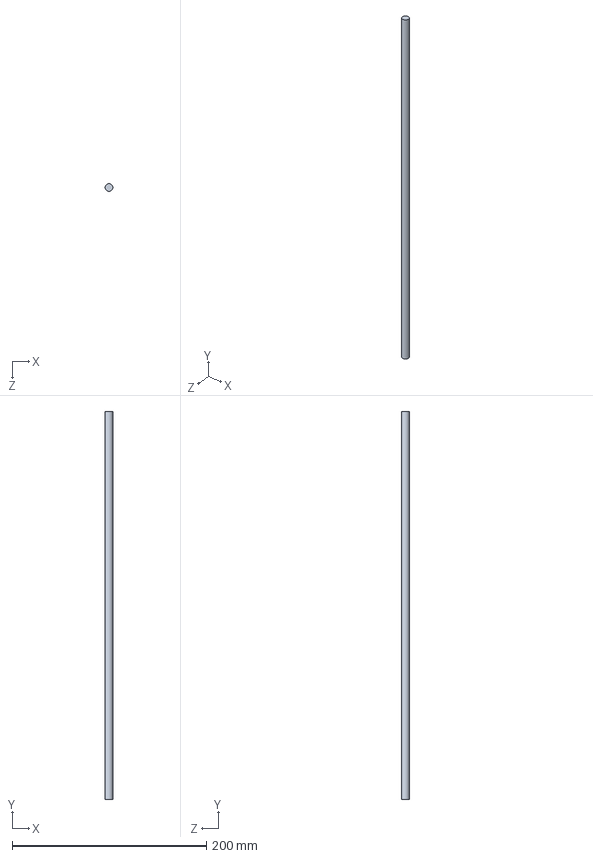
[picture p147: CAD file, 2024-10-24]
3D/总装测试/共用配件/丝杆AND光轴400mm.SLDPRT
8.00 x 400.0 x 8.00 mm
