NeekoNoNeko/Engineering_Competition/3D/总装测试/外框/光轴固定座.SLDPRT

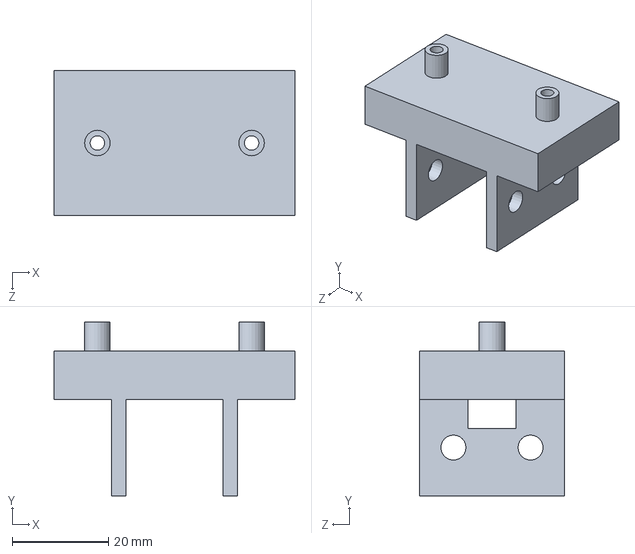
[picture p148: CAD file, 2024-10-24]
3D/总装测试/外框/光轴固定座.SLDPRT
50.0 x 36.0 x 30.0 mm
