NeekoNoNeko/Engineering_Competition/3D/总装测试/紧固件/M3/内六角圆柱头螺钉M3-L8.SLDPRT

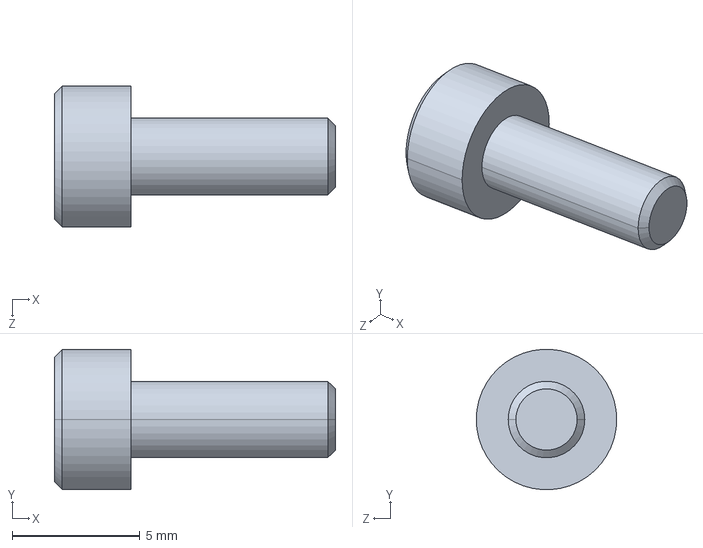
[picture p149: CAD file, 2024-10-24]
3D/总装测试/紧固件/M3/内六角圆柱头螺钉M3-L8.SLDPRT
11.0 x 5.49 x 5.50 mm
