NeekoNoNeko/Engineering_Competition/3D/总装测试/紧固件/M5套装/十字槽沉头螺钉M5-L8.SLDPRT

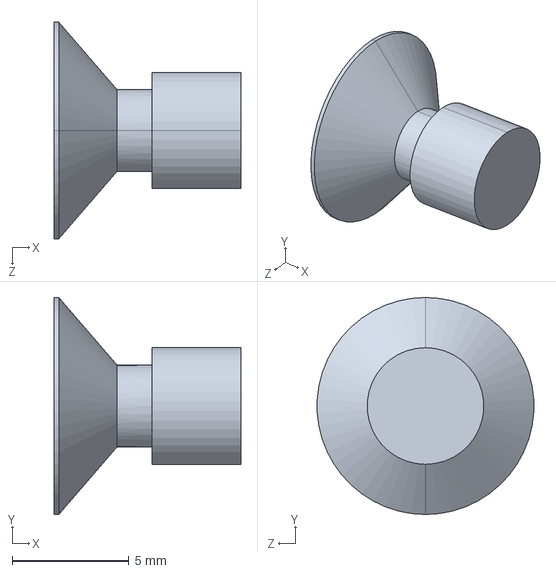
[picture p150: CAD file, 2024-10-24]
3D/总装测试/紧固件/M5套装/十字槽沉头螺钉M5-L8.SLDPRT
8.00 x 9.30 x 9.28 mm
