NeekoNoNeko/Engineering_Competition/3D/42步进电机连接部件/42步进电机连接部件.SLDPRT

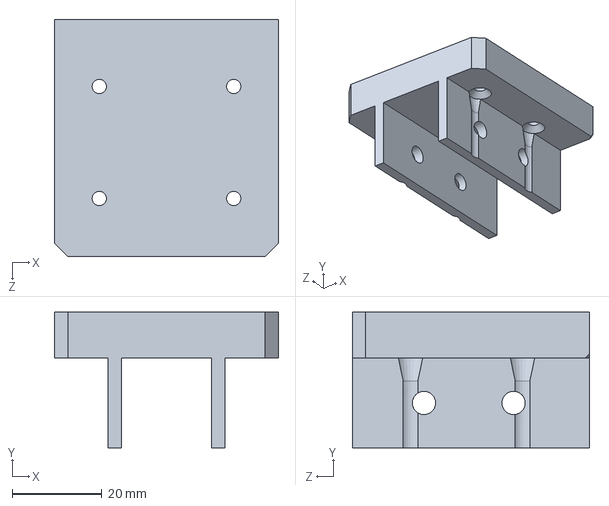
[picture p151: CAD file, 2024-10-24]
3D/42步进电机连接部件/42步进电机连接部件.SLDPRT
50.0 x 30.2 x 53.0 mm
