NeekoNoNeko/Engineering_Competition/3D/SolidWorks/备份/donttouch.SLDPRT

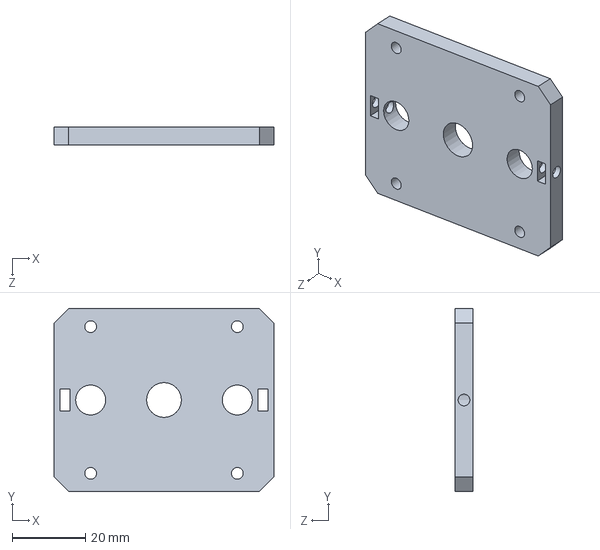
[picture p152: CAD file, 2024-10-24]
3D/SolidWorks/备份/donttouch.SLDPRT
60.0 x 50.0 x 5.00 mm
