NeekoNoNeko/Engineering_Competition/3D/SolidWorks/备份/爪子/滑动2.SLDPRT

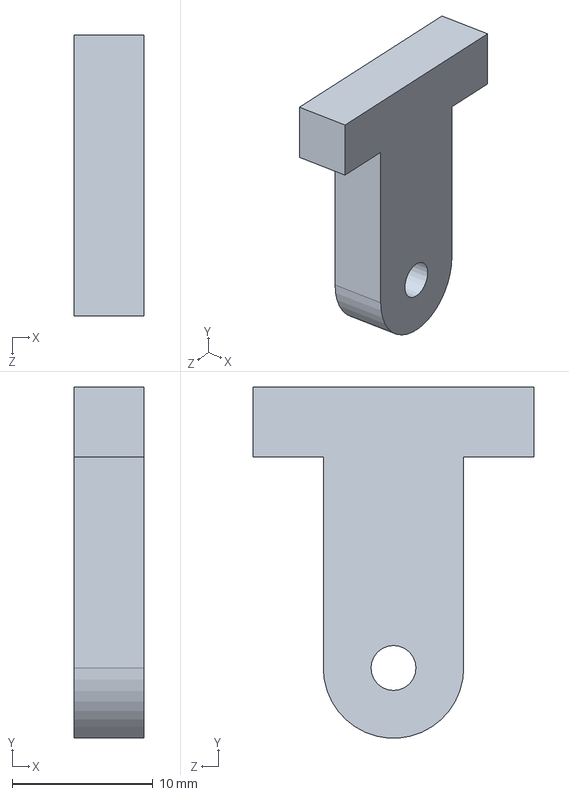
[picture p153: CAD file, 2024-10-24]
3D/SolidWorks/备份/爪子/滑动2.SLDPRT
5.00 x 25.0 x 20.0 mm
