NeekoNoNeko/Engineering_Competition/3D/SolidWorks/打印切片.3mf

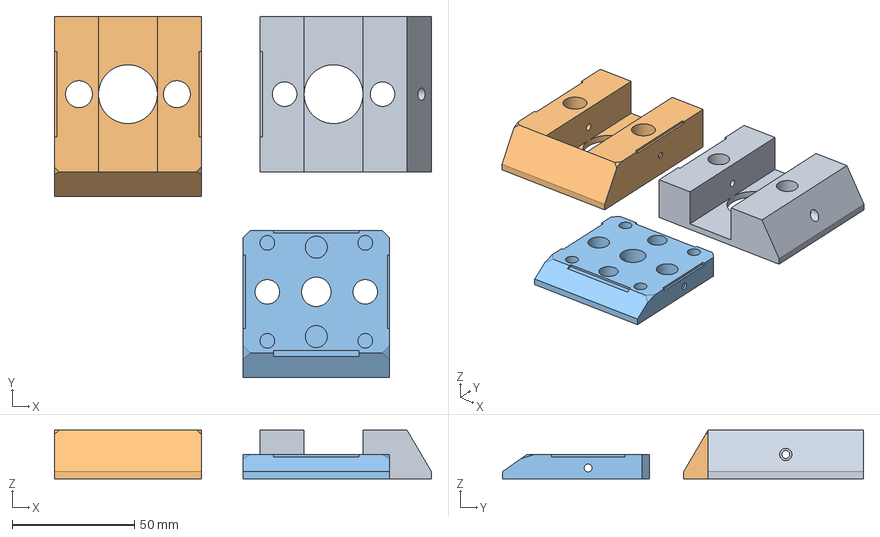
[picture p154: CAD file, 2024-10-24]
3D/SolidWorks/打印切片.3mf
154.0 x 147.5 x 20.0 mm
Y轴挡板1.1.STL
X轴挡板1.0.STL
Z轴挡板2.0.STL
