NeekoNoNeko/Engineering_Competition/3D/总装测试/STL/主控板支撑.STL

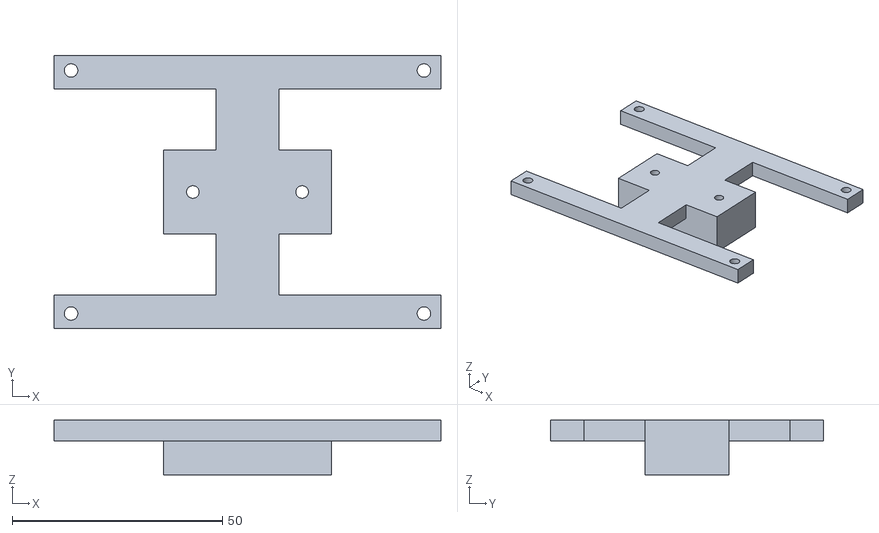
[picture p155: CAD file, 2024-10-24]
3D/总装测试/STL/主控板支撑.STL
92.1 x 65.0 x 13.0
