NeekoNoNeko/Engineering_Competition/3D/总装测试/X轴/单独配件/线轨12-L545.SLDPRT

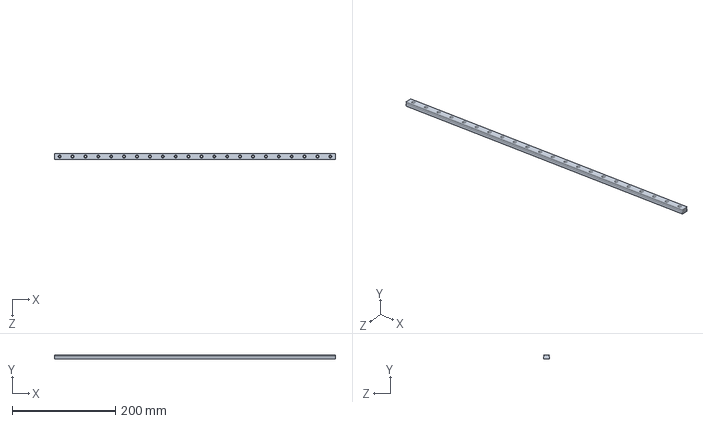
[picture p156: CAD file, 2024-10-24]
3D/总装测试/X轴/单独配件/线轨12-L545.SLDPRT
545.0 x 8.00 x 12.0 mm
