NeekoNoNeko/Engineering_Competition/3D/总装测试/Z轴/FDD3A631716ED7DBAE9ACCC91DB01713.SLDPRT(1).SLDPRT

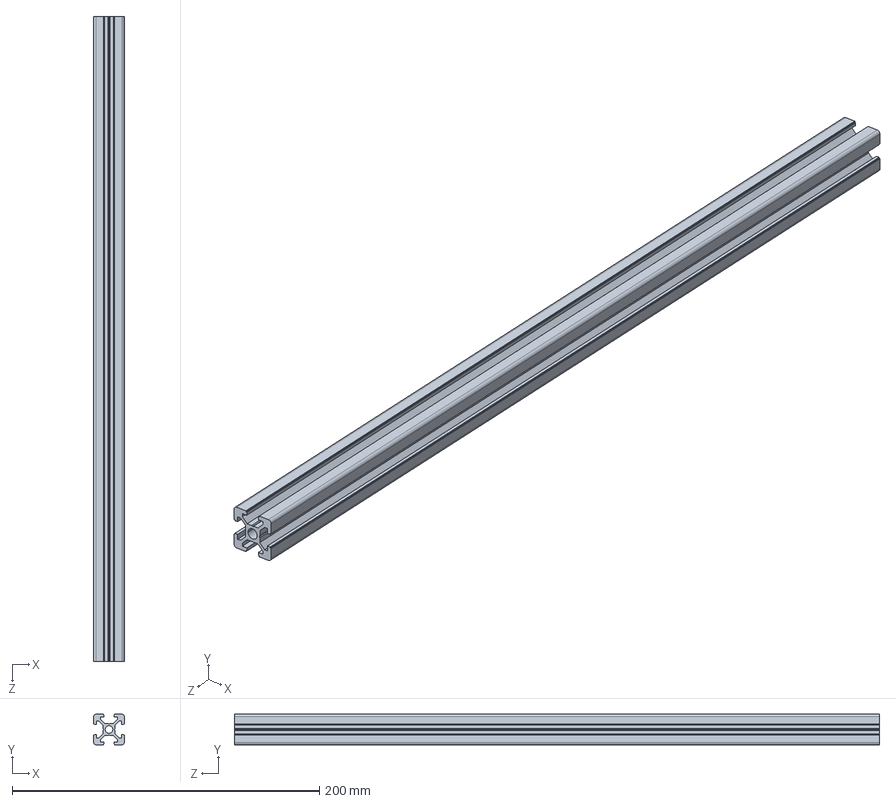
[picture p157: CAD file, 2024-10-24]
3D/总装测试/Z轴/FDD3A631716ED7DBAE9ACCC91DB01713.SLDPRT(1).SLDPRT
20.0 x 20.0 x 420.0 mm
