NeekoNoNeko/Engineering_Competition/3D/总装测试/外框/2020-L566.SLDPRT

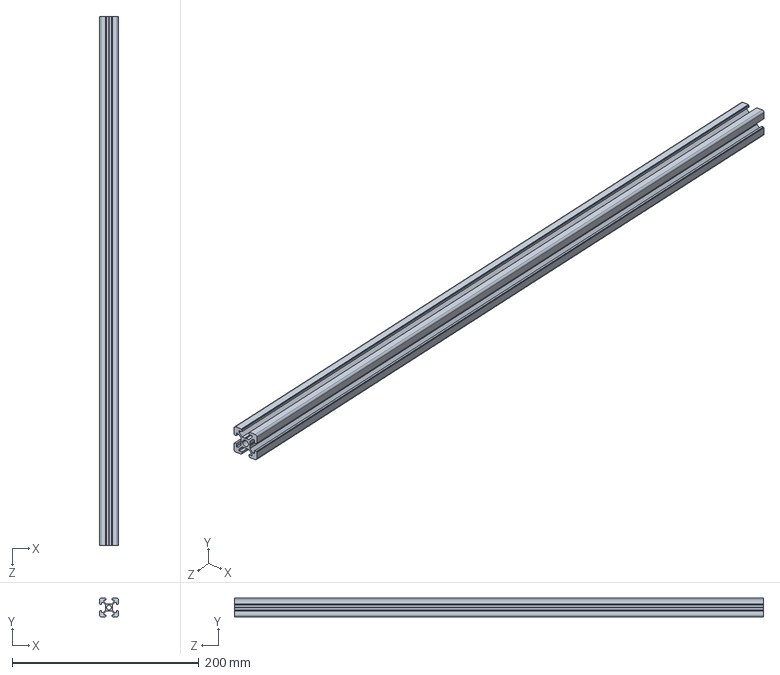
[picture p158: CAD file, 2024-10-24]
3D/总装测试/外框/2020-L566.SLDPRT
20.0 x 20.0 x 566.0 mm
