NeekoNoNeko/Engineering_Competition/3D/总装测试/紧固件/M3/十字槽沉头螺钉M3-L16.SLDPRT

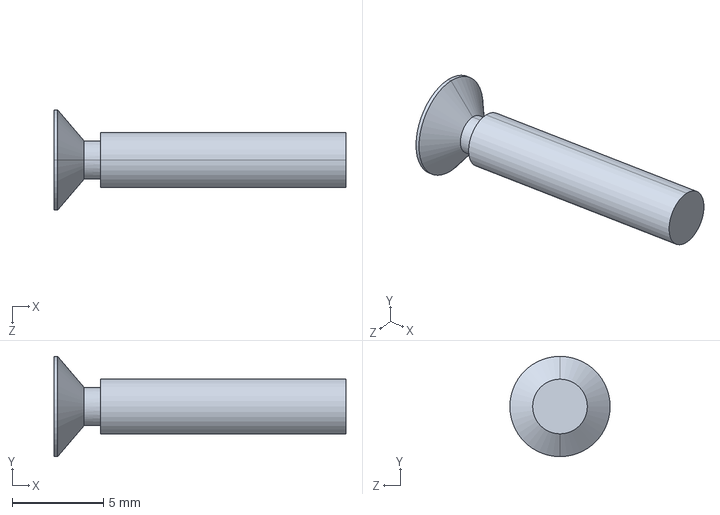
[picture p159: CAD file, 2024-10-24]
3D/总装测试/紧固件/M3/十字槽沉头螺钉M3-L16.SLDPRT
16.0 x 5.50 x 5.50 mm
