NeekoNoNeko/Engineering_Competition/3D/总装测试/紧固件/M5套装/内六角圆柱头螺钉M5.SLDPRT

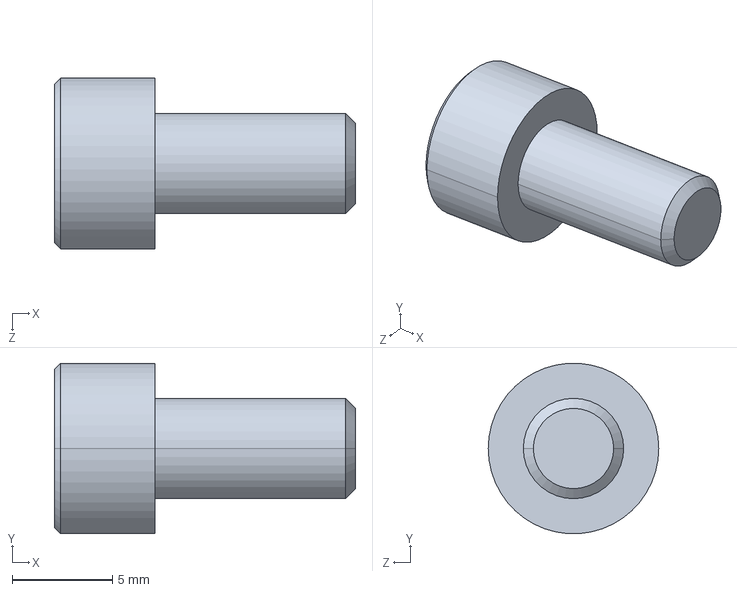
[picture p160: CAD file, 2024-10-24]
3D/总装测试/紧固件/M5套装/内六角圆柱头螺钉M5.SLDPRT
15.0 x 8.48 x 8.50 mm
