NeekoNoNeko/Engineering_Competition/3D/SolidWorks/药瓶夹具装配体1.SLDASM

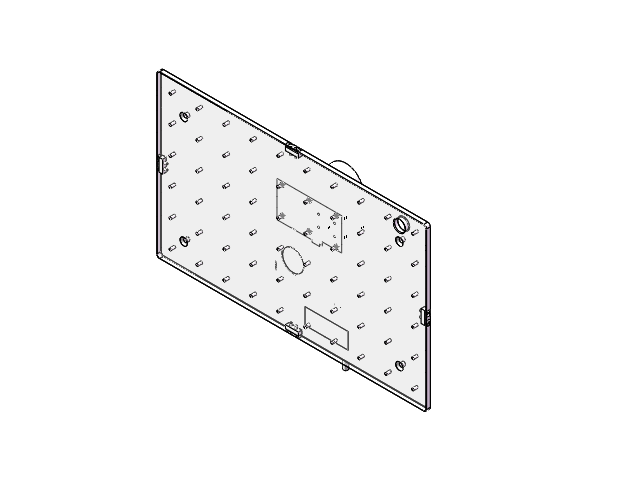
[picture p161: CAD file, 2024-10-24]
3D/SolidWorks/药瓶夹具装配体1.SLDASM
操作板
零件1
42电机支架(金属)
42系列两相混合式步进电机[42HS04A]
直流减速电机支架
MG513直流减速电机
65mm轮子
瓶子含瓶盖
200mm光轴 x 2
弹性联轴器
远电机端.3.0
药瓶拨片
