NeekoNoNeko/Engineering_Competition/3D/总装测试/X轴/测试/丝杆轴承固定座装配体.SLDASM

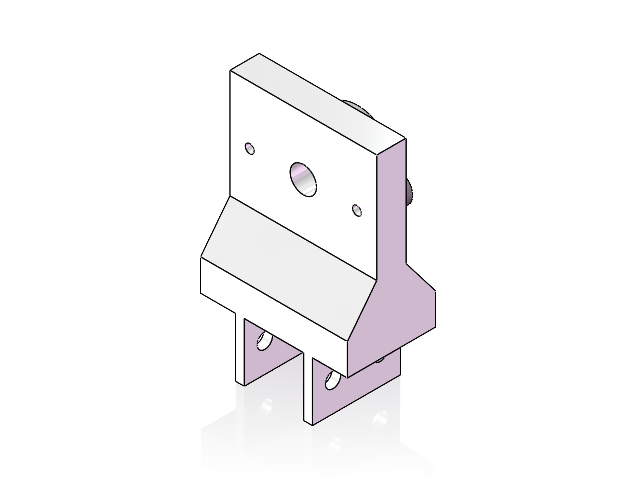
[picture p162: CAD file, 2024-10-24]
3D/总装测试/X轴/测试/丝杆轴承固定座装配体.SLDASM
丝杆轴承固定件
FLANGE^KFL08
BEARING^KFL08
socket set screw cone point_am x 2
