NeekoNoNeko/Engineering_Competition/3D/总装测试/外框/光轴支架装配体.SLDASM

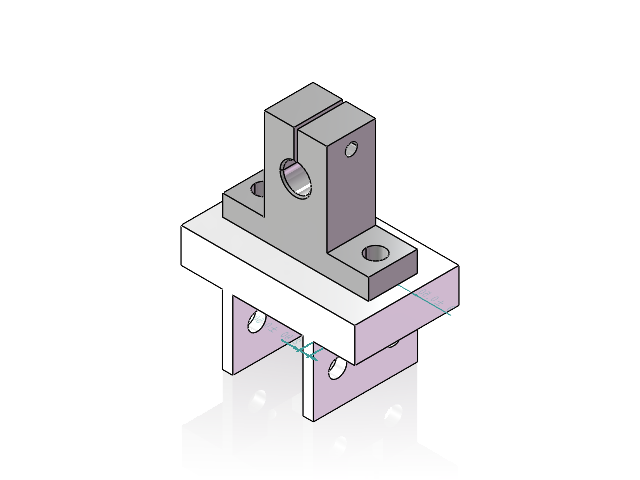
[picture p163: CAD file, 2024-10-24]
3D/总装测试/外框/光轴支架装配体.SLDASM
光轴固定座
法兰型导向轴支座
