NeekoNoNeko/Engineering_Competition/3D/总装测试/拧瓶盖/拧瓶盖装配体/装配体2.SLDASM

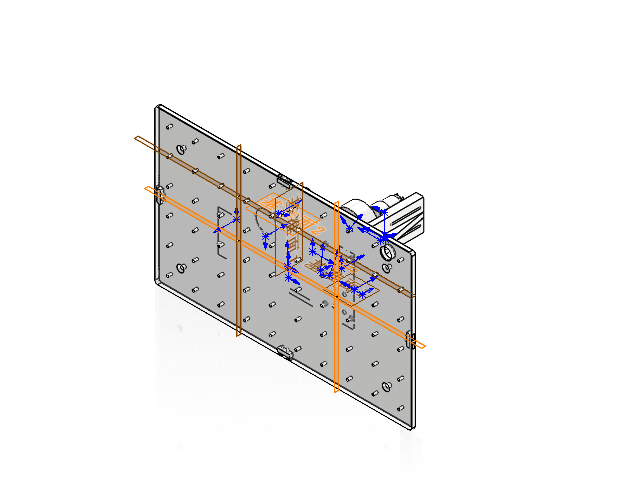
[picture p164: CAD file, 2024-10-24]
3D/总装测试/拧瓶盖/拧瓶盖装配体/装配体2.SLDASM
操作板
电机座
直流减速电机支架
MG513直流减速电机
65mm轮子
瓶子含瓶盖
药瓶拨片
42电机支架(金属)
42系列两相混合式步进电机[42HS04A]
弹性联轴器
200mm光轴 x 2
远电机端.3.0
