NeekoNoNeko/Engineering_Competition/3D/总装测试/紧固件/M5套装/M5套装装配体.SLDASM

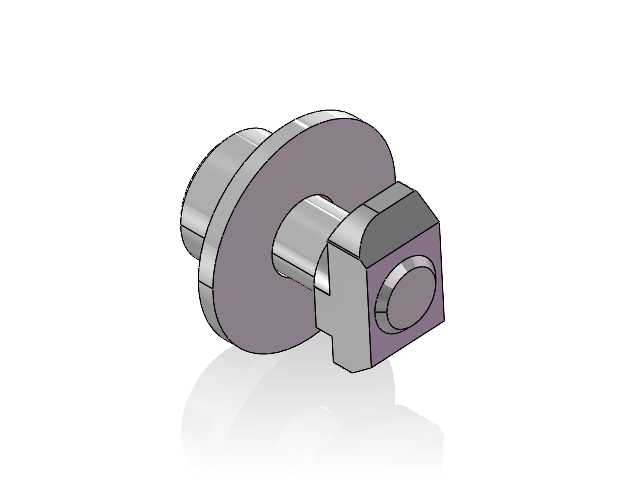
[picture p165: CAD file, 2024-10-24]
3D/总装测试/紧固件/M5套装/M5套装装配体.SLDASM
内六角圆柱头螺钉M5
平垫圈A级M5
T型螺母M5
