NeekoNoNeko/Engineering_Competition/3D/滑台连型材/滑台连接型材装配体.SLDASM

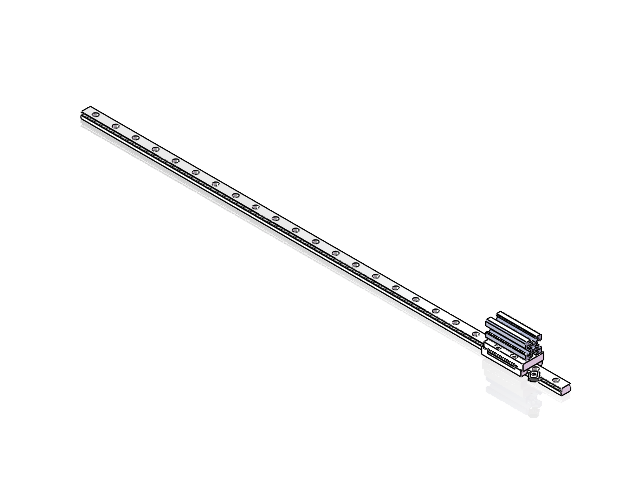
[picture p166: CAD file, 2024-10-24]
3D/滑台连型材/滑台连接型材装配体.SLDASM
600mm滑轨
600mm滑台
8FE104D78F57084BAF3C98AD11D37C0D.SLDPRT(1)
滑块螺母M4 x 2
滑台to型材转换板
