NeekoNoNeko/Engineering_Competition/3D/总装测试/Z轴/2020L装配体.SLDASM

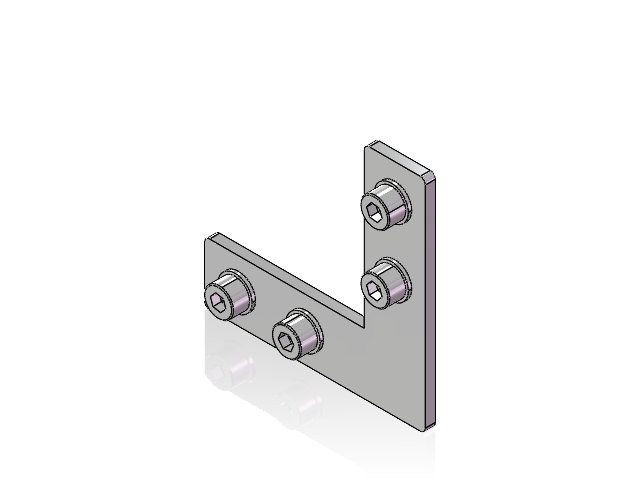
[picture p167: CAD file, 2024-10-24]
3D/总装测试/Z轴/2020L装配体.SLDASM
TPDD-206-2020L-ZP
EDLA-S1-M5-L10 x 4
平垫圈M5 x 4
