NeekoNoNeko/Engineering_Competition/3D/总装配体测试.SLDASM

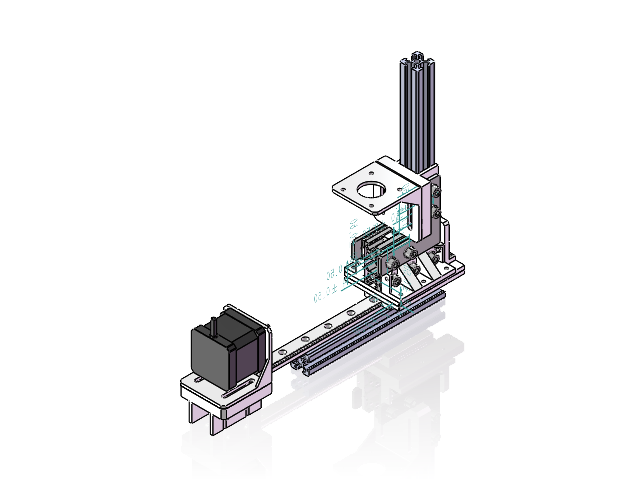
[picture p168: CAD file, 2024-10-24]
3D/总装配体测试.SLDASM
150mm2020 x 2
150mm线轨
42电机支架(金属) x 2
42系列两相混合式步进电机[42HS04A]
42步进电机连接部件 x 2
600mm滑台
滑台to型材转换板加大 x 2
2040-L60
内六角紧定螺钉-M5-L6 x 2
浇铸槽内连接件
TPDD-206-2020L-ZP x 2
EDLA-S1-M5-L10 x 15
平垫圈M5 x 14
侧面支撑 x 2
M3螺母 x 8
丝杆螺母封盖
丝杆螺母
十字槽沉头螺钉M3-L10
