NeekoNoNeko/Engineering_Competition/3D/滑台连型材/滑台连接型材装配体3.0.SLDASM

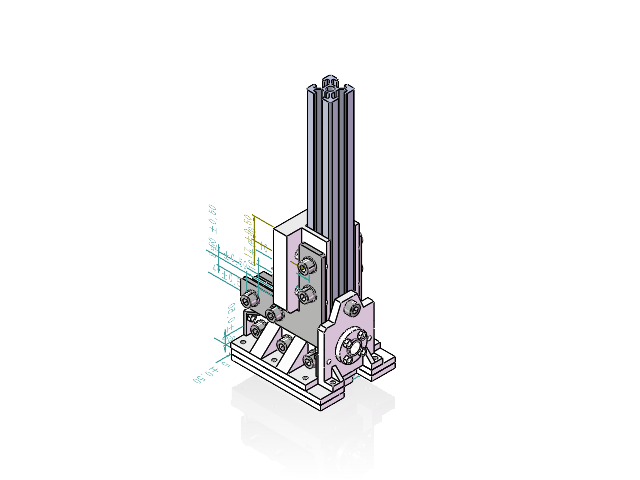
[picture p169: CAD file, 2024-10-24]
3D/滑台连型材/滑台连接型材装配体3.0.SLDASM
600mm滑台
滑台to型材转换板加大 x 2
2040-L60
150mm2020
内六角紧定螺钉-M5-L6 x 2
浇铸槽内连接件
42步进电机连接部件
TPDD-206-2020L-ZP x 2
EDLA-S1-M5-L10 x 15
平垫圈M5 x 14
侧面支撑 x 2
M3螺母 x 8
丝杆螺母封盖
丝杆螺母
十字槽沉头螺钉M3-L10
