NeekoNoNeko/Engineering_Competition/3D/SolidWorks/openmv装配体.SLDASM

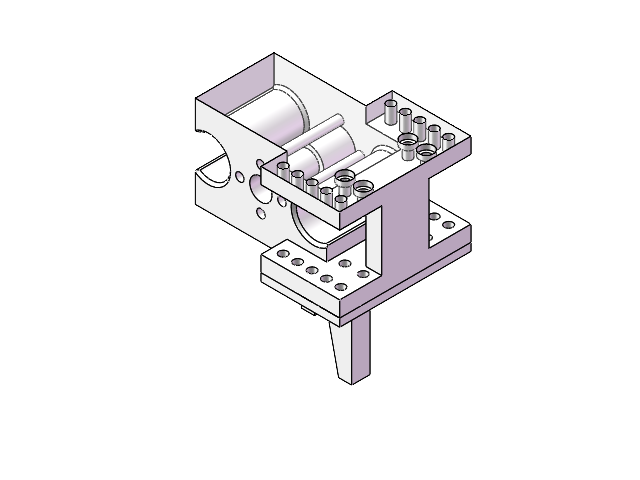
[picture p170: CAD file, 2024-10-24]
3D/SolidWorks/openmv装配体.SLDASM
滑台支架
openmv支架
