NeekoNoNeko/Engineering_Competition/3D/总装测试/外框/X轴框.SLDASM

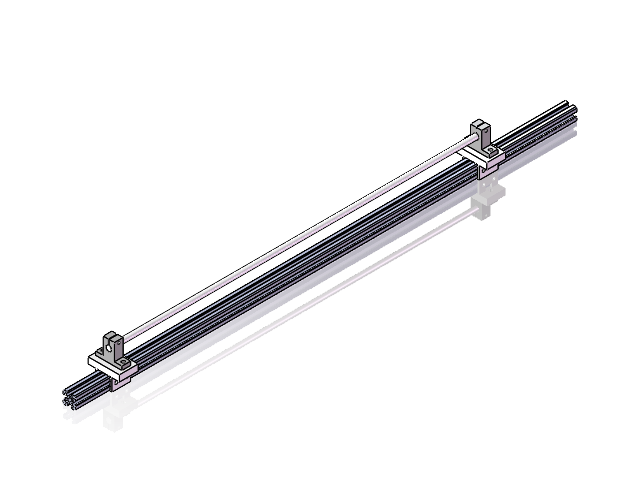
[picture p171: CAD file, 2024-10-24]
3D/总装测试/外框/X轴框.SLDASM
2020-L800
光轴固定座 x 2
法兰型导向轴支座 x 2
600mm丝杆and光轴
