NeekoNoNeko/Engineering_Competition/3D/42步进电机连接部件/42步进电机连接部件装配体.SLDASM

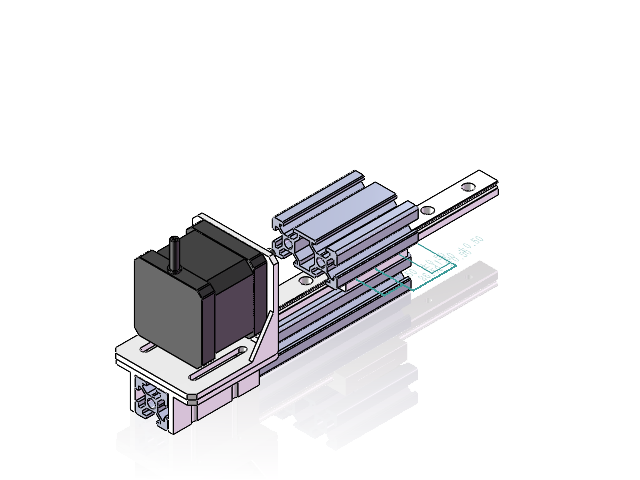
[picture p172: CAD file, 2024-10-24]
3D/42步进电机连接部件/42步进电机连接部件装配体.SLDASM
150mm2020
150mm线轨
滑台
42电机支架(金属)
42系列两相混合式步进电机[42HS04A]
42步进电机连接部件
M3弹珠螺母
内六角圆柱头螺钉M3-6mm(min_7.5)
