NeekoNoNeko/Engineering_Competition/3D/总装测试/Z轴/侧面支撑装配体.SLDASM

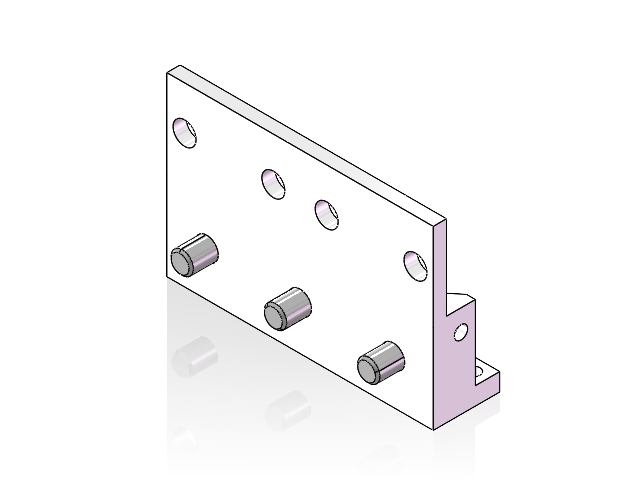
[picture p173: CAD file, 2024-10-24]
3D/总装测试/Z轴/侧面支撑装配体.SLDASM
侧面支撑
M3螺母 x 2
平垫圈M5 x 3
EDLA-S1-M5-L10 x 3
