NeekoNoNeko/Engineering_Competition/3D/总装测试/紧固件/压铸角码/压铸角码装配体.SLDASM

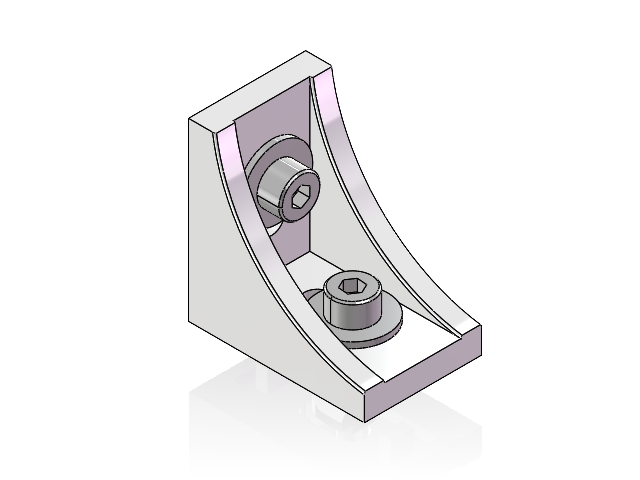
[picture p174: CAD file, 2024-10-24]
3D/总装测试/紧固件/压铸角码/压铸角码装配体.SLDASM
压铸角码
T型螺母M4 x 2
内六角圆柱头螺钉M4L10 x 2
平垫圈A级M4 x 2
