NeekoNoNeko/Engineering_Competition/3D/滑台连型材/滑台连接型材装配体2.0.SLDASM

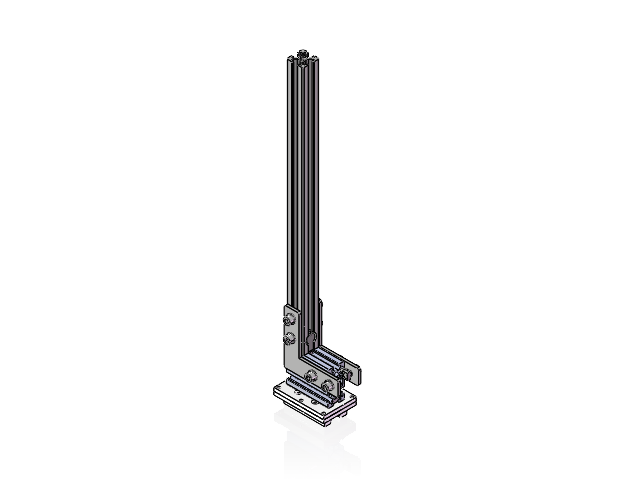
[picture p175: CAD file, 2024-10-24]
3D/滑台连型材/滑台连接型材装配体2.0.SLDASM
600mm滑台
滑台to型材转换板加大 x 2
滑块螺母M4 x 3
20系列T型螺母M4 x 2
内六角圆柱头螺钉M4L14 x 2
内置连接件 x 2
TXCJ-H6-6-2020-L300-LDH
TPDD-206-2020L-ZP x 2
EDLA-S1-M5-L10 x 8
平垫圈M5 x 8
