NeekoNoNeko/Engineering_Competition/3D/总装测试/Y轴/气泵相机装配体.SLDASM

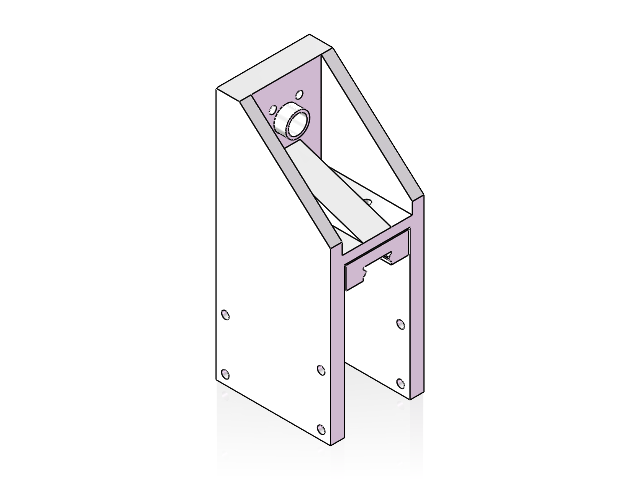
[picture p176: CAD file, 2024-10-24]
3D/总装测试/Y轴/气泵相机装配体.SLDASM
滑台加长型12H-L400
Y轴滑台连丝杆
丝杆螺母
