NeekoNoNeko/Engineering_Competition/3D/总装测试/Y轴/Y轴测试.SLDASM

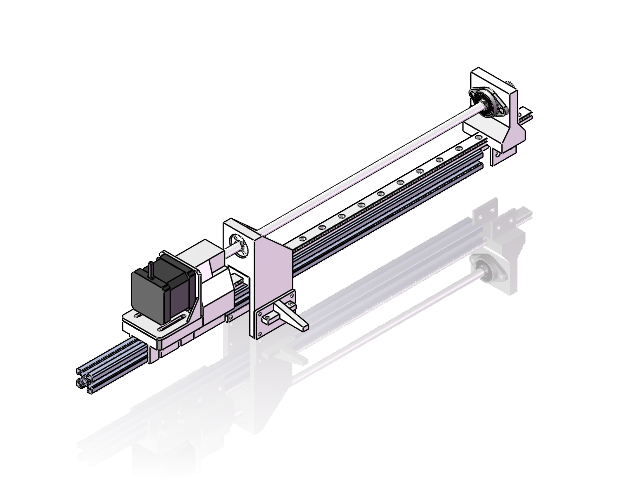
[picture p177: CAD file, 2024-10-24]
3D/总装测试/Y轴/Y轴测试.SLDASM
71273C4CE3CE214AF15714B85C379AF9.SLDPRT(1)
42步进电机连接部件
42电机支架(金属)
42系列两相混合式步进电机[42HS04A]
FLANGE^KFL08
BEARING^KFL08
socket set screw cone point_am x 2
防撞块
刚性联轴器
滑台加长型12H-L400
丝杆AND光轴400mm
丝杆轴承固定件
线轨12H-L400
丝杆螺母
Y轴滑台连丝杆
openmv支架
主动轮
