NeekoNoNeko/Engineering_Competition/3D/42步进电机连接部件/42步进电机AND支架装配体.SLDASM

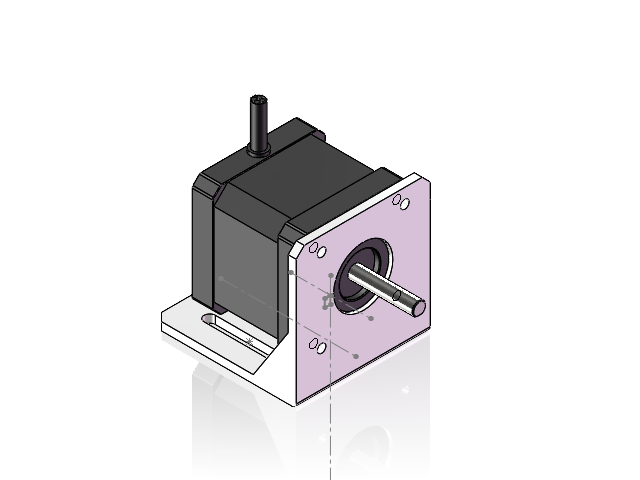
[picture p178: CAD file, 2024-10-24]
3D/42步进电机连接部件/42步进电机AND支架装配体.SLDASM
42电机支架(金属)
42系列两相混合式步进电机[42HS04A]
