NeekoNoNeko/Engineering_Competition/3D/SolidWorks/主控板支撑装配体.SLDASM

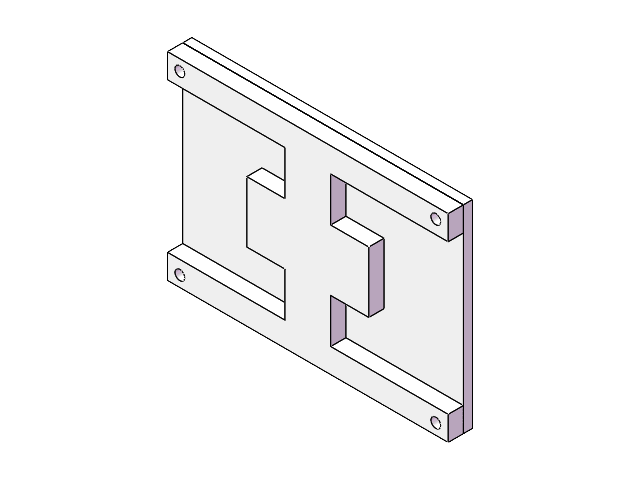
[picture p179: CAD file, 2024-10-24]
3D/SolidWorks/主控板支撑装配体.SLDASM
主控板
主控板支撑
