NeekoNoNeko/Engineering_Competition/(list of files, cad)

Other CAD files:
3D/总装测试/共用配件/KFL08.SLDASM
3D/SolidWorks/备份/KFL08/KFL08_Seperate/KFL08_Seperate.SLDASM
3D/总装测试/共用配件/装配体1.SLDASM
3D/SolidWorks/备份/伺服电机MG996R舵机/temp/Servo Motor MG996R.step
3D/SolidWorks/备份/梯形丝杠╱梯形丝杆螺母[TN8X10X2NR╱200×200Cu]/梯形丝杠╱梯形丝杆螺母[TN8X10X2NR╱200×200Cu]_螺母.SLDPRT
3D/总装测试/X轴/单独配件/2020-L680.SLDPRT
3D/总装测试/紧固件/M3/T型螺母M3.SLDPRT
3D/SolidWorks/备份/伺服电机MG996R舵机/temp/Servo Motor MG996R_舵盘.step
3D/SolidWorks/挡板零件.SLDPRT
3D/总装测试/紧固件/M5套装/T型螺母M5.SLDPRT
3D/总装测试/紧固件/压铸角码/T型螺母M4.SLDPRT
3D/SolidWorks/备份/伺服电机MG996R舵机/temp/Servo Motor MG996R _米字摇臂.step
3D/SolidWorks/备份/钢制KK模组直线滑台TKK100[TKK100-1080]/钢制KK模组直线滑台TKK100[TKK100-1080]_1.SLDPRT
3D/总装测试/X轴/单独配件/2020-L800.SLDPRT
3D/SolidWorks/备份/伺服电机MG996R舵机/temp/Servo Motor MG996R_十字摇臂.step
3D/SolidWorks/备份/梯形丝杠╱梯形丝杆螺母[TN8X10X2NR╱200×200Cu]/丝杠.SLDPRT
3D/SolidWorks/备份/矢量概念机械臂爪标准伺服/temp/gear-link-1.STL
3D/SolidWorks/备份/钢制KK模组直线滑台TKK100[TKK100-1080]/2.SLDPRT
3D/42步进电机连接部件/150mm线轨.SLDPRT
3D/42步进电机连接部件/2020-L300-LH.SLDPRT
3D/42步进电机连接部件/42系列两相混合式步进电机[42HS04A].sldprt
3D/42步进电机连接部件/内置连接件.SLDPRT
3D/42步进电机连接部件/滑台.SLDPRT
3D/SolidWorks/42和直流电机支架.SLDPRT
3D/SolidWorks/42和直流电机支架.STL
3D/SolidWorks/65mm轮子.SLDPRT
3D/SolidWorks/MG513直流减速电机.SLDPRT
3D/SolidWorks/XY连接.SLDPRT
3D/SolidWorks/XY连接1.0.SLDPRT
3D/SolidWorks/XY连接1.0.STL
3D/SolidWorks/XY连接短.SLDPRT
3D/SolidWorks/XY连接短1.0.SLDPRT
3D/SolidWorks/XY连接短1.0.STL
3D/SolidWorks/X轴挡板1.0.SLDPRT
3D/SolidWorks/X轴挡板1.0.STL
3D/SolidWorks/Y轴挡板1.1.SLDPRT
3D/SolidWorks/Y轴挡板1.1.STL
3D/SolidWorks/Z轴挡板2.0.3mf
3D/SolidWorks/Z轴挡板2.0.SLDPRT
3D/SolidWorks/Z轴挡板2.0.STL
3D/SolidWorks/openmv支架.SLDPRT
3D/SolidWorks/openmv支架.STL
3D/SolidWorks/主控板.SLDPRT
3D/SolidWorks/主控板支撑.SLDPRT
3D/SolidWorks/主控板支撑.STL
3D/SolidWorks/备份/1.SLDPRT
3D/SolidWorks/备份/2.SLDPRT
3D/SolidWorks/备份/200mm光轴.SLDPRT
3D/SolidWorks/备份/3.SLDPRT
3D/SolidWorks/备份/4.SLDPRT
3D/SolidWorks/备份/42电机支架(金属).SLDPRT
3D/SolidWorks/备份/42系列两相混合式步进电机[42HS04A].sldprt
3D/SolidWorks/备份/5.SLDPRT
3D/SolidWorks/备份/6.SLDPRT
3D/SolidWorks/备份/SK 光轴支撑[SK8].sldprt
3D/SolidWorks/备份/X轴挡板.SLDPRT
3D/SolidWorks/备份/Y轴挡板1.0.SLDPRT
3D/SolidWorks/备份/Z轴挡板.SLDPRT
3D/SolidWorks/备份/donttouch.STL
3D/SolidWorks/备份/光轴400mm.SLDPRT
3D/SolidWorks/备份/光轴600.SLDPRT
3D/SolidWorks/备份/半圆盘.SLDPRT
3D/SolidWorks/备份/夹具.SLDPRT
3D/SolidWorks/备份/夹子.SLDPRT
3D/SolidWorks/备份/小车.SLDPRT
3D/SolidWorks/备份/左夹子.SLDPRT
3D/SolidWorks/备份/弹性联轴器.SLDPRT
3D/SolidWorks/备份/惰轮固定座.SLDPRT
3D/SolidWorks/备份/惰轮固定座.STL
3D/SolidWorks/备份/托盘.SLDPRT
3D/SolidWorks/备份/托盘.STL
3D/SolidWorks/备份/操作板.SLDPRT
3D/SolidWorks/备份/操作板2.0.SLDPRT
3D/SolidWorks/备份/支架滑台.SLDPRT
3D/SolidWorks/备份/支架滑台.STL
3D/SolidWorks/备份/支架滑台2.0.SLDPRT
3D/SolidWorks/备份/支架滑台2.0.STL
3D/SolidWorks/备份/气泵零件.SLDPRT
3D/SolidWorks/备份/滑台.SLDPRT
3D/SolidWorks/备份/滑台2.0.SLDPRT
3D/SolidWorks/备份/滑台3.0.SLDPRT
3D/SolidWorks/备份/滑台4.0.SLDPRT
3D/SolidWorks/备份/滑台4.0.STL
3D/SolidWorks/备份/滑台5.0max.SLDPRT
3D/SolidWorks/备份/滑台5.0plus.SLDPRT
3D/SolidWorks/备份/滑台支架.SLDPRT
3D/SolidWorks/备份/滑台支架.STL
3D/SolidWorks/备份/滑台连接plusmax.SLDPRT
3D/SolidWorks/备份/滑台连接plusmax.STL
3D/SolidWorks/备份/爪子/滑动1.SLDPRT
3D/SolidWorks/备份/爪子/爪子头.SLDPRT
3D/SolidWorks/备份/爪子掌零件.SLDPRT
3D/SolidWorks/备份/爪子掌零件.STL
3D/SolidWorks/备份/爪子连接.STL
3D/SolidWorks/备份/特征练习-手机支架(1).STL
3D/SolidWorks/备份/电机支架2.0.SLDPRT
3D/SolidWorks/备份/电机支架3.0.SLDPRT
3D/SolidWorks/备份/电机支架4.0.SLDPRT
3D/SolidWorks/备份/电机支架4.0.STL
3D/SolidWorks/备份/电机支架5.0.SLDPRT
3D/SolidWorks/备份/电机支架5.0.STL
3D/SolidWorks/备份/电机支架滑台2.0.SLDPRT
3D/SolidWorks/备份/电机支架滑台2.0.STL
3D/SolidWorks/备份/直线轴承2.0.SLDPRT
3D/SolidWorks/备份/矢量概念机械臂爪标准伺服/temp/arm-link.STL
3D/SolidWorks/备份/矢量概念机械臂爪标准伺服/temp/arm-top-plate.STL
3D/SolidWorks/备份/矢量概念机械臂爪标准伺服/temp/screw-1.STL
3D/SolidWorks/备份/矢量概念机械臂爪标准伺服/temp/screw-2.STL
3D/SolidWorks/备份/矢量概念机械臂爪标准伺服/temp/servo-shaft.STL
3D/SolidWorks/备份/药板.SLDPRT
3D/SolidWorks/备份/药板.STL
3D/SolidWorks/备份/近电机端2.0.STL
3D/SolidWorks/备份/近电机端3.0.SLDPRT
3D/SolidWorks/备份/近电机端3.0.STL
3D/SolidWorks/备份/远电机端.3.0.SLDPRT
3D/SolidWorks/备份/远电机端.3.0.STL
3D/SolidWorks/备份/远电机端.SLDPRT
3D/SolidWorks/备份/远电机端2.0.SLDPRT
3D/SolidWorks/备份/远电机端2.0.STL
3D/SolidWorks/备份/远电机端3.0.SLDPRT
3D/SolidWorks/备份/远电机端3.0中.SLDPRT
3D/SolidWorks/备份/远电机端3.0中.STL
3D/SolidWorks/备份/远电机端3.0右.SLDPRT
3D/SolidWorks/备份/远电机端3.0右.STL
3D/SolidWorks/备份/远电机端3.0左.SLDPRT
3D/SolidWorks/备份/远电机端3.0左.STL
3D/SolidWorks/备份/远电机端4.0.STL
3D/SolidWorks/备份/远电机端小布丁5.2.SLDPRT
3D/SolidWorks/备份/远电机端小布丁5.2.STL
3D/SolidWorks/备份/远电机端小布丁5.SLDPRT
3D/SolidWorks/备份/远电机端小布丁5.STL
3D/SolidWorks/备份/远电机端小车.032.0.SLDPRT
3D/SolidWorks/备份/远电机端小车.032.0.STL
3D/SolidWorks/备份/远电机端小车.SLDPRT
3D/SolidWorks/备份/远电机端小车.STL
3D/SolidWorks/备份/远电机端小车2.0.SLDPRT
3D/SolidWorks/备份/连接横梁.SLDPRT
3D/SolidWorks/备份/连接横梁.STL
3D/SolidWorks/备份/连接横梁2.SLDPRT
3D/SolidWorks/备份/连接横梁2.STL
3D/SolidWorks/备份/零件1.STL
3D/SolidWorks/备份/零件2.SLDPRT
3D/SolidWorks/支架滑台.SLDPRT
3D/SolidWorks/气泵.SLDPRT
3D/SolidWorks/气泵.STL
3D/SolidWorks/滑台4.0.SLDPRT
3D/SolidWorks/瓶子含瓶盖.SLDPRT
3D/SolidWorks/电机支架4.0.SLDPRT
3D/SolidWorks/直流减速电机支架.SLDPRT
3D/SolidWorks/药瓶固定钉.SLDPRT
3D/SolidWorks/药瓶固定钉.STL
3D/SolidWorks/药瓶拨片.SLDPRT
3D/SolidWorks/药瓶拨片.STL
3D/SolidWorks/药瓶远电机端支架.SLDPRT
3D/SolidWorks/药瓶远电机端支架.STL
3D/SolidWorks/近电机端2.0.SLDPRT
3D/SolidWorks/远电机端2.0.SLDPRT
3D/SolidWorks/远电机端4.0.SLDPRT
3D/SolidWorks/钩子.SLDPRT
3D/SolidWorks/钩子.STL
3D/SolidWorks/零件1.SLDPRT
3D/SolidWorks/零件3.SLDPRT
3D/SolidWorks/高连接横梁右2.SLDPRT
3D/SolidWorks/高连接横梁右2.STL
3D/SolidWorks/高连接横梁右远电机端.SLDPRT
3D/SolidWorks/高连接横梁右远电机端.STL
3D/SolidWorks/高连接横梁左2.SLDPRT
3D/SolidWorks/高连接横梁左2.STL
3D/总装测试/STL/42步进电机连接部件Y.STL
3D/总装测试/STL/42电机支架(塑料).STL
3D/总装测试/STL/Y轴滑台连丝杆.STL
3D/总装测试/STL/Z轴2垫高Y.STL
3D/总装测试/STL/丝杆组合套.STL
3D/总装测试/STL/丝杆螺母封盖Y.STL
3D/总装测试/STL/丝杆螺母封盖加主控.STL
3D/总装测试/STL/丝杆轴承固定件.STL
3D/总装测试/STL/丝杆轴承固定件加长.STL
3D/总装测试/STL/光轴固定座.STL
3D/总装测试/STL/光轴连接器Y.STL
3D/总装测试/STL/滑台to型材转换板加大.STL
3D/总装测试/STL/滑台to型材转换板加大加主控Y.STL
3D/总装测试/STL/电机座.STL
3D/总装测试/STL/药板2.STL
3D/总装测试/STL/防撞块.STL
3D/总装测试/STL/防撞块加长.STL
3D/总装测试/X轴/单独配件/2020L669.SLDPRT
3D/总装测试/X轴/单独配件/防撞块加长.SLDPRT
3D/总装测试/Y轴/2020-L620.SLDPRT
3D/总装测试/Y轴/2020L620.STEP
3D/总装测试/Z轴/2020-L500.SLDPRT
3D/总装测试/Z轴/2040-L60.SLDPRT
3D/总装测试/Z轴/EDLA-S1-M5-L10.SLDPRT
3D/总装测试/Z轴/M3螺母.SLDPRT
3D/总装测试/Z轴/TPAA-N-6-M5.SLDPRT
3D/总装测试/Z轴/TPDD-206-2020L-ZP.SLDPRT
3D/总装测试/Z轴/T型滑台连型材.SLDPRT
3D/总装测试/Z轴/Z轴2垫高.SLDPRT
3D/总装测试/Z轴/丝杆and光轴-L300.SLDPRT
3D/总装测试/Z轴/丝杆组合套.SLDPRT
3D/总装测试/Z轴/丝杆螺母封盖.SLDPRT
3D/总装测试/Z轴/丝杆螺母封盖加主控.SLDPRT
3D/总装测试/Z轴/主控板支撑.SLDPRT
3D/总装测试/Z轴/侧面支撑.SLDPRT
3D/总装测试/Z轴/十字槽盘头螺钉M3-L45.SLDPRT
3D/总装测试/Z轴/浇铸槽内连接件.SLDPRT
3D/总装测试/Z轴/滑台标准型.SLDPRT
3D/总装测试/共用配件/42步进电机连接部件.SLDPRT
3D/总装测试/共用配件/42系列两相混合式步进电机[42HS04A].sldprt
3D/总装测试/共用配件/71273C4CE3CE214AF15714B85C379AF9.SLDPRT(1).SLDPRT
3D/总装测试/共用配件/丝杆螺母.SLDPRT
3D/总装测试/共用配件/丝杆轴承固定件.SLDPRT
3D/总装测试/共用配件/主动轮.SLDPRT
3D/总装测试/共用配件/刚性联轴器.SLDPRT
3D/总装测试/共用配件/滑台to型材转换板加大.SLDPRT
3D/总装测试/共用配件/滑台加长型12H-L400.SLDPRT
3D/总装测试/共用配件/线轨12H-L400.SLDPRT
3D/总装测试/共用配件/防撞块.SLDPRT
3D/总装测试/外框/2020-L511.SLDPRT
3D/总装测试/外框/光轴连接器.SLDPRT
3D/总装测试/外框/法兰型导向轴支座.SLDPRT
3D/总装测试/紧固件/M3/M3螺母.SLDPRT
3D/总装测试/紧固件/M3/内六角圆柱头螺钉M3-L10.SLDPRT
3D/总装测试/紧固件/M3/内六角圆柱头螺钉M3-L12.SLDPRT
3D/总装测试/紧固件/M3/内六角圆柱头螺钉M3-L16.SLDPRT
3D/总装测试/紧固件/M3/内六角圆柱头螺钉M3-L20.SLDPRT
3D/总装测试/紧固件/M3/十字槽沉头螺钉M3-L18.SLDPRT
3D/总装测试/紧固件/M3/十字槽沉头螺钉M3-L6.SLDPRT
3D/总装测试/紧固件/M3/十字槽沉头螺钉M3-L8.SLDPRT
3D/总装测试/紧固件/M3/十字槽沉头螺钉M3L-20.SLDPRT
3D/总装测试/紧固件/M3/十字槽盘头螺钉M3-L6.SLDPRT
3D/总装测试/紧固件/M5套装/内六角圆柱头螺钉M5-L6.SLDPRT
3D/总装测试/紧固件/M5套装/内六角圆柱头螺钉M5-L8.SLDPRT
3D/总装测试/紧固件/M5套装/螺母M5.SLDPRT
3D/总装测试/药板2.SLDPRT
3D/滑台连型材/2040-50.SLDPRT
3D/滑台连型材/8FE104D78F57084BAF3C98AD11D37C0D.SLDPRT(1).SLDPRT
3D/滑台连型材/TXCJ-H6-6-2020-L300-LDH.SLDPRT
3D/滑台连型材/内六角圆柱头螺钉M3-6mm(min_7.5).SLDPRT
3D/滑台连型材/内六角圆柱头螺钉超薄头型EDDA-M3-L8.SLDPRT
3D/滑台连型材/内六角平圆头螺钉.SLDPRT
3D/滑台连型材/十字槽沉头螺钉M3-L10.SLDPRT
3D/滑台连型材/平垫圈M5.SLDPRT
3D/滑台连型材/滑块螺母M4.SLDPRT
