NeekoNoNeko/Engineering_Competition/file/SCH_Schematic1_2024-08-12.pdf

# 16V降为12V

复位按键 | 备用按键 | 下载程序 | 电源开关

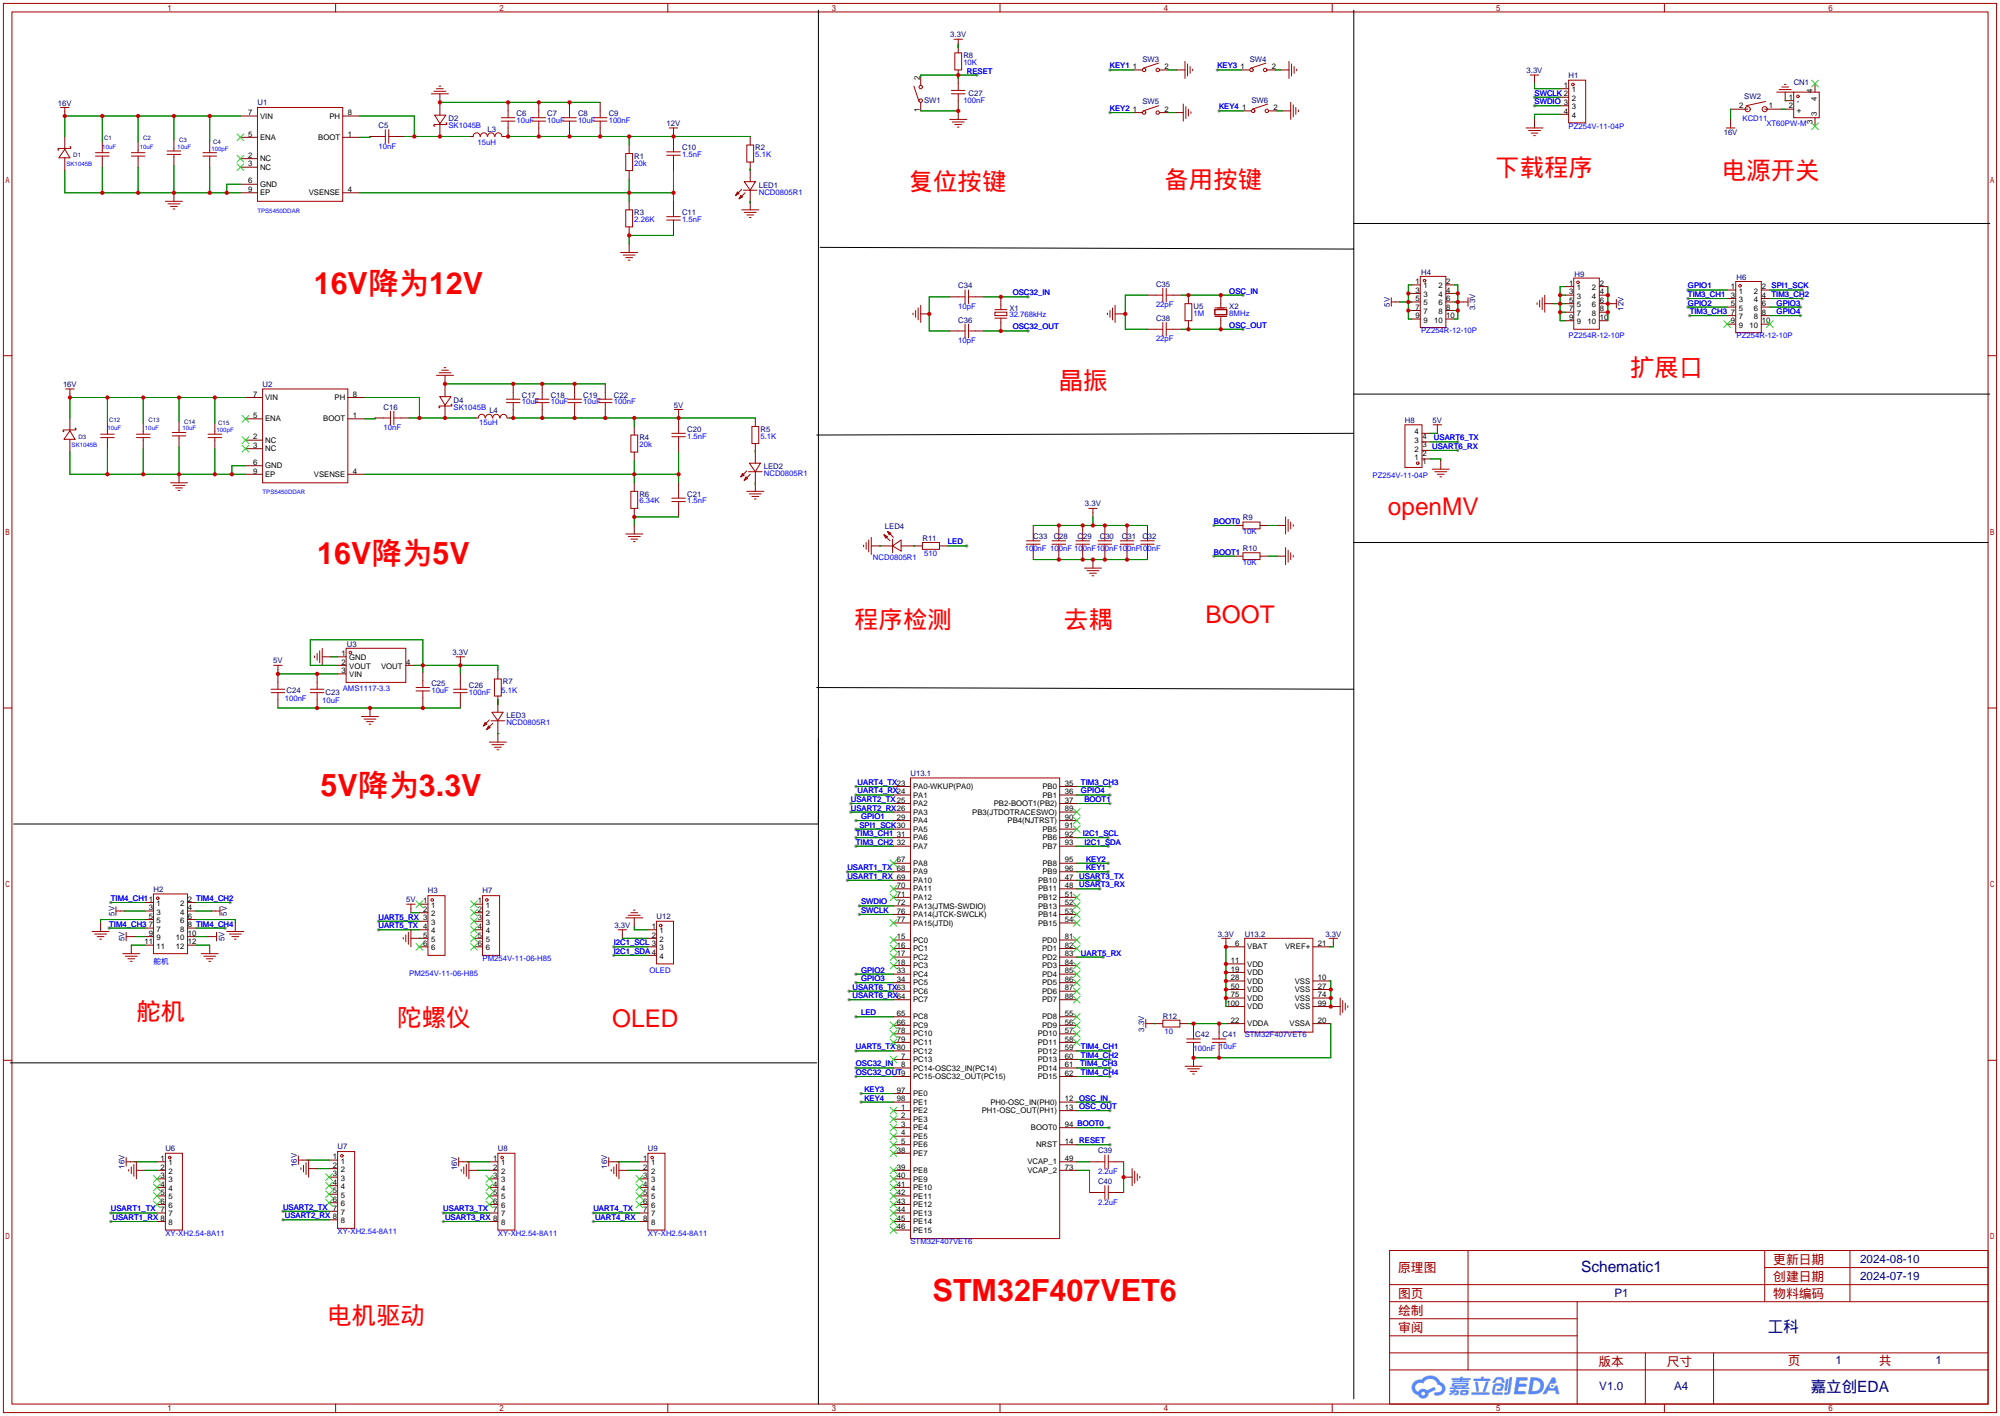
[picture p180: page 1]
