NeekoNoNeko/Engineering_Competition/stm32f407vet6/Project/Project/Core/Src/main.c

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
/* Includes ------------------------------------------------------------------*/
#include "main.h"
#include "tim.h"
#include "usart.h"
#include "gpio.h"

/* USER CODE BEGIN Includes */

#include "delay.h"
#include "Emm_V5.h"
#include "Servo.h"
#include "key.h"
#include "motor.h"
#include "position.h"
#include "OLED.h"
#include "pump.h"
#include "Servo.h"

/* USER CODE END Includes */


void SystemClock_Config(void);
/* USER CODE BEGIN PFP */

void OLED_Showcolor(uint8_t colorflag1, uint8_t colorflag2);

/* USER CODE END PFP */

/* USER CODE BEGIN 0 */

uint8_t KeyNum;

//int8_t Speed;		//拧瓶盖电机速度，可设置正反转，范围 -100~100
__IO uint16_t Emm_speed = 1000;		//42步进电机运行速度，定位电机（即X,Y,Z轴电机）
__IO uint8_t Emm_Z_acc = 100;		//Z轴定位电机加速度
__IO uint8_t Emm_X_acc = 255;		//X轴定位电机加速度
__IO uint8_t Emm_Y_acc = 255;		//Y轴定位电机加速度

/*openmv*/
__IO float openmv_x, openmv_y;			//openmv坐标数据
__IO uint8_t openmv_colourflag_plate;	//openmv颜色标志位，1 red; 2 green; 3 blue，显示在oled上
__IO uint8_t openmv_colourflag_bottle;	//openmv颜色标志位，1 red; 2 green; 3 blue，显示在oled上
__IO uint8_t openmv_statusflag;			//openmv状态标志位，1 药板; 2 药瓶; 3 拧瓶盖; #未使用#4 不行动，只能由中断打断
__IO uint8_t openmv_quadrantflag;		//openmv象限标志位，1 第一象限; 2 第二象限; 3 第三象限; 4 第四象限		
uint8_t send_statusdata[5] = {0xA1, 0xA2, 0, 0, 0xFE};		//发送给openmv的状态数据包
		//位2：返回给openmv的状态标志位，0 默认位; 1 到位准备抓取; 2 完成抓取; 3 开始识别色卡; #未使用#4 发送启动信号给主控单片机
		//位3：模式位（药板、药瓶 or 瓶盖），0 默认位; 1 药板; 2 药瓶; 3 瓶盖

/*托盘上各物品位置，药板、药瓶、托盘*/
__IO float plate_x = 24.681, plate_y = 5.872;				//药板位置，坐标信息为药板中心点位置
__IO float bottle_x = 28.672, bottle_y = 23.697;			//药瓶位置
__IO float cap_x = 15.059, cap_y = 23.581;					//瓶盖位置
__IO float tray_x = 11.292 + 1, tray_y = 12.495 - 3;		//托盘位置，坐标信息为托盘中心点位置
															//-1 +3是OpenMV plus，原OpenMV不需要加减

float err_x = -5.8, err_y = -0.45;					//视觉模块与气泵的偏移量
float plate_err_x = -4.0, plate_err_y = -2.0;		//药板中心与药板孔的偏移量
/* USER CODE END 0 */

/**
  * @brief  The application entry point.
  * @retval int
  */
int main(void)
{
  /* USER CODE BEGIN 1 */
	
	__IO uint8_t i = 0;
//	__IO uint8_t j = 0;
	__IO uint8_t times_plate = 0;
	__IO uint8_t times_bottle = 0;
	__IO uint8_t angle = 0;

  /* USER CODE END 1 */

  /* MCU Configuration--------------------------------------------------------*/

  /* Reset of all peripherals, Initializes the Flash interface and the Systick. */
  HAL_Init();

  /* Configure the system clock */
  SystemClock_Config();

  /* Initialize all configured peripherals */
  MX_GPIO_Init();
  MX_UART4_Init();
  MX_UART5_Init();
  MX_USART1_UART_Init();
  MX_USART2_UART_Init();
  MX_USART3_UART_Init();
  MX_TIM3_Init();
  MX_TIM4_Init();
  /* USER CODE BEGIN 2 */
  
  OLED_Init();
  delay_init(168);
  Servo_SetAngle(0, 3);
  
  /*延时等待3s初始化完成*/
//  delay_ms(3000);
  
//  XYZ_Return_Origin(2);		//初始化回零

  /* USER CODE END 2 */

  /* Infinite loop */
  /* USER CODE BEGIN WHILE */
  while (1)
  {
    /* USER CODE END WHILE */

    /* USER CODE BEGIN 3 */
	  
	/*按键值*/
	KeyNum = key_num();
	  
	i++;
	OLED_ShowNum(0, 0, i, 3, OLED_8X16);
	OLED_Update();
	
/*****************************************************************************************************/
	if(KeyNum == 1 || openmv_statusflag == 1)
	{	
		send_statusdata[3] = 1;		//模式为药板
		HAL_UART_Transmit(&huart5, send_statusdata, 5, 50);
		
		/*******************************************************************************/
		OLED_ShowString(0, 16, "plate :", OLED_6X8);
		OLED_ShowNum(42, 16, KeyNum, 2, OLED_6X8);
		OLED_Update();

		Tray_position();	//定位托盘位置
		
		/*发送到位标志给视觉，让视觉启动识别*/
		send_statusdata[2] = 1;		//到位视觉识别
		HAL_UART_Transmit(&huart5, send_statusdata, 5, 50);
		delay_ms(5000);		//预留视觉检测时间
		
		/*******************************************************************************/
		/*显示视觉传输过来的药丸相对坐标数据*/
		OLED_ShowFloatNum(0, 24, openmv_x, 3, 3, OLED_6X8);
		OLED_ShowFloatNum(0, 32, openmv_y, 3, 3, OLED_6X8);
		OLED_Update();
		
		OLED_Showcolor(openmv_colourflag_plate, openmv_colourflag_bottle);		//显抓取药丸颜色
		
		/*******************************************************************************/
		
		/*发送抓取完成标志给视觉，让其停止识别*/
		send_statusdata[2] = 2;		//已完成抓取视觉可关闭
		HAL_UART_Transmit(&huart5, send_statusdata, 5, 50);
		
		/*开始定位药丸*/
		delay_ms(1000);
		X_Emm_V5_position(tray_x + openmv_x + err_x, Emm_speed);
		Y_Emm_V5_position(tray_y + openmv_y + err_y, Emm_speed);
		while(x_arrive_check() == false || y_arrive_check() == false);

		Z_Emm_V5_position(1.55, Emm_speed);
		while(z_arrive_check() == false);
		
		/*******************************************************************************/
		pump_control(1);
		valve_control(0);
		
		delay_ms(1000);		//预留气泵吸球稳定时间
		Z_Emm_V5_position(12, Emm_speed);
		while(z_arrive_check() == false);
		
		/*定位药板位置*/
		X_Emm_V5_position(plate_x + plate_err_x + err_x, Emm_speed);
		Y_Emm_V5_position(plate_y + plate_err_y + err_y, Emm_speed);
		while(x_arrive_check() == false || y_arrive_check() == false);
		
		Z_Emm_V5_position(2.4, Emm_speed);
		while(z_arrive_check() == false);
		
		/*******************************************************************************/
		Plate_HolePitch_position();		//药板孔偏移坐标计算

//		j ++;
//		if(j == 1)
//		{
//			plate_y = plate_y + 0.4f;
//		}
//		else if(j == 2)
//		{
//			plate_y = plate_y + 0.4f;
//		}
//		else if(j == 3)
//		{
//			plate_y = plate_y - 0.8f;
//			plate_x = plate_x + 0.4f;
//		}
//		else if(j == 4)
//		{
//			plate_y = plate_y + 0.4f;
//		}
//		else if(j == 5)
//		{
//			plate_y = plate_y + 0.4f;
//		}
		
		/*******************************************************************************/
		pump_control(0);
		valve_control(1);
		delay_ms(500);
		valve_control(0);		//电磁阀不能长时间打开，否则可能会发热严重

		/*******************************************************************************/
		times_plate++;			//抓取药丸到药板次数，即已抓取药丸到药板的个数
		OLED_ShowNum(66, 16, times_plate, 3, OLED_6X8);
		OLED_Update();
		
		if(times_plate == 6)
		{
			send_statusdata[3] = 2;		//模式转化为药瓶
			HAL_UART_Transmit(&huart5, send_statusdata, 5, 50);
		}
		
//		openmv_statusflag = 0;		//清零操作
	}
	
/*****************************************************************************************************/
	if(KeyNum == 2 || openmv_statusflag == 2)
	{
		send_statusdata[3] = 2;		//模式转化为药瓶
		HAL_UART_Transmit(&huart5, send_statusdata, 5, 50);
		
		/*******************************************************************************/
		OLED_ShowString(0, 16, "bottle:", OLED_6X8);
		OLED_ShowNum(42, 16, KeyNum, 2, OLED_6X8);
		OLED_Update();

		Tray_position();	//定位托盘位置
		
		/*发送到位标志给视觉，让视觉启动识别*/
		send_statusdata[2] = 1;		//到位视觉识别
		HAL_UART_Transmit(&huart5, send_statusdata, 5, 50);
		delay_ms(5000);		//预留视觉检测时间
		
		/*******************************************************************************/
		/*显示视觉传输过来的药丸相对坐标数据*/
		OLED_ShowFloatNum(0, 24, openmv_x, 3, 3, OLED_6X8);
		OLED_ShowFloatNum(0, 32, openmv_y, 3, 3, OLED_6X8);
		OLED_Update();
		
		OLED_Showcolor(openmv_colourflag_plate, openmv_colourflag_bottle);		//显抓取药丸颜色
		
		/*******************************************************************************/
		/*发送抓取完成标志给视觉，让其停止识别*/
		send_statusdata[2] = 2;		//已完成抓取视觉可关闭
		HAL_UART_Transmit(&huart5, send_statusdata, 5, 50);
		
		/*开始定位药丸*/
		X_Emm_V5_position(tray_x + openmv_x + err_x, Emm_speed);
		Y_Emm_V5_position(tray_y + openmv_y + err_y, Emm_speed);
		while(x_arrive_check() == false || y_arrive_check() == false);

		Z_Emm_V5_position(1.55, Emm_speed);
		while(z_arrive_check() == false);
		
		/*******************************************************************************/
		pump_control(1);
		valve_control(0);
		
		delay_ms(1000);		//预留气泵吸球稳定时间
		Z_Emm_V5_position(12, Emm_speed);
		while(z_arrive_check() == false);
		
		/*定位药瓶位置*/
		X_Emm_V5_position(bottle_x + err_x, Emm_speed);
		Y_Emm_V5_position(bottle_y + err_y, Emm_speed);
		while(x_arrive_check() == false || y_arrive_check() == false);
		
		Z_Emm_V5_position(7.55, Emm_speed);
		while(z_arrive_check() == false);
		
		/*******************************************************************************/
		pump_control(0);
		valve_control(1);
		delay_ms(500);
		valve_control(0);	//电磁阀不能长时间打开，否则可能会发热严重
		
		/*******************************************************************************/
		times_bottle++;		//抓取药丸到药瓶次数，即已抓取药丸到药瓶的次数
		OLED_ShowNum(90, 16, times_bottle, 3, OLED_6X8);
		OLED_Update();
		
		if(times_bottle == 6)
		{
			KeyNum = 3;
		}
		
//		openmv_statusflag = 0;
	}
	
/*****************************************************************************************************/
	if(KeyNum == 3 || openmv_statusflag == 3)
	{
		OLED_ShowString(0, 16, "cap   :", OLED_6X8);
		OLED_ShowNum(42, 16, KeyNum, 2, OLED_6X8);
		OLED_Update();
		
		/*******************************************************************************/
		Z_Emm_V5_position(12, Emm_speed);
		while(z_arrive_check() == false);
		
		/*定位瓶盖位置*/
		X_Emm_V5_position(cap_x + err_x, Emm_speed);
		Y_Emm_V5_position(cap_y + err_y, Emm_speed);
		while(x_arrive_check() == false || y_arrive_check() == false);
		
		Z_Emm_V5_position(1.3, Emm_speed);
		while(z_arrive_check() == false);
		
		/*******************************************************************************/
		pump_control(1);
		valve_control(0);
		
		/*******************************************************************************/
		delay_ms(1000);		//预留气泵吸瓶盖稳定时间
		Z_Emm_V5_position(12, Emm_speed);
		while(z_arrive_check() == false);
		
		/*定位药瓶位置*/
		X_Emm_V5_position(bottle_x + err_x, Emm_speed);
		Y_Emm_V5_position(bottle_y + err_y, Emm_speed);
		while(x_arrive_check() == false || y_arrive_check() == false);
		
		Z_Emm_V5_position(9, Emm_speed);
		while(z_arrive_check() == false);
		
		/*******************************************************************************/
		pump_control(0);
		valve_control(1);
		
		delay_ms(1000);
		Clamp_Emm_V5_position(10.35, 100, 30);		//位置，速度，加速度
		
		Z_Emm_V5_position(12, Emm_speed);
		while(z_arrive_check() == false);
		
		valve_control(0);	//电磁阀不能长时间打开，否则可能会发热严重
		
		/*******************************************************************************/
		/*这里可尝试直接回零*/
		OLED_ShowString(0, 16, "retrun:", OLED_6X8);
		OLED_ShowNum(42, 16, KeyNum, 2, OLED_6X8);
		OLED_Update();
		
		XYZ_Return_Origin(2);
		
		/*******************************************************************************/
//		Motor_SetSpeed(100);
//		delay_ms(1000);
		delay_ms(3000);
		Motor_SetSpeed(-100);
		delay_ms(3200);
		Motor_SetSpeed(0);
	}
	
/*****************************************************************************************************/
	if(KeyNum == 4)
	{
		OLED_ShowString(0, 16, "card  :", OLED_6X8);
		OLED_ShowNum(42, 16, KeyNum, 2, OLED_6X8);
		OLED_Update();
		
//		Z_Emm_V5_position(12, 500);
//		while(z_arrive_check() == false);
//		
//		XYZ_Return_Origin(2);
		
		/*发送检测色卡标志位给视觉，让其启动色卡识别*/
		send_statusdata[2] = 3;		//识别色卡颜色
		HAL_UART_Transmit(&huart5, send_statusdata, 5, 50);
		
		send_statusdata[2] = 0;
		
		OLED_Showcolor(openmv_colourflag_plate, openmv_colourflag_bottle);		//显抓取药丸颜色
		
	}
  }
  /* USER CODE END 3 */
}

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
/* USER CODE BEGIN 4 */

void OLED_Showcolor(uint8_t colorflag1, uint8_t colorflag2)
{
	if(colorflag1 == 1)
	{
		OLED_ShowString(0, 48, "plate:Red  ", OLED_6X8);
		OLED_Update();
	}
	else if(colorflag1 == 2)
	{
		OLED_ShowString(0, 48, "plate:Green", OLED_6X8);
		OLED_Update();
	}
	else if(colorflag1 == 3)
	{
		OLED_ShowString(0, 48, "plate:Bule ", OLED_6X8);
		OLED_Update();
	}
	
	if(colorflag2 == 1)
	{
		OLED_ShowString(0, 56, "bottle:Red  ", OLED_6X8);
		OLED_Update();
	}
	else if(colorflag2 == 2)
	{
		OLED_ShowString(0, 56, "bottle:Green", OLED_6X8);
		OLED_Update();
	}
	else if(colorflag2 == 3)
	{
		OLED_ShowString(0, 56, "bottle:Bule ", OLED_6X8);
		OLED_Update();
	}
}

/* USER CODE END 4 */
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
