NeekoNoNeko/Engineering_Competition/stm32f407vet6/Project/Project/BSP/pump.c

#include "pump.h"

/**
  * @brief  气泵控制函数
  * @param  
  * @retval 无
  */
void pump_control(uint8_t state)
{
	if(state == 0)
	{
		__HAL_TIM_SetCompare(&htim4, TIM_CHANNEL_1, 500);
	}
	else if(state != 0)
	{
		__HAL_TIM_SetCompare(&htim4, TIM_CHANNEL_1, 2500);
	}
}

/**
  * @brief  电磁阀控制函数
  * @param  
  * @retval 无
  */
void valve_control(uint8_t state)
{
	if(state == 0)
	{
		__HAL_TIM_SetCompare(&htim4, TIM_CHANNEL_2, 500);
	}
	else if(state != 0)
	{
		__HAL_TIM_SetCompare(&htim4, TIM_CHANNEL_2, 2500);
	}
}
