NeekoNoNeko/Engineering_Competition/(commit log)

2024-09-19 添加视觉的内容
2024-09-19 补上了hightry
2024-09-19 添加了色卡列表检测
2024-09-19 添加了stm32Project
2024-09-19 初始位赋值analyzeData.position = 1
2024-09-19 优化速度修改机制
    新增了全局电机速度变量，便于修改总体电机速度；新增了z轴的加速度全局变量，便于修改z轴加速度；修改了固定药瓶电机的函数封装，引出固定瓶身的加速度修改变量
2024-09-19 操作中间产生文件
2024-09-21 增加清零标志位
2024-09-21 模式切换写死了
2024-09-21 调节了精度
2024-09-21 更新 Project.uvguix.Shadow
2024-09-21 生成了一些中间文件，添加了一下注释
2024-09-29 比赛文件、设计报告、机器结构图纸
2024-10-01 创建分支添加备份
    [1.SLDPRT, 150mm2020.SLDPRT, 150mm线轨.SLDPRT, 2.SLDPRT, 200mm光轴.SLDPRT, 3.SLDPRT, 4.SLDPRT, 42和直流电机支架.SLDPRT]
2024-10-03 临时备份
    [2020-L300-LH.SLDPRT, 2020L装配体.SLDASM, 2040-50.SLDPRT, 2040-L60.SLDPRT, 20系列T型螺母M4.SLDPRT, 42步进电机AND支架装配体.SLDASM, 42步进电机连接部件.SLDPRT, 42步进电机连接部件装配体.SLDASM]
2024-10-15 增加了舵机驱动代码
2024-10-15 创建 2024年广东省工科大学生综合实验技能竞赛评分标准.pdf
2024-10-19 杂七杂八
    [42步进电机连接部件Y.STL, 42电机支架(塑料).STL, KFL08.SLDASM, T型滑台连型材Y.STL, Y轴滑台连丝杆.SLDPRT, Y轴滑台连丝杆.STL, Z轴2垫高Y.STL, 丝杆组合套.STL]
2024-10-19 很多修改
2024-10-20 新增控制代码思路
2024-10-22 添加丝杆轴承固定件加长
    [丝杆轴承固定件加长.SLDPRT, 丝杆轴承固定件加长.STL]
2024-10-24 搞定了拧瓶盖
    [200mm光轴.SLDPRT, 42电机支架(金属).SLDPRT, 42系列两相混合式步进电机[42HS04A].sldprt, 65mm轮子.SLDPRT, MG513直流减速电机.SLDPRT, 弹性联轴器.SLDPRT, 操作板.SLDPRT, 瓶子含瓶盖.SLDPRT]
