NeekoNoNeko/Engineering_Competition/(notices)

Notices in the files:
stm32f407vet6/Project/Project/SYSTEM/delay.h:
@license Copyright (c) 2020-2032, ¹ãÖÝÊÐÐÇÒíµç×Ó¿Æ¼¼ÓÐÏÞ¹«Ë¾
stm32f407vet6/Project/Project/SYSTEM/delay.c:
@license Copyright (c) 2022-2032, ¹ãÖÝÊÐÐÇÒíµç×Ó¿Æ¼¼ÓÐÏÞ¹«Ë¾
